chirpy2605/voron/general/DB_Ornament/README.md

# Dragon Burner Ornament for 2023

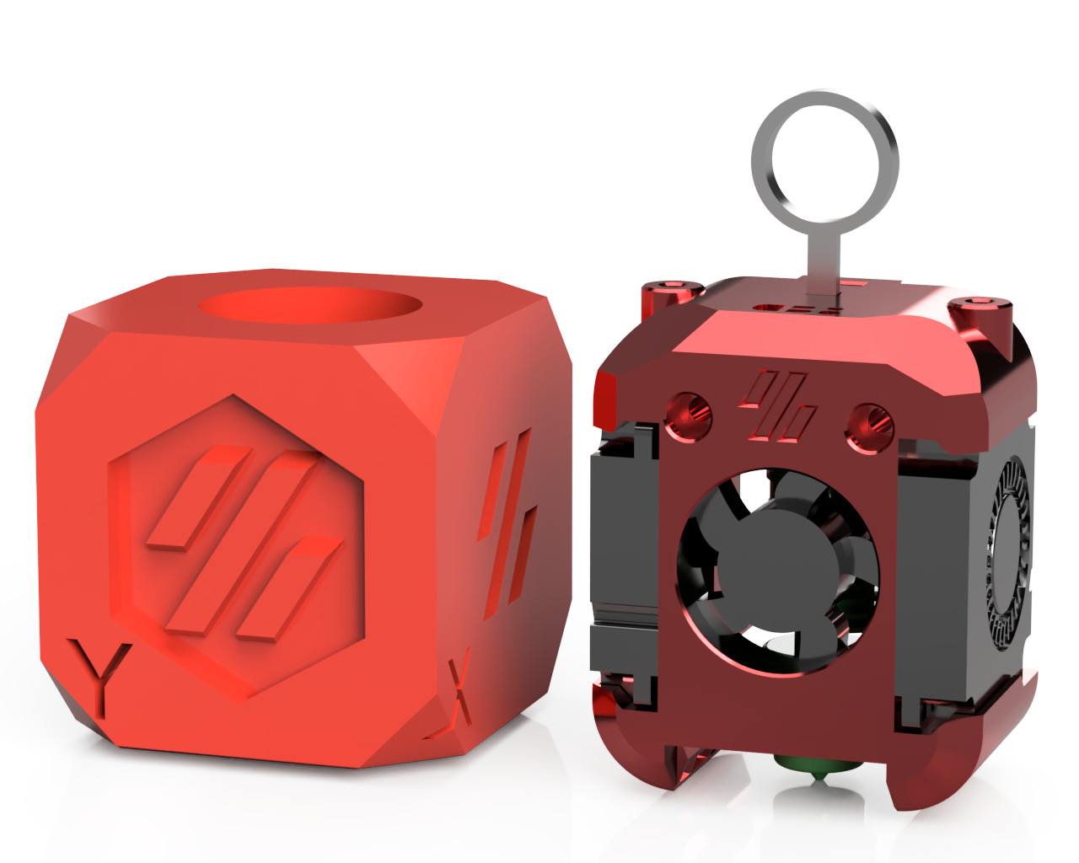
[picture p65: general/DB_Ornament/DB_Ornament.png]
Overview Image


### Assembly:

Use a small amount of super glue inside the "hotend" to stick the hanger in place once passed through the "cowl"
