chirpy2605/voron/general/Large_Voron_Mounts/README.md

These parts have moved to [Alternative Voron Mounts](../Alternative_Voron_Mounts)
