chirpy2605/voron/V0/v0.2_Stuff/readme.md

# Voron v0.2 Mods:

#### Z Cover to prevent stuff falling through the chamber into the lead screw hole:

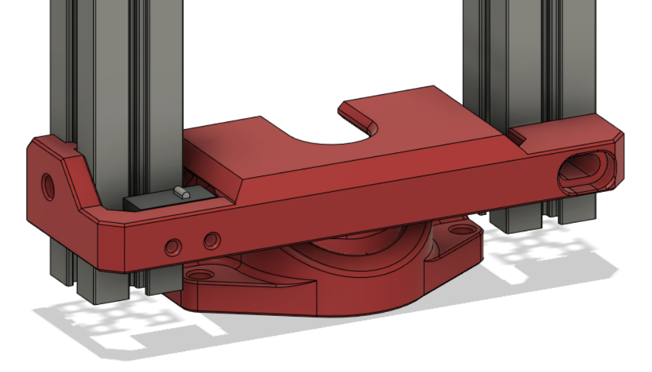
[picture p125: V0/v0.2_Stuff/images/[a]_Z_Cover.png]
Z Cover


---

#### Rear Panel Hex Mesh mod to [Printables](https://www.printables.com/model/153997-voron-v01-rear-panel-with-better-cooling):

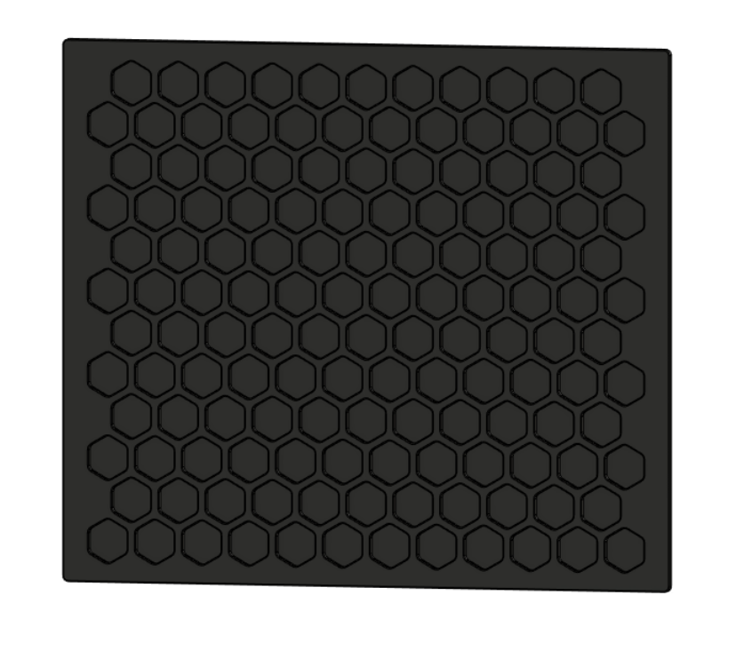
[picture p126: V0/v0.2_Stuff/images/Rear_Panel_Hex_Mesh.png]


---

#### MGN9C X Carriage with inserts mod to [VoronUsers/printer_mods/ruiqimao/V0.2_MGN9C_X at v0.2-mgn9c · ruiqimao/VoronUsers · GitHub](https://github.com/ruiqimao/VoronUsers/tree/v0.2-mgn9c/printer_mods/ruiqimao/V0.2_MGN9C_X):

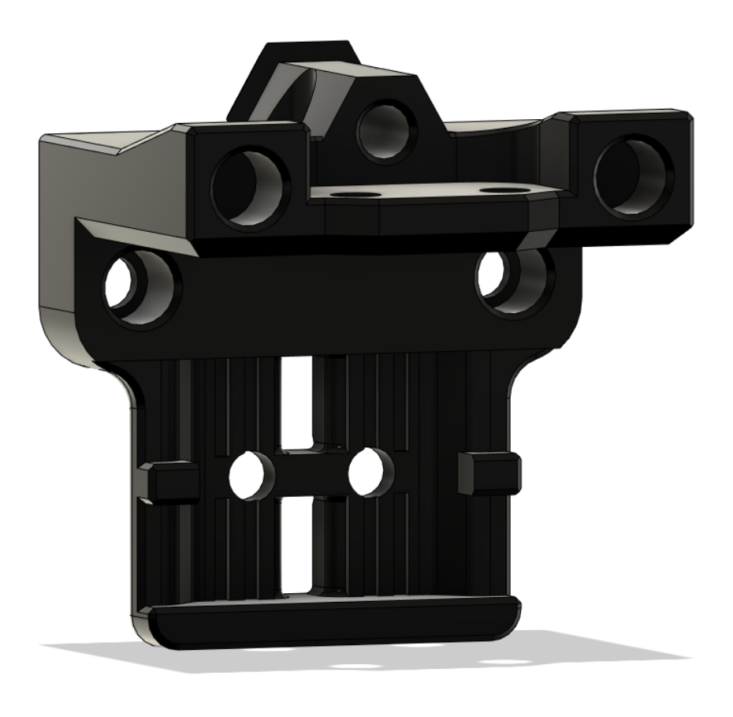
[picture p127: V0/v0.2_Stuff/images/MGN9C_X_Carriage_Inserts.png]


---

#### DIN Rail mounts:

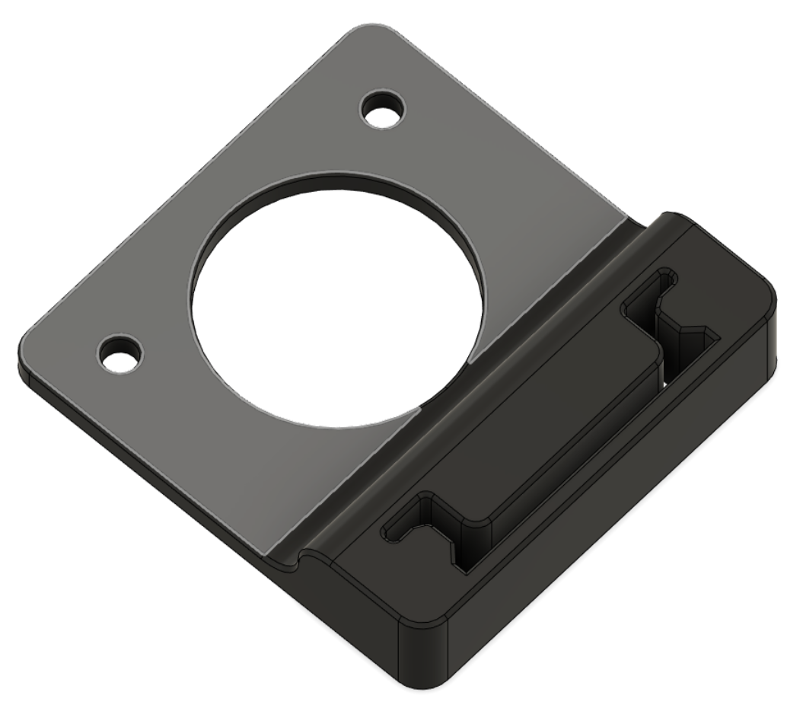
[picture p128: V0/v0.2_Stuff/images/DIN_Rail_Mount_x2.png]


---

#### Gap Seals:

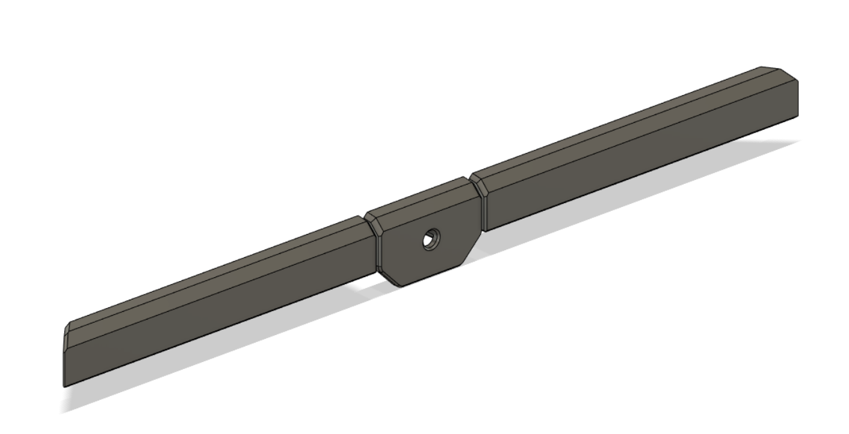
[picture p129: V0/v0.2_Stuff/images/Gap_Seal.png]
Gap Seals


---

#### Rear Skirt Keystone Mesh mod to   [VoronUsers/printer_mods/hartk1213/Voron0.2_Rear_Keystone_Skirt at master · VoronDesign/VoronUsers · GitHub](https://github.com/VoronDesign/VoronUsers/tree/master/printer_mods/hartk1213/Voron0.2_Rear_Keystone_Skirt):

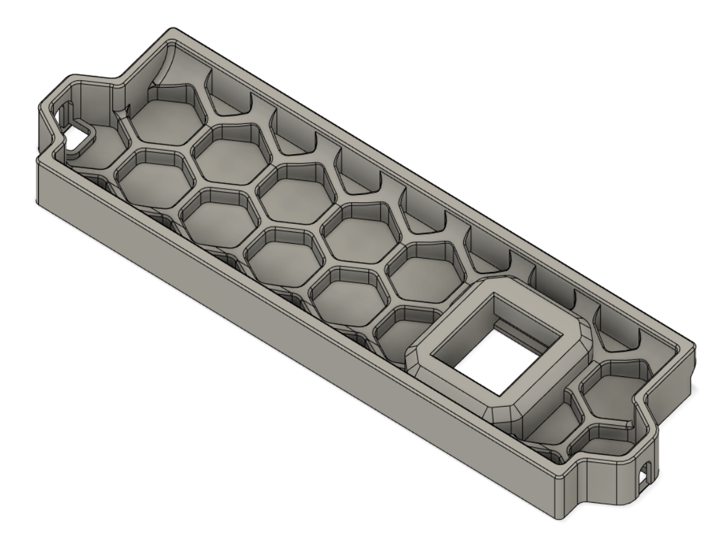
[picture p130: V0/v0.2_Stuff/images/Rear_Skirt_Keystone_Mesh.png]


---

#### Door Handle More Magnets:

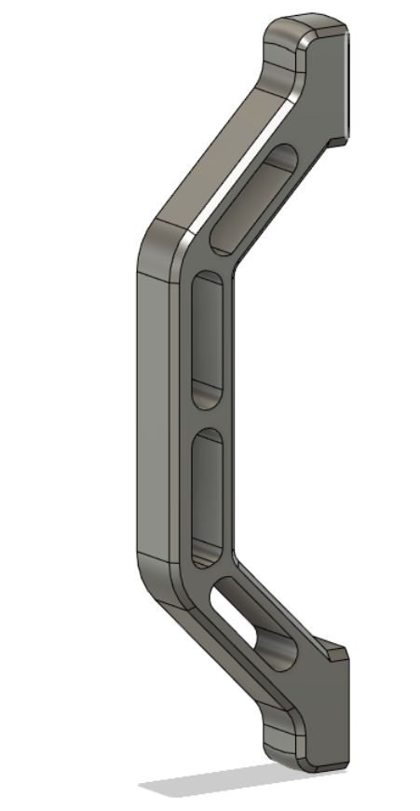
[picture p131: V0/v0.2_Stuff/images/doorhandle.png]


### BOM:

8x 6x3mm Neodymium magnets

---

#### Pi Camera 3 Mount

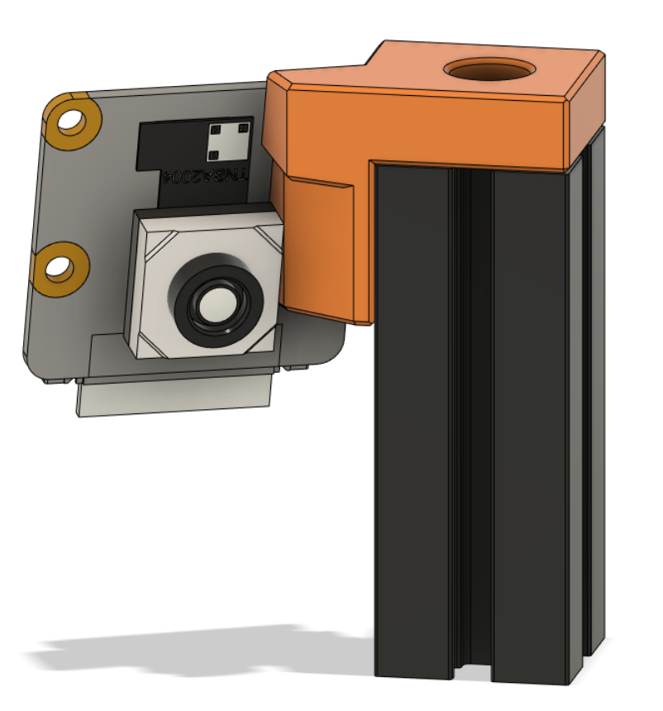
[picture p132: V0/v0.2_Stuff/images/picamera3.png]
