chirpy2605/voron/V0/Tophat_Cat_Flap/README.md

# Tophat Cat Flap

- Tophat clamped closed?

- Want to get to the toolhead?

- Can't quite reach?

- Don't want to have to open the cam locks?

- Don't want to lose *all* that chamber heat?

#### You need a Tophat Cat Flap!

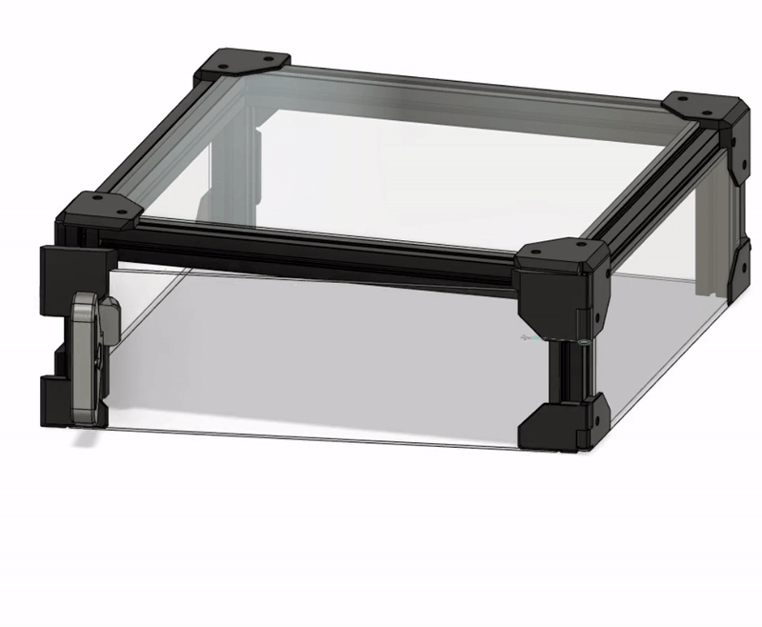
[picture p133: V0/Tophat_Cat_Flap/images/tophat_catflap.gif]


## Bom:

- 1x M3x30mm SHCS/BHCS screw

- 1 x M3x18mm SHCS/BHCS screw

- 4 x 6x3mm Neodymium magnets

- VHB tape

- Printed parts (Voron printing specs)

## Additional Notes:

The door fits and lifts on and off in exactly the same way as the main printer door
