chirpy2605/voron/general/MiniMouse/README.md

# MiniMouse Direct Extruder

The MiniMouse is a direct drive extruder designed for the Voron v0.1

It uses the mounts from the [Mini-AfterSherpa](https://github.com/KurioHonoo/Mini-AfterSherpa) and works with both of my toolheads: [Dragon Burner](https://github.com/waytotheweb/voron/tree/main/V0/Dragon_Burner) and [5015 Toolhead](https://github.com/waytotheweb/voron/tree/main/V0/5015_Toolhead)

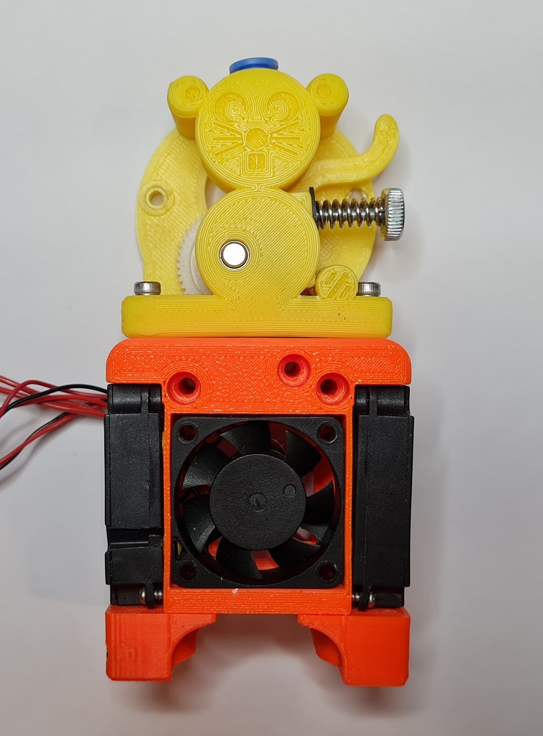
[picture p152: general/MiniMouse/images/minimousemount.jpg]
minimousemount


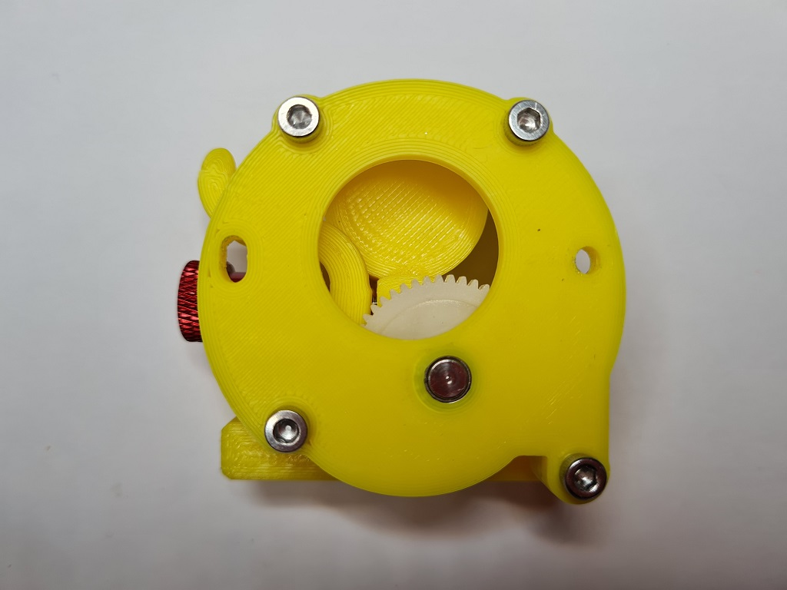
[picture p153: general/MiniMouse/images/rear.jpg]
rear


Please Note: This is a Work In Progress and things will likely change as issues are fixed and enhancements are made.

## Printing:

- Use the Voron defaults and print in ABS or better
- The parts are orientated correctly in the STLs

## BOM:

- 4x M3x6 or 8mm SHCS/BHCS (for securing the front to the back of the extruder)
- 1x M3x25mm  SHCS/BHCS (for the lever pivot)
- 5x Brass heat inserts (4 for the mount, 1 for the lever)
- 1x BMG Extruder Kit 
- 1x NEMA14 36mm pancake Motor with 10 tooth gear
- 1x ECAS04 Embedded Collet (optional)

## Sources:

- BMG Extruder Kit [AliExpress](https://www.aliexpress.com/item/4000021186440.html)
- NEMA14 36mm pancake Motor with 10 tooth gear [AliExpress](https://www.aliexpress.com/item/1005003056906725.html)
- ECAS04 Embedded Collet [Aliexpress](https://www.aliexpress.com/item/1005002538357279.html)

## CAD:

Will be published once released from WIP.

## Assembly:

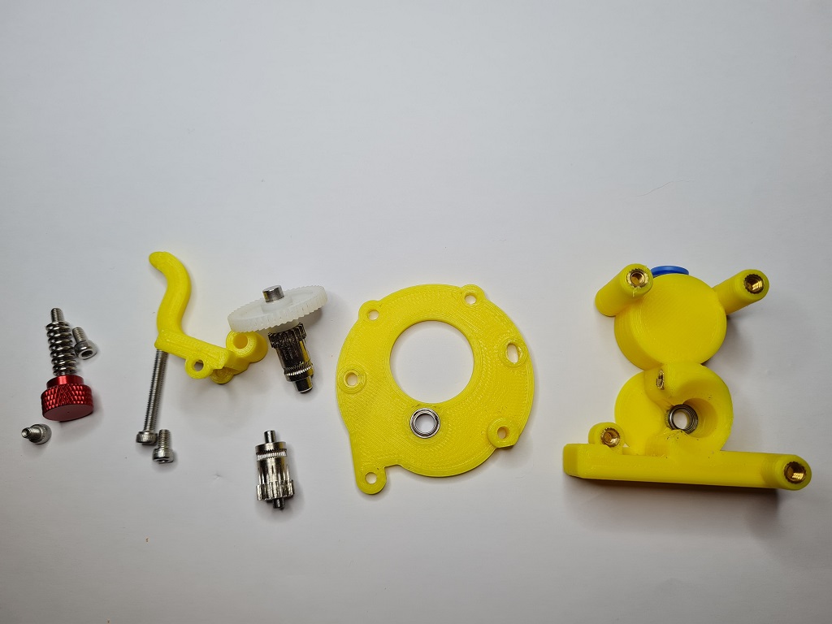
[picture p154: general/MiniMouse/images/parts.jpg]
parts


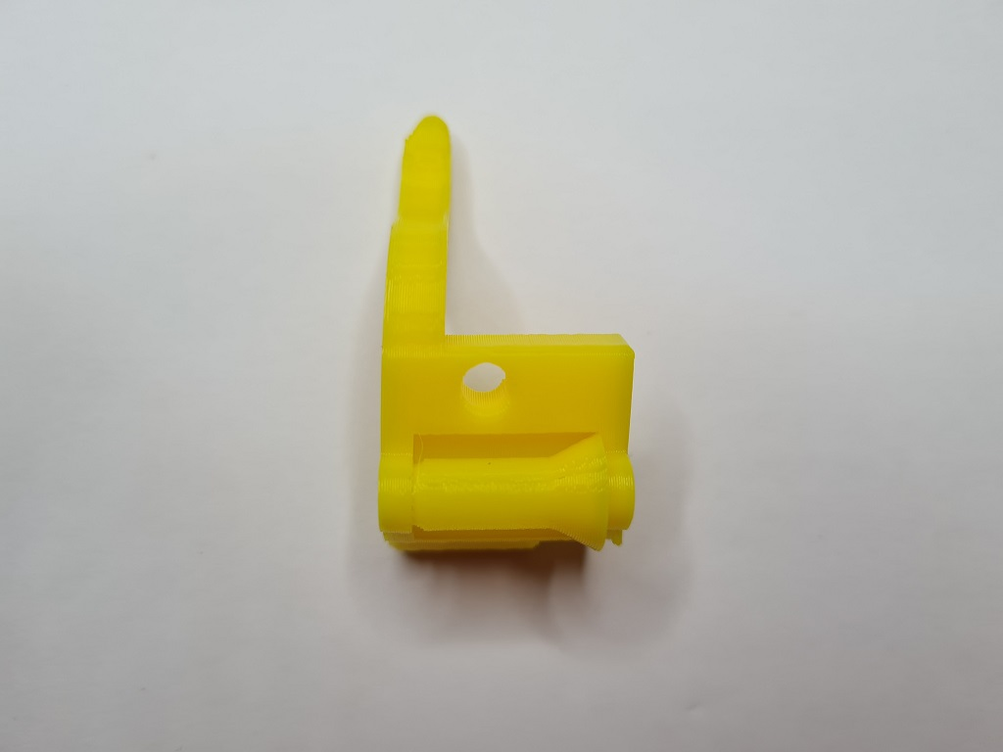
[picture p155: general/MiniMouse/images/lever.jpg]
lever


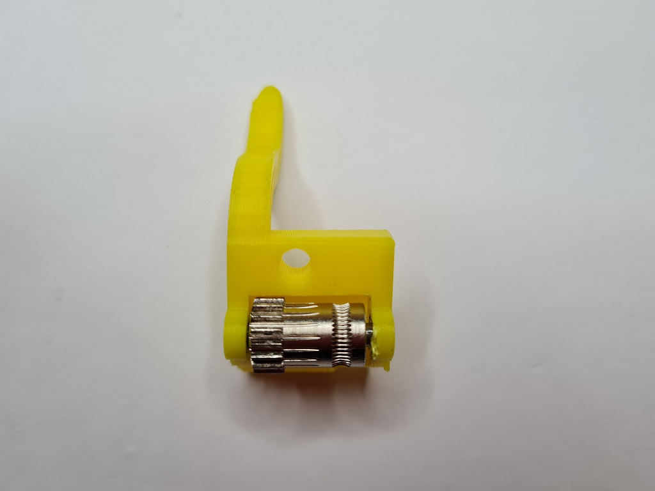
[picture p156: general/MiniMouse/images/leverfit.jpg]
leverfit


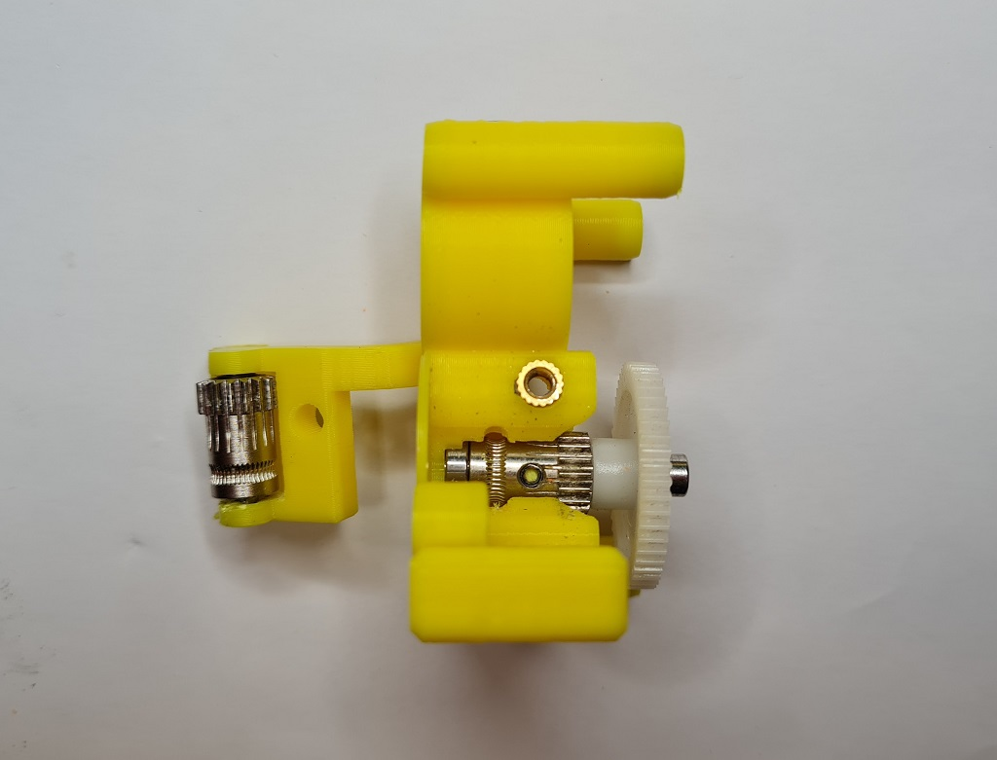
[picture p157: general/MiniMouse/images/maingear.jpg]
maingear


rear

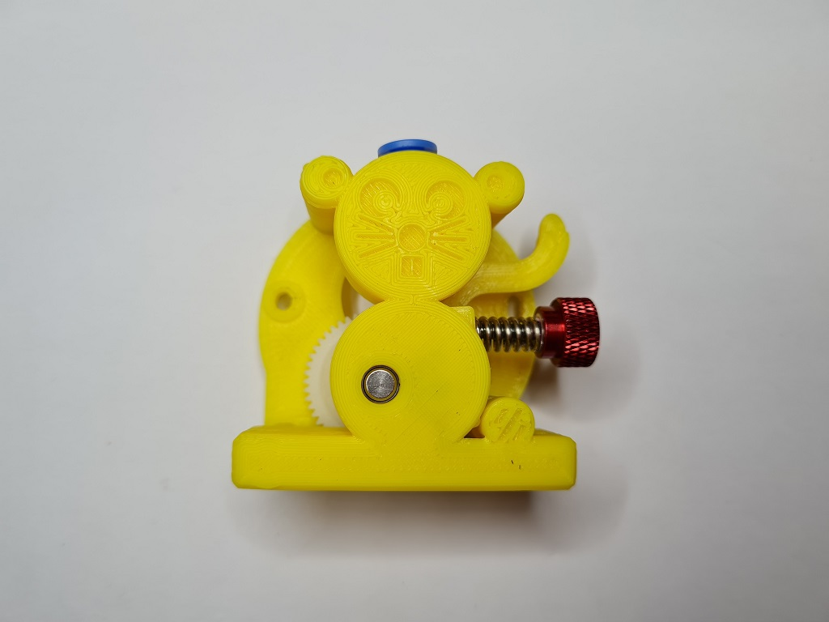
[picture p158: general/MiniMouse/images/minimouse.jpg]
minimouse
