chirpy2605/voron/general/RoundAbout/README.md

# RoundAbout Direct Extruder

The RoundAbout is a direct drive extruder designed for the Voron v0.1 that uses the guts of an Orbiter v2.0

It uses the mounts from the [Mini-AfterSherpa](https://github.com/KurioHonoo/Mini-AfterSherpa) and was designed to complement the [5015 Toolhead](https://github.com/waytotheweb/voron/tree/main/V0/5015_Toolhead) toolhead. It can be used on any toolhead that uses the [Mini-AfterSherpa](https://github.com/KurioHonoo/Mini-AfterSherpa) design.

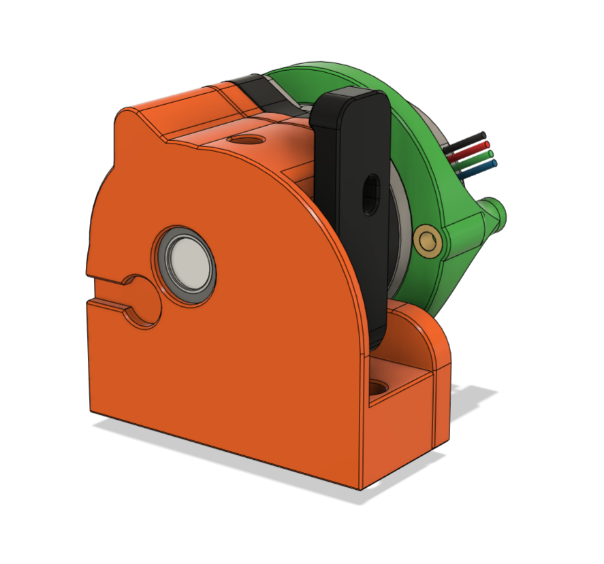
[picture p159: general/RoundAbout/images/orbfront.png]
orbfront


Please Note: This is a Work In Progress and things will likely change as issues are fixed and enhancements are made.

## Printing:

- Use the Voron defaults and print in ABS or better
- The parts are orientated correctly in the STLs

## BOM:

- 8x Brass heat inserts (6 for the front, 2 for the support ring)
- 1x Orbiter v2 Extruder
- 1x NEMA14 36mm pancake Motor with 10 tooth gear
- 1x UM2 Collet (optional)

## Sources:

- Orbiter v2 internals which you'll probably need a complete extruder to dismantle
- UM2 Embedded Collet, e.g. [E3D](https://e3d-online.com/products/embedded-bowden-collet-for-metal-1-75mm)

## CAD:

Will be published once released from WIP.

## Assembly:

Instructions to follow...

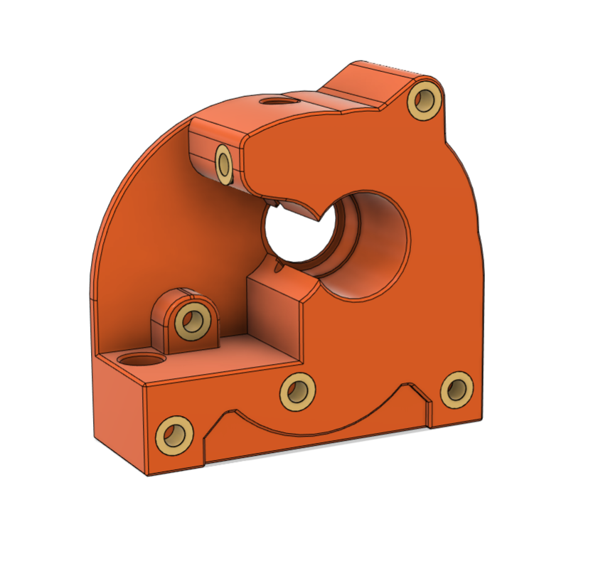
[picture p160: general/RoundAbout/images/frontinserts.png]
frontinserts


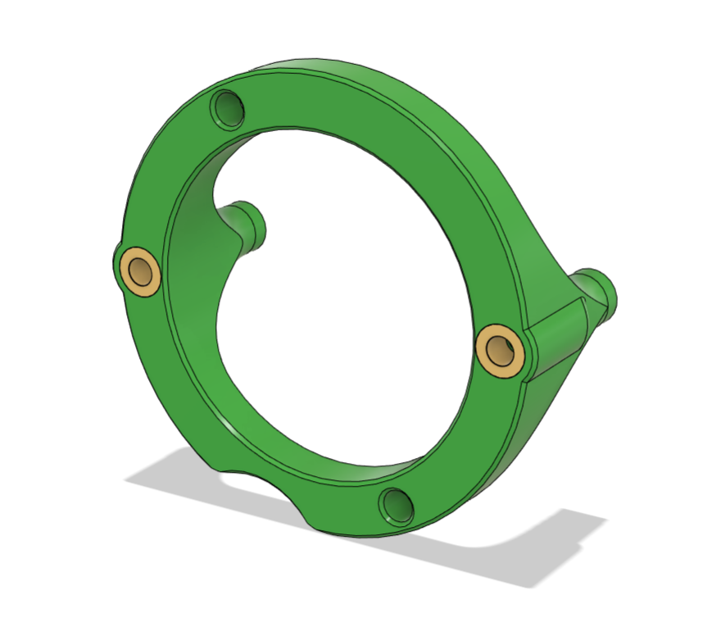
[picture p161: general/RoundAbout/images/supportringinserts.png]
supportringinserts


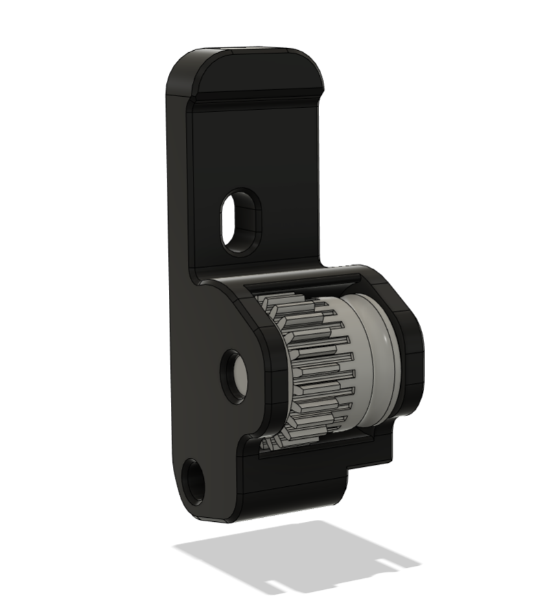
[picture p162: general/RoundAbout/images/latch.png]
latch


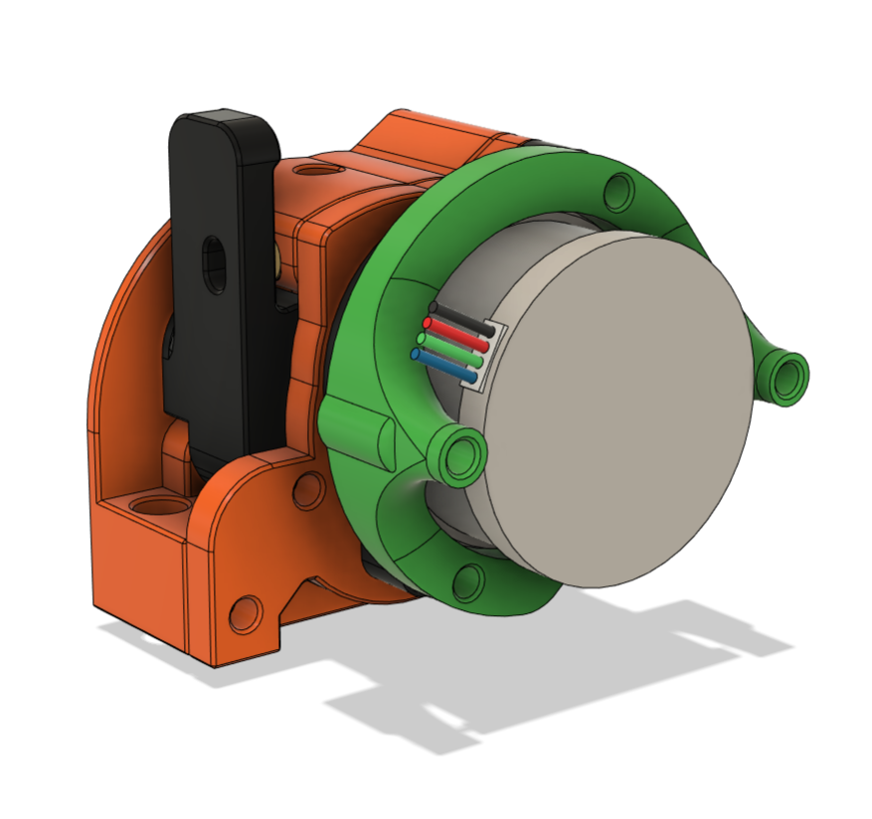
[picture p163: general/RoundAbout/images/orbback.png]
orbback
