chirpy2605/voron/general/Alternative_Voron_Mounts/Modified_Mounts/Switchwire/README.md

# Switchwire Replacement mount

**NOTE: Do not forget to adjust your nozzle offset or calibrate your probe after adding any of these mounts or you will damage your flex plate**

### STLs:

- [DB_SW_Carriage_Left.stl](STLs/DB_SW_Carriage_Left.stl)

- [DB_SW_Carriage_Right.stl](STLs/DB_SW_Carriage_Right.stl)

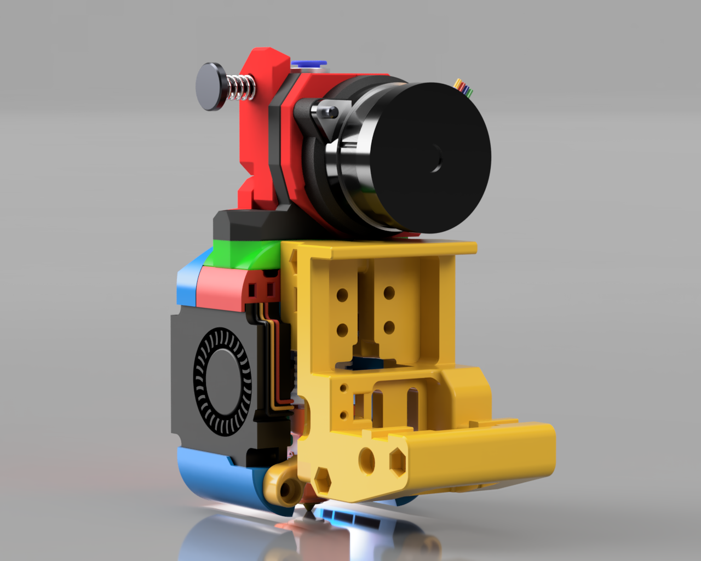
[picture p228: general/Alternative_Voron_Mounts/images/Switchwire.png]


This mount replaces the stock mount to allow secure attachment of the Dragon/Rapid Burner toolhead the printer with addition of two lower mount points to rear of the ducts on the toolhead.

## Contact:

Please provide feedback to me on Discord @chirpy__ 

## v1 Changelog:

2023-12-04 Published CAD
