chirpy2605/voron/general/Alternative_Voron_Mounts/Old_Versions/README.md

# Boop Mount for Dragon and Rapid Burner Toolheads

This mount is designed to be used with Boop v4 Beta. It is a modification of the stock boop_front.stl so that it will work with the Dragon Burner and Rapid Burner toolheads.

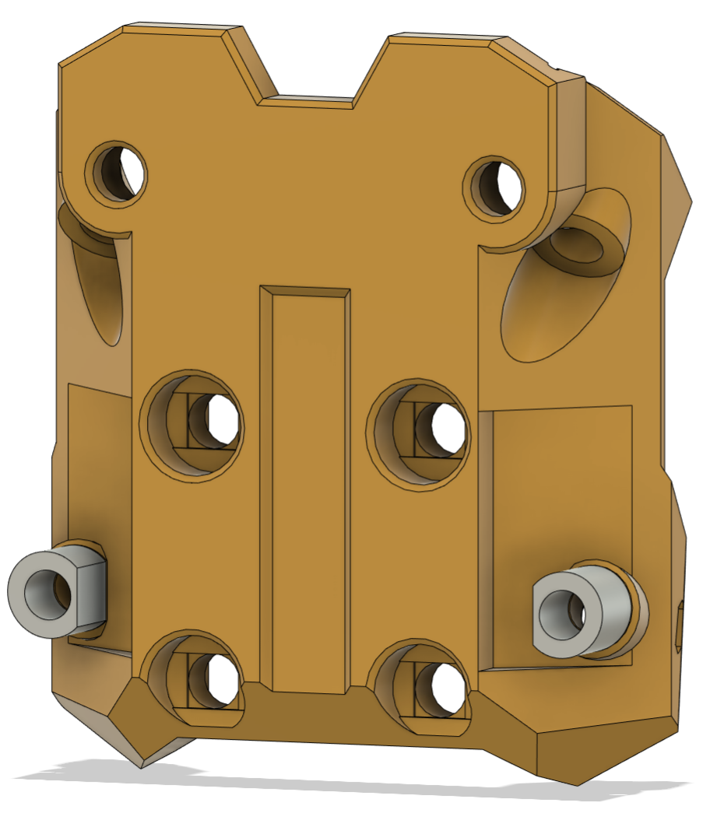
[picture p232: general/Alternative_Voron_Mounts/Old_Versions/images/boop_front.png]


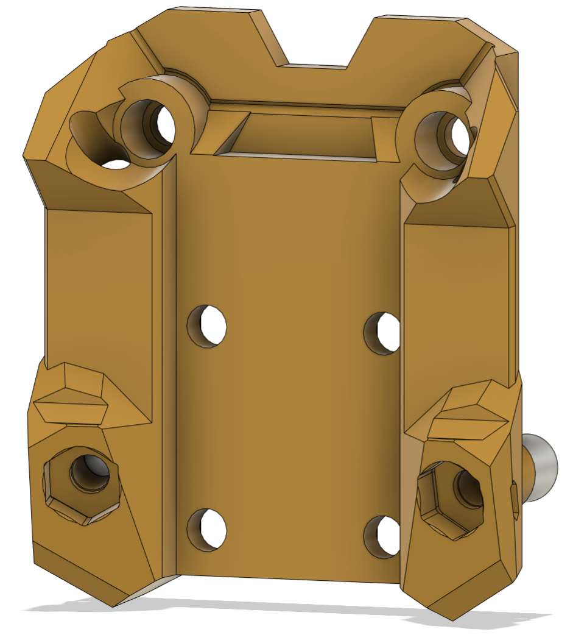
[picture p233: general/Alternative_Voron_Mounts/Old_Versions/images/boop_rear.png]


Once printed, remove the two small supports (silver in the images above).

For the angled screw holes that go between this part and the upper sensor part, you must use BHCS (Button Head) screws. This is to prevent contact issues between the screws used and the 4010 fans.

You _may_ have to snip off the screw lugs on the rear top of the 4010 fans for this part to fit.

You do **not** lose any additional Y from the stock boop_front part.

## Contact:

Please provide feedback to me on Discord @chirpy__

## Changelog:

2023-07-23 Published CAD
