chirpy2605/voron/V0/Dragon_Burner/Old_Versions/v1/CAD/README.md

TinkerCAD is available (good luck, you'll need it):

Cowls: https://www.tinkercad.com/things/0yGa4jtiggI

Fan Ducts: https://www.tinkercad.com/things/5yuoEweOFLc
