chirpy2605/voron/V0/5015_Toolhead/images/hotendfan.jpg

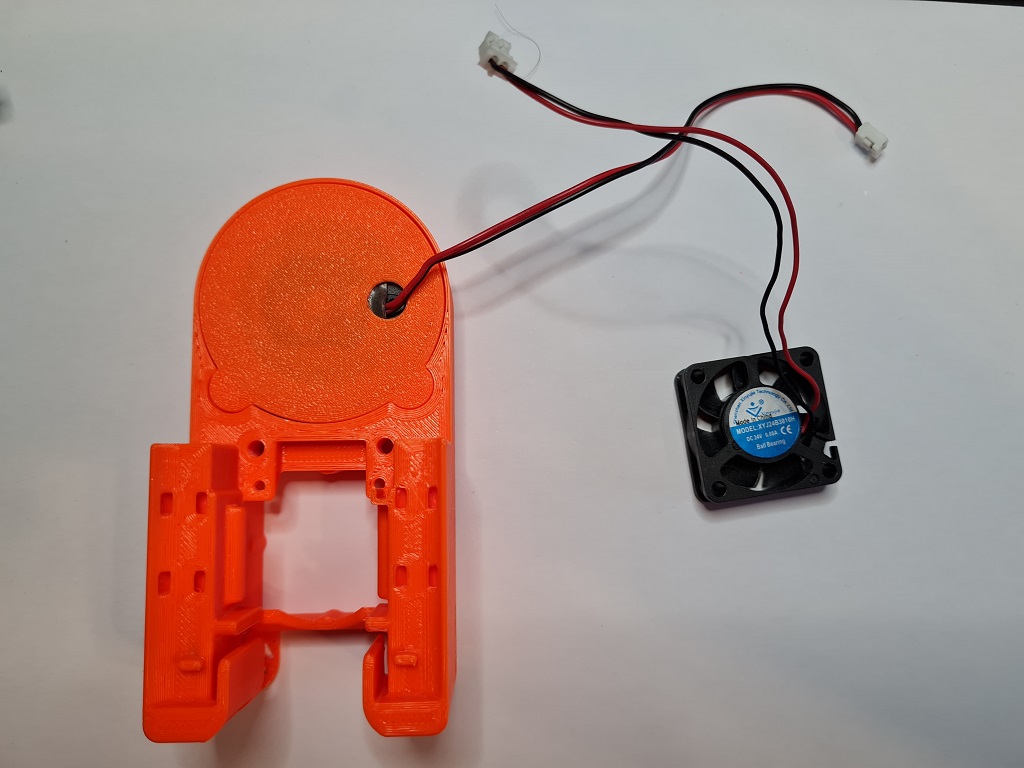
V0/5015_Toolhead/images/hotendfan.jpg
