chirpy2605/voron/V0/5015_Toolhead/images/mounted1.jpg

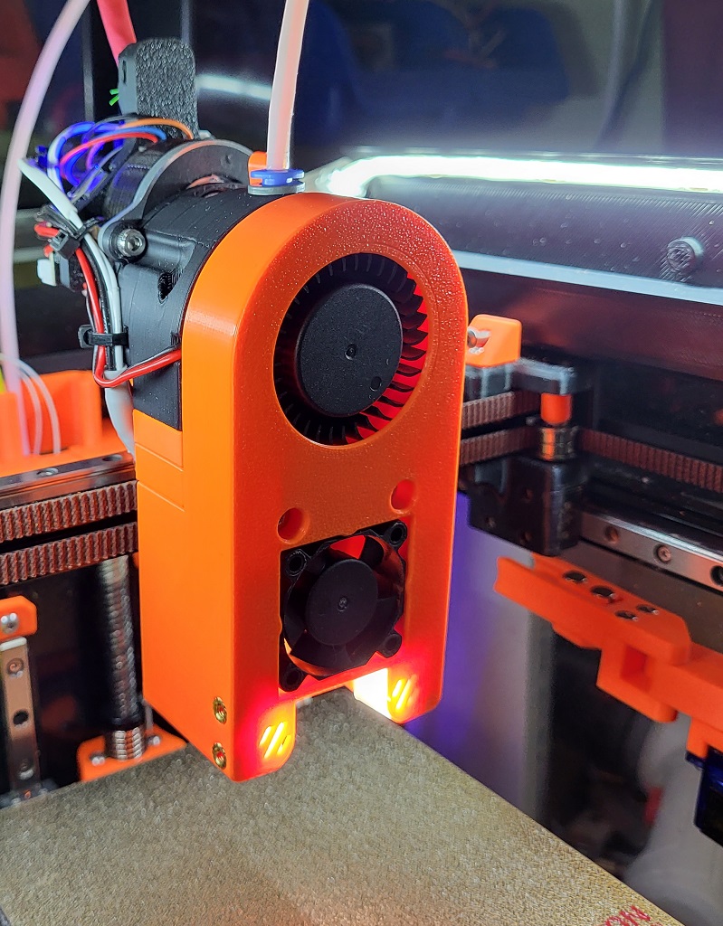
V0/5015_Toolhead/images/mounted1.jpg
