chirpy2605/voron/V0/Dragon_Burner/images/dbv6.png

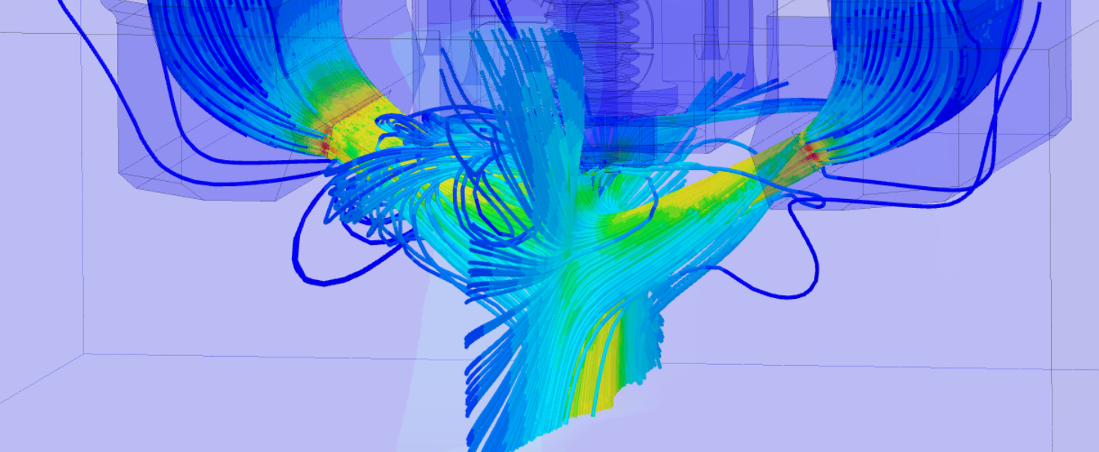
V0/Dragon_Burner/images/dbv6.png
