chirpy2605/voron/V0/Dragon_Burner/images/dbv8.png

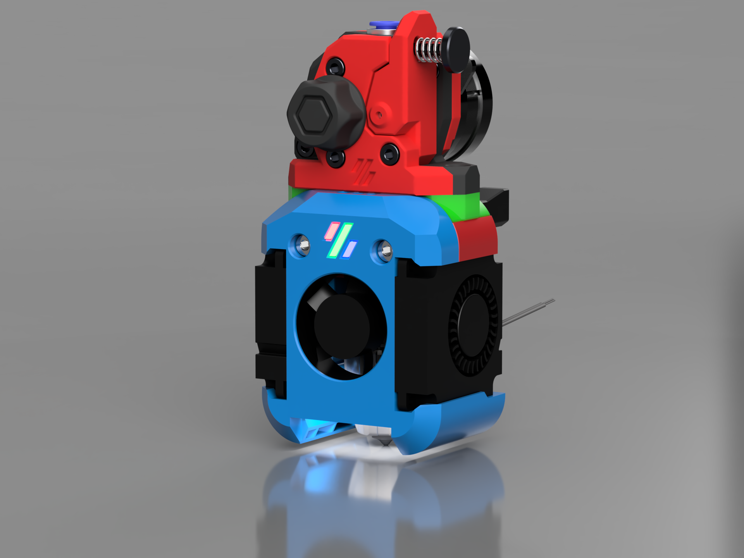
V0/Dragon_Burner/images/dbv8.png
