chirpy2605/voron/V0/Mailbox/images/extruder_mount.png

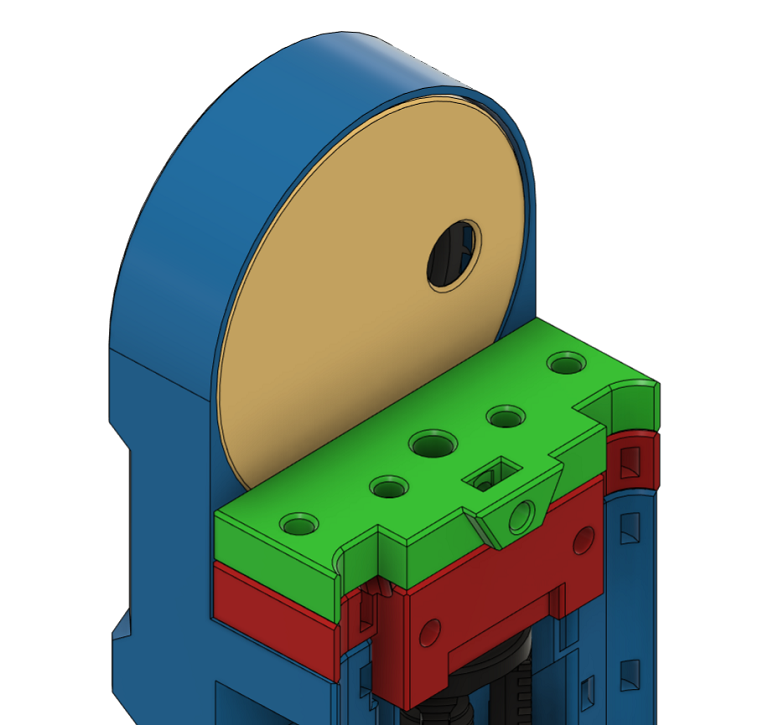
V0/Mailbox/images/extruder_mount.png
