chirpy2605/voron/V0/Rainbow_Dragon/images/gears.png

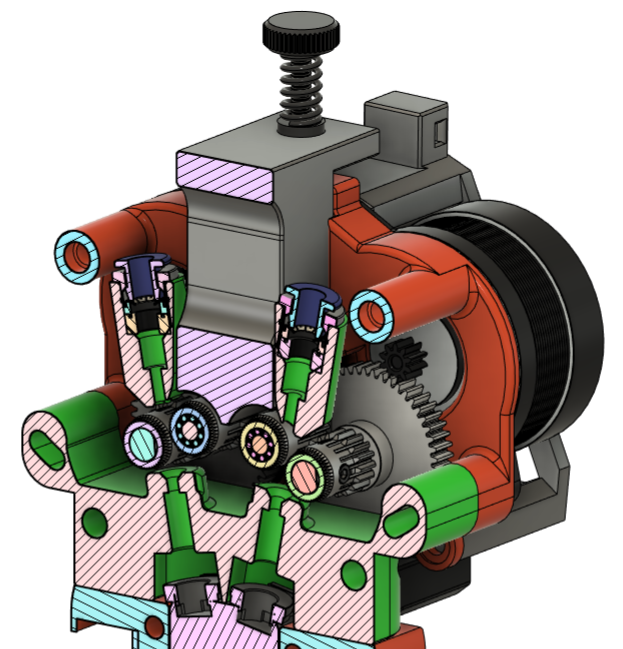
V0/Rainbow_Dragon/images/gears.png
