chirpy2605/voron/V0/Rapid_Burner/images/goliathback.png

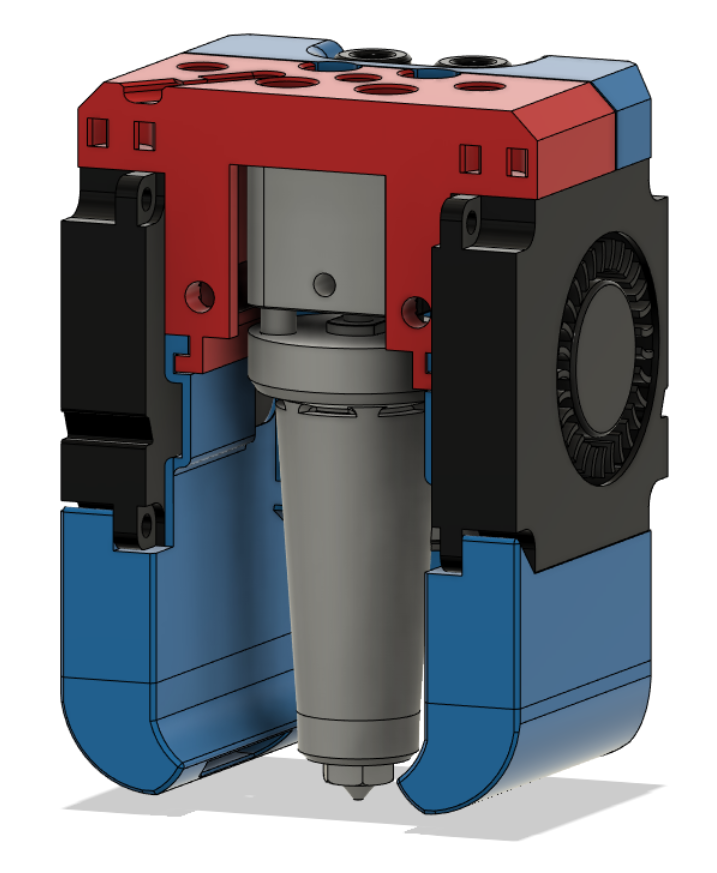
V0/Rapid_Burner/images/goliathback.png
