chirpy2605/voron/V0/Rapid_Burner/images/goliathfront.png

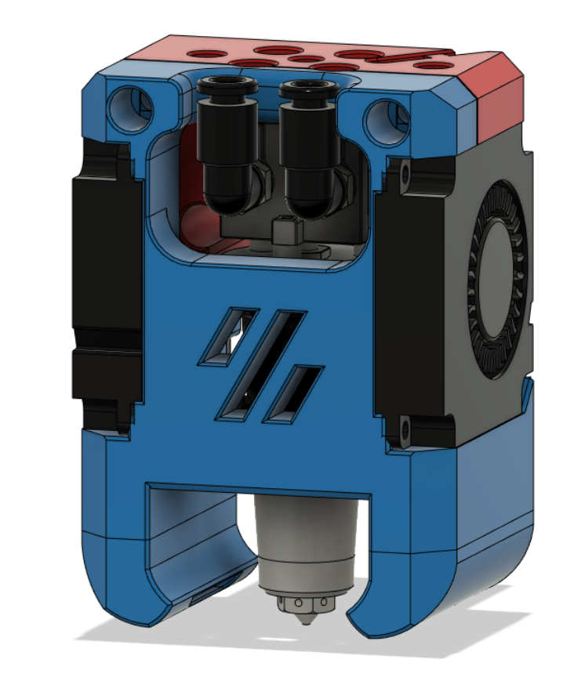
V0/Rapid_Burner/images/goliathfront.png
