chirpy2605/voron/general/Alternative_Voron_Mounts/Modified_Mounts/Micron_Pandora/STLs/Spacer_3mm/Main_Spacer.stl

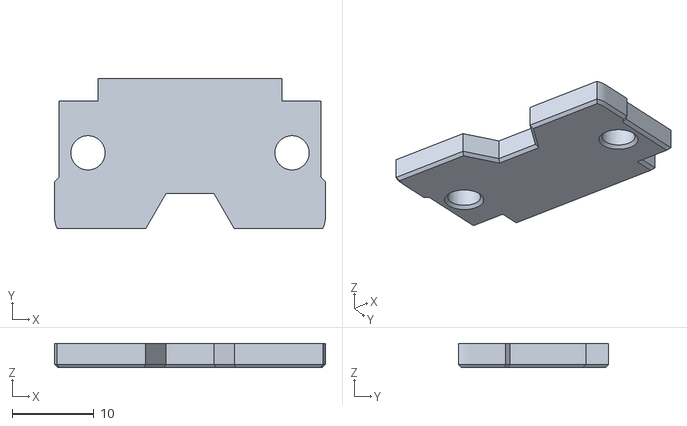
[picture p289: CAD file, 2023-12-04]
general/Alternative_Voron_Mounts/Modified_Mounts/Micron_Pandora/STLs/Spacer_3mm/Main_Spacer.stl
33.2 x 18.4 x 3.00
