chirpy2605/voron/general/Alternative_Voron_Mounts/Modified_Mounts/Tap/STLs/Tap_Main_Spacer_New_Top.stl

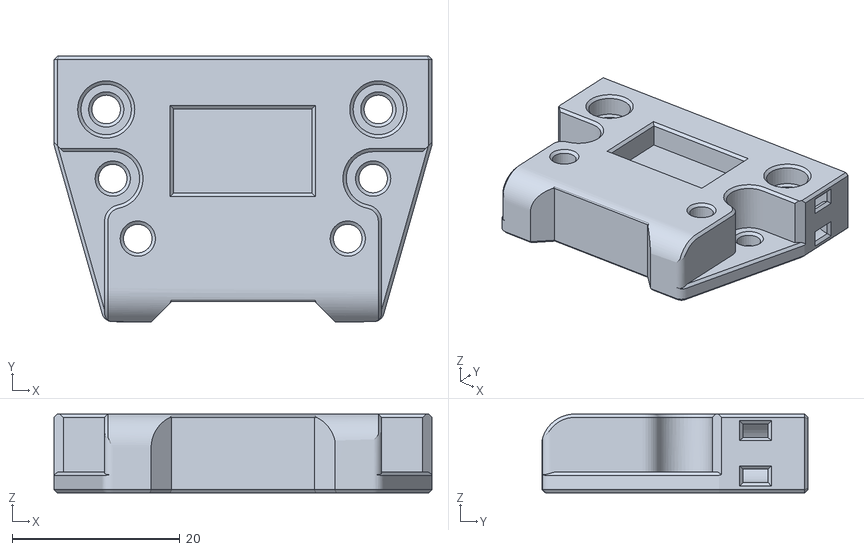
[picture p290: CAD file, 2024-05-27]
general/Alternative_Voron_Mounts/Modified_Mounts/Tap/STLs/Tap_Main_Spacer_New_Top.stl
45.0 x 31.6 x 9.40
