chirpy2605/voron/general/Alternative_Voron_Mounts/Modified_Mounts/Micron_Pandora/STLs/Spacer_5mm/Main_Spacer.stl

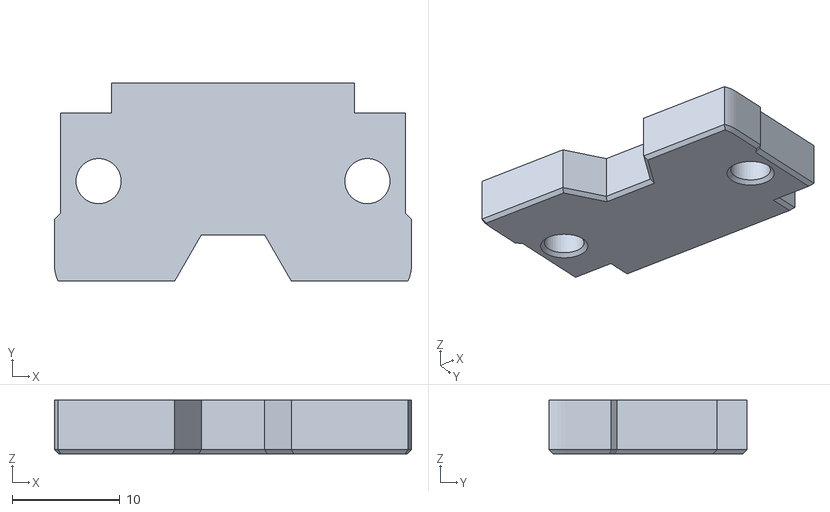
[picture p291: CAD file, 2023-12-04]
general/Alternative_Voron_Mounts/Modified_Mounts/Micron_Pandora/STLs/Spacer_5mm/Main_Spacer.stl
33.2 x 18.4 x 5.00
