chirpy2605/voron/general/Alternative_Voron_Mounts/Modified_Mounts/Tap/STLs/Tap_Main_Spacer_New_Bottom.stl

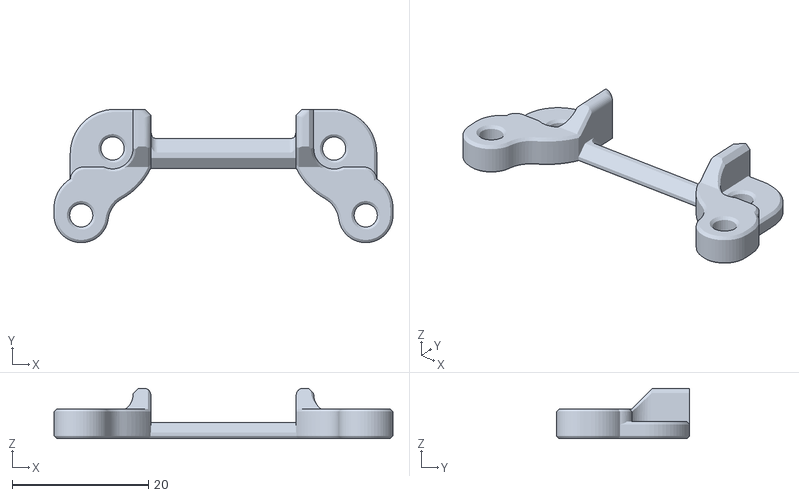
[picture p292: CAD file, 2024-05-27]
general/Alternative_Voron_Mounts/Modified_Mounts/Tap/STLs/Tap_Main_Spacer_New_Bottom.stl
49.8 x 19.6 x 7.40
