chirpy2605/voron/general/Alternative_Voron_Mounts/Modified_Mounts/V1_V2/STLs/Probe_Mounts/KlickyNG_Main_Mount.stl

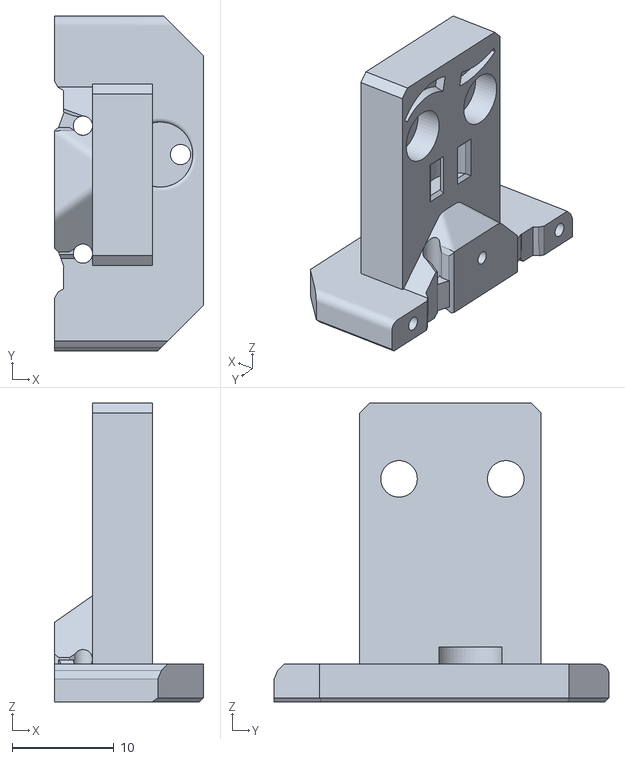
[picture p293: CAD file, 2023-12-10]
general/Alternative_Voron_Mounts/Modified_Mounts/V1_V2/STLs/Probe_Mounts/KlickyNG_Main_Mount.stl
14.7 x 33.0 x 29.4
