chirpy2605/voron/V0/v0.2_Stuff/STLs/Door Handle_Main.stl

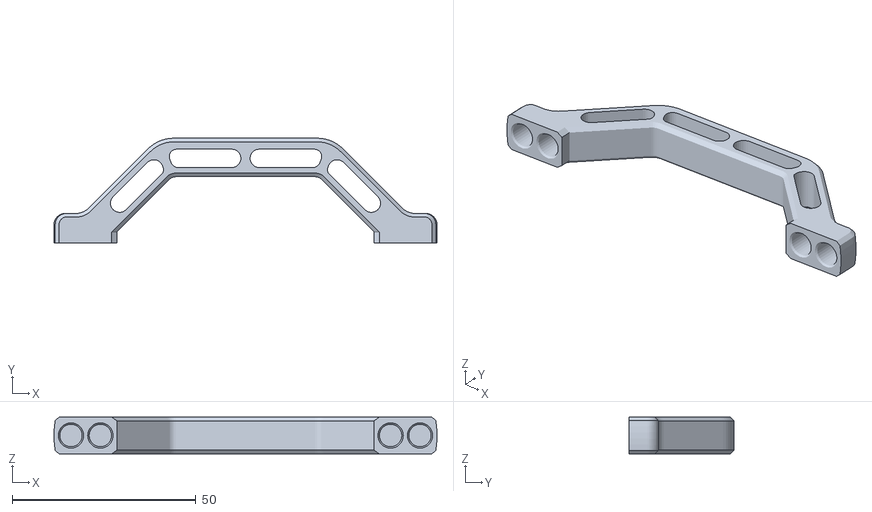
[picture p294: CAD file, 2023-03-01]
V0/v0.2_Stuff/STLs/Door Handle_Main.stl
104.3 x 28.5 x 10.0
