chirpy2605/voron/general/Alternative_Voron_Mounts/Modified_Mounts/Tap/STLs/Tap_Main_Spacer.stl

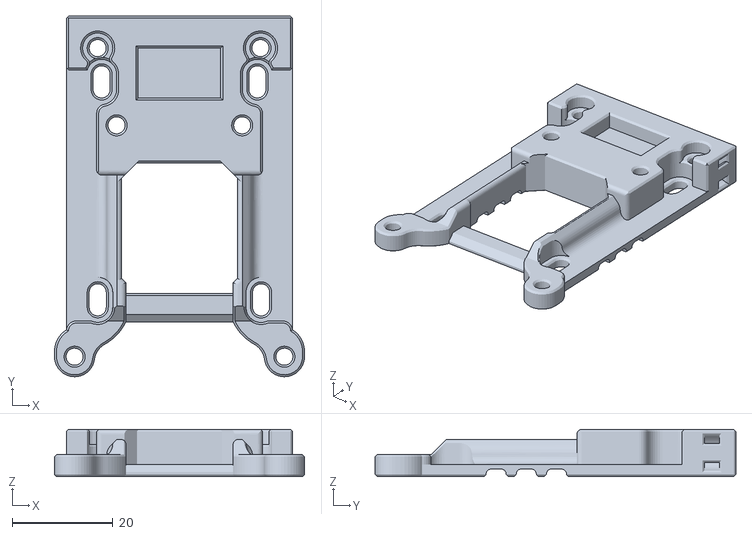
[picture p295: CAD file, 2023-11-12]
general/Alternative_Voron_Mounts/Modified_Mounts/Tap/STLs/Tap_Main_Spacer.stl
49.8 x 71.8 x 9.40
