chirpy2605/voron/general/Alternative_Voron_Mounts/Extended_Extruder_Mounts/Rapid_Burner/Tap/LGX_Mount.stl

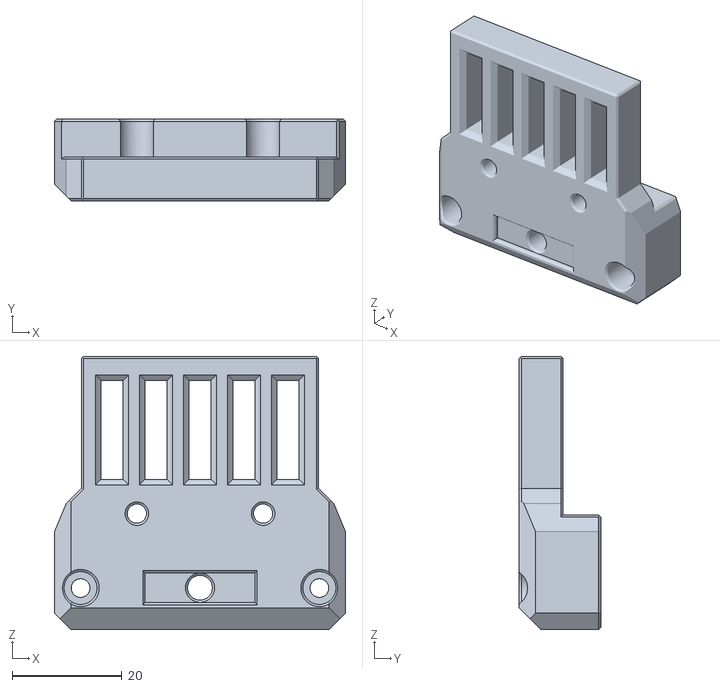
[picture p297: CAD file, 2023-05-25]
general/Alternative_Voron_Mounts/Extended_Extruder_Mounts/Rapid_Burner/Tap/LGX_Mount.stl
53.0 x 14.9 x 49.8
