chirpy2605/voron/general/Alternative_Voron_Mounts/Modified_Mounts/Boop/STLs/Boop_Front.stl

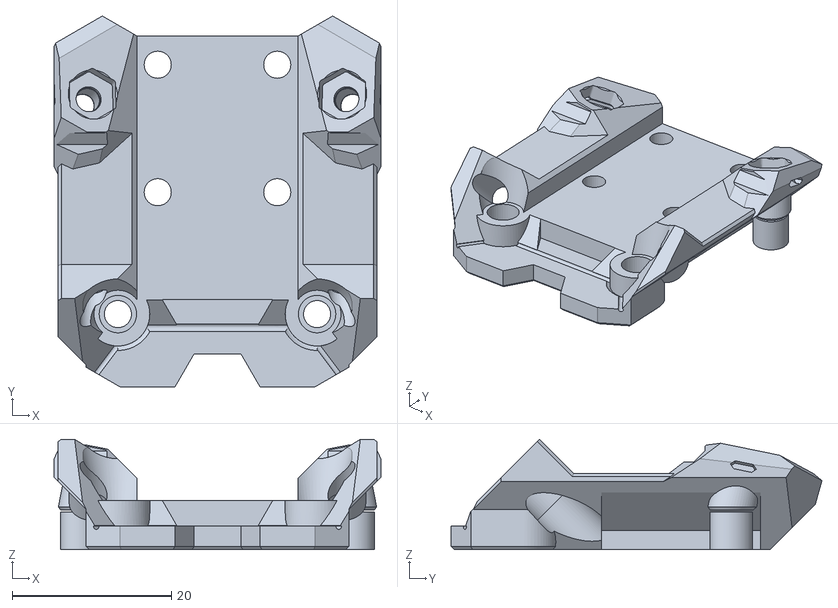
[picture p298: CAD file, 2023-11-12]
general/Alternative_Voron_Mounts/Modified_Mounts/Boop/STLs/Boop_Front.stl
41.0 x 46.6 x 13.9
