chirpy2605/voron/general/Alternative_Voron_Mounts/Modified_Mounts/Micron_Pandora/STLs/Spacer_5mm/Top_Spacer.stl

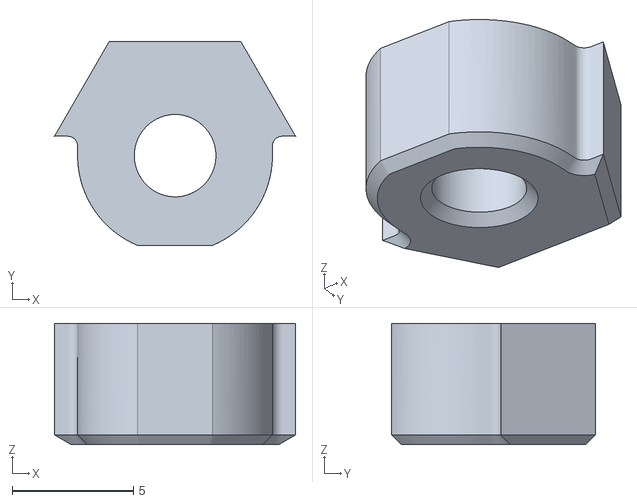
[picture p299: CAD file, 2023-12-04]
general/Alternative_Voron_Mounts/Modified_Mounts/Micron_Pandora/STLs/Spacer_5mm/Top_Spacer.stl
9.93 x 8.40 x 5.00
