chirpy2605/voron/general/Alternative_Voron_Mounts/Modified_Mounts/Micron_Pandora/STLs/X_Carriage_MGN9C_Micron_Short.stl

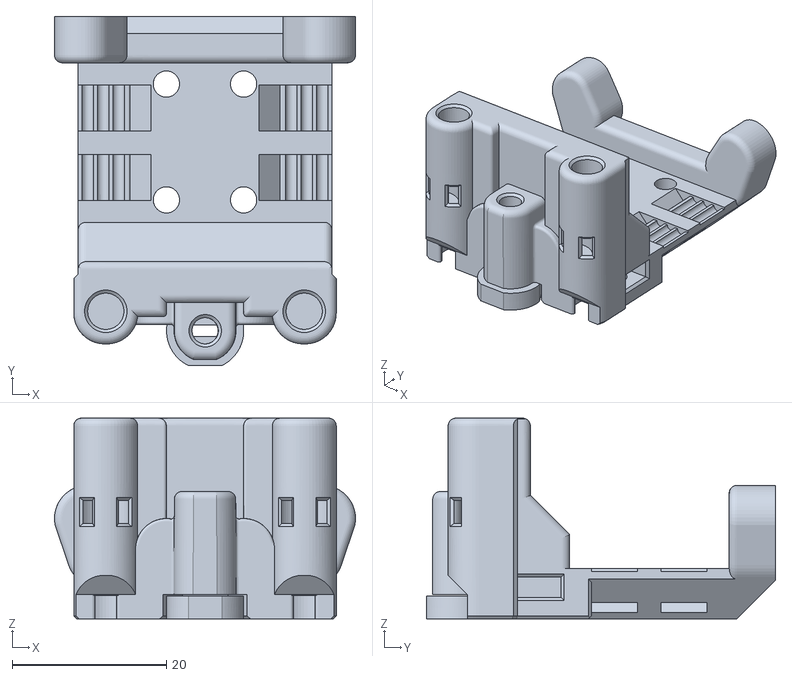
[picture p300: CAD file, 2024-05-27]
general/Alternative_Voron_Mounts/Modified_Mounts/Micron_Pandora/STLs/X_Carriage_MGN9C_Micron_Short.stl
39.0 x 45.2 x 26.0
