chirpy2605/voron/general/Alternative_Voron_Mounts/Modified_Mounts/Switchwire/STLs/DB_SW_Carriage_Right.stl

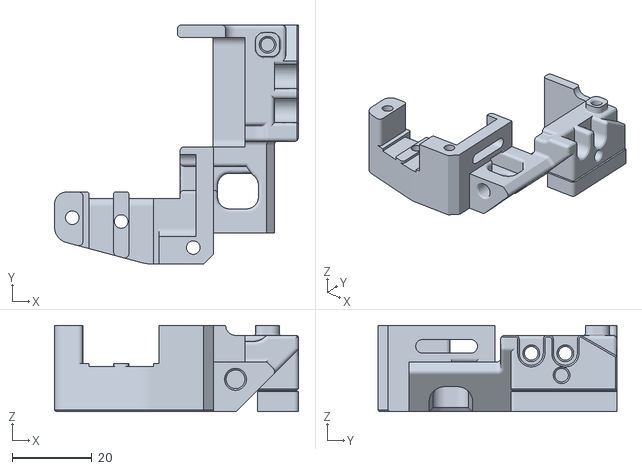
[picture p301: CAD file, 2023-11-18]
general/Alternative_Voron_Mounts/Modified_Mounts/Switchwire/STLs/DB_SW_Carriage_Right.stl
61.1 x 59.8 x 21.6
