chirpy2605/voron/general/Alternative_Voron_Mounts/Modified_Mounts/v0.2/altSTLs/X_Carriage_MGN7H_Switch.stl

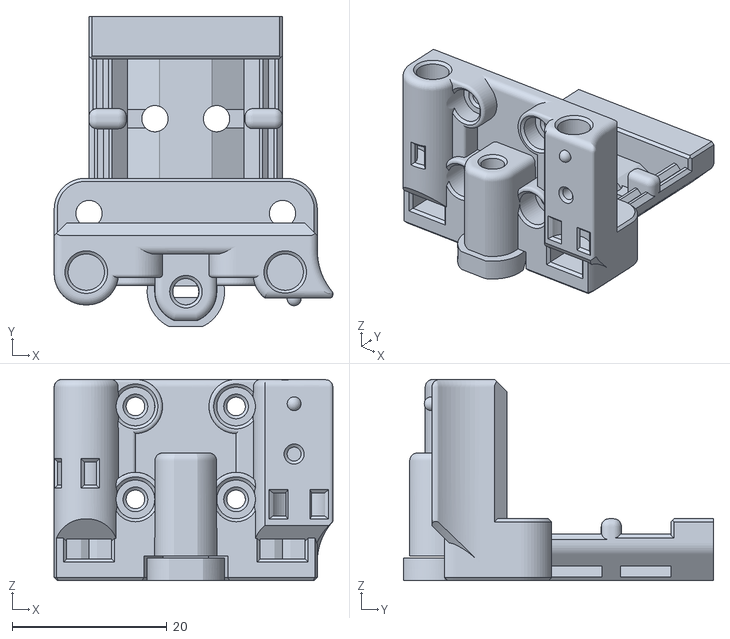
[picture p302: CAD file, 2024-01-30]
general/Alternative_Voron_Mounts/Modified_Mounts/v0.2/altSTLs/X_Carriage_MGN7H_Switch.stl
36.0 x 40.1 x 26.0
