chirpy2605/voron/general/Alternative_Voron_Mounts/Modified_Mounts/V1_V2/STLs/Carriage_Bases/Carriage_Base_Long.stl

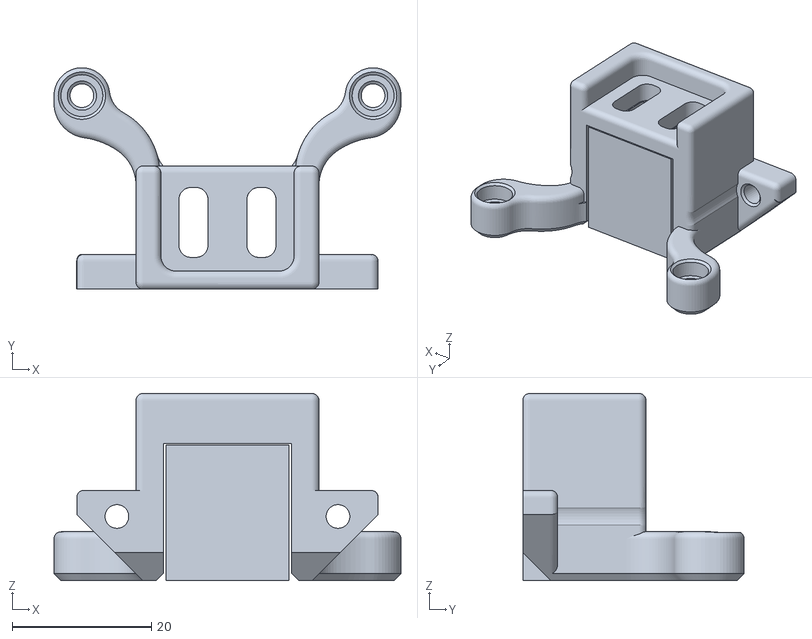
[picture p303: CAD file, 2024-08-29]
general/Alternative_Voron_Mounts/Modified_Mounts/V1_V2/STLs/Carriage_Bases/Carriage_Base_Long.stl
49.8 x 31.7 x 26.8
