chirpy2605/voron/general/Alternative_Voron_Mounts/Modified_Mounts/V1_V2/STLs/CW2_Adapter_Plate/CW2_Adapter_Plate.stl

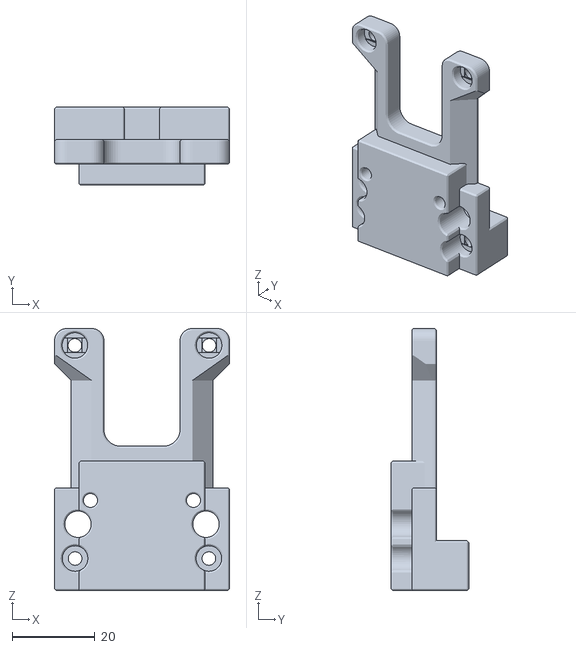
[picture p304: CAD file, 2023-11-12]
general/Alternative_Voron_Mounts/Modified_Mounts/V1_V2/STLs/CW2_Adapter_Plate/CW2_Adapter_Plate.stl
42.4 x 18.8 x 63.5
