chirpy2605/voron/general/Alternative_Voron_Mounts/Modified_Mounts/V1_V2/STLs/MGN12H/MGN12H_X_Carriage_Lite_9mm.stl

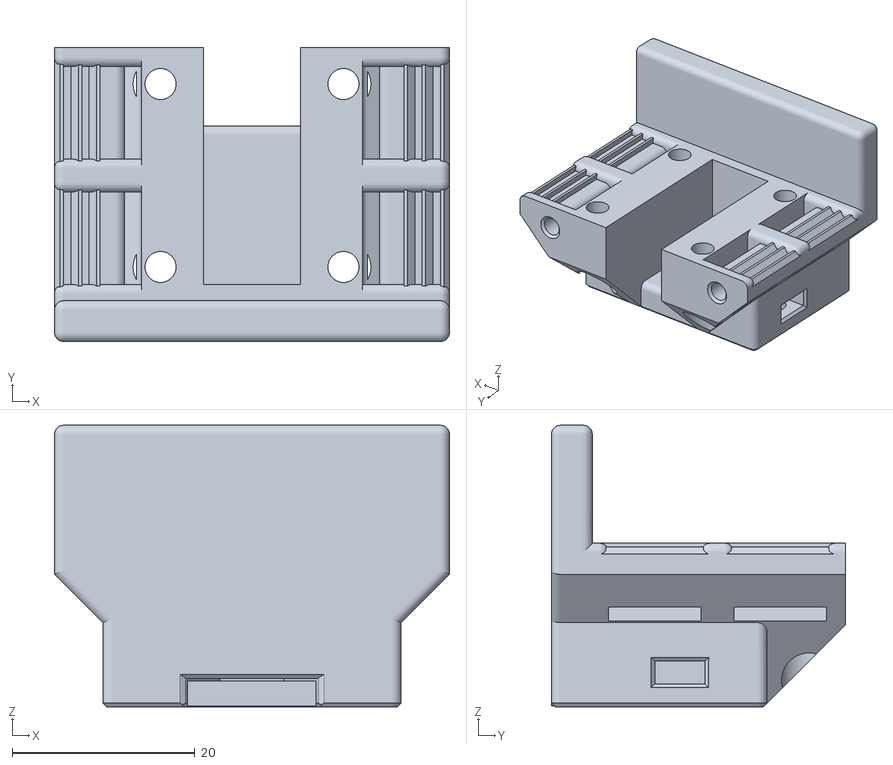
[picture p305: CAD file, 2024-01-03]
general/Alternative_Voron_Mounts/Modified_Mounts/V1_V2/STLs/MGN12H/MGN12H_X_Carriage_Lite_9mm.stl
43.2 x 32.2 x 30.8
