chirpy2605/voron/general/Alternative_Voron_Mounts/Modified_Mounts/V1_V2/STLs/MGN9H/MGN9H_X_Carriage_Spacer_short.stl

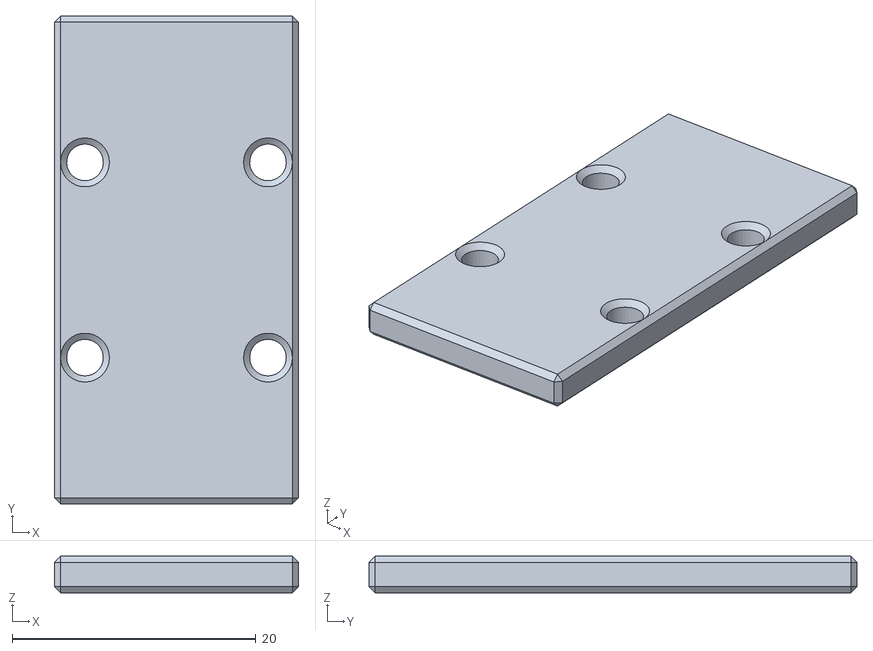
[picture p306: CAD file, 2023-11-12]
general/Alternative_Voron_Mounts/Modified_Mounts/V1_V2/STLs/MGN9H/MGN9H_X_Carriage_Spacer_short.stl
20.0 x 40.0 x 3.00
