chirpy2605/voron/general/Alternative_Voron_Mounts/Modified_Mounts/V1_V2/STLs/Probe_Mounts/Beacon_Probe_Mount.stl

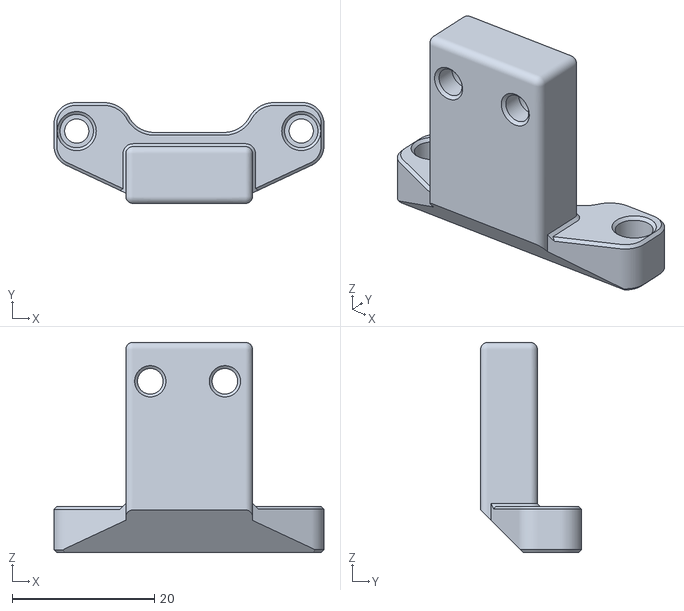
[picture p307: CAD file, 2024-08-29]
general/Alternative_Voron_Mounts/Modified_Mounts/V1_V2/STLs/Probe_Mounts/Beacon_Probe_Mount.stl
38.0 x 14.2 x 29.6
