chirpy2605/voron/general/CraneFly/STLs/Strain_Relief_PCB_DV.stl

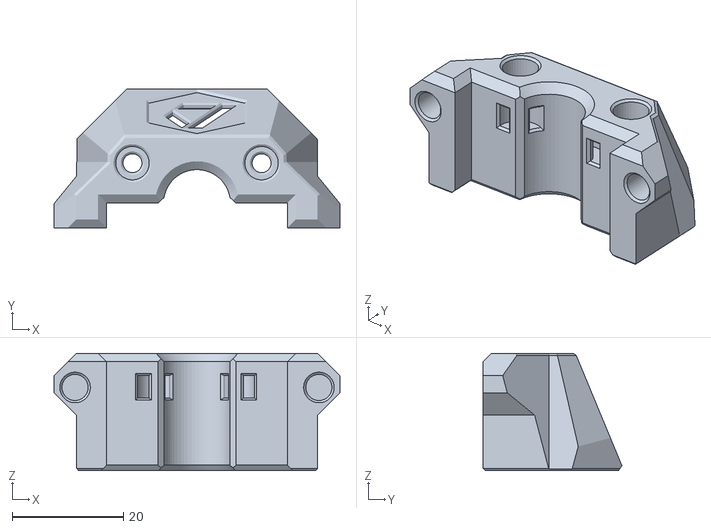
[picture p308: CAD file, 2024-07-06]
general/CraneFly/STLs/Strain_Relief_PCB_DV.stl
51.4 x 24.9 x 21.1
