chirpy2605/voron/general/DB_Ornament/CAD/DB_Ornament.step

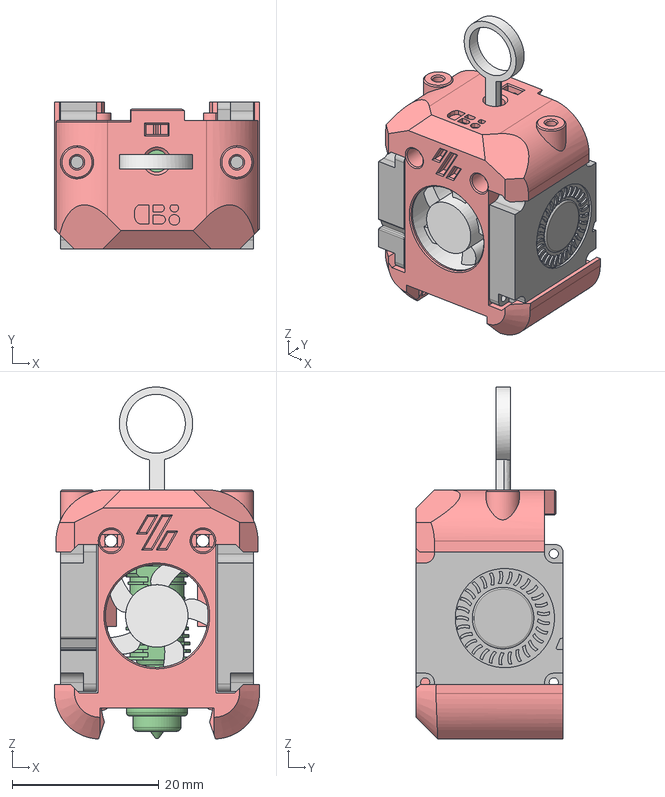
[picture p309: CAD file, 2023-12-04]
general/DB_Ornament/CAD/DB_Ornament.step
27.9 x 20.0 x 47.9 mm
3010_Fan
MainBody
4010 - Blower
4010 - Blower (1)
Hanger
Revo Voron
