chirpy2605/voron/general/DB_Ornament/STLs/3010_Fan.stl

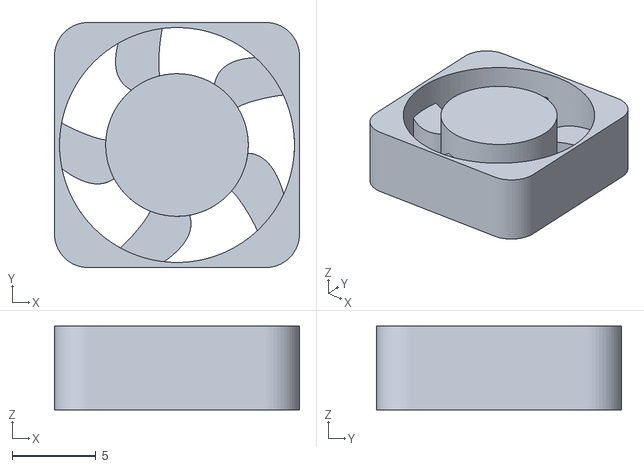
[picture p310: CAD file, 2023-12-06]
general/DB_Ornament/STLs/3010_Fan.stl
14.6 x 14.6 x 5.00
