chirpy2605/voron/general/Duct_Testing/Shuriken_55.stl

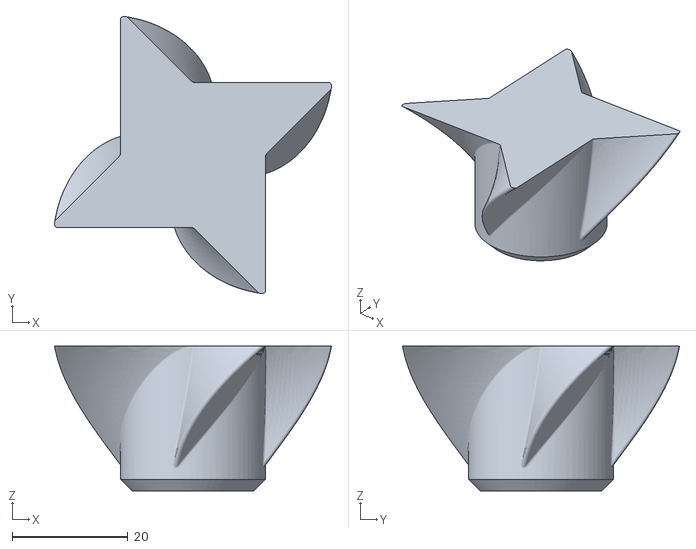
[picture p311: CAD file, 2023-12-07]
general/Duct_Testing/Shuriken_55.stl
47.8 x 47.8 x 25.0
