chirpy2605/voron/general/Experimental/Boop/Boop_Spacer.stl

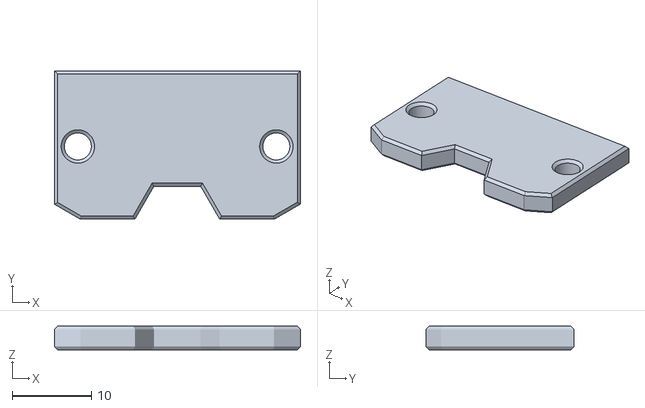
[picture p312: CAD file, 2023-05-25]
general/Experimental/Boop/Boop_Spacer.stl
31.0 x 18.7 x 3.00
