chirpy2605/voron/general/Experimental/Peck/STLs/Orbiterv2_Mount_Pattern/RapidoHF_Mount.stl

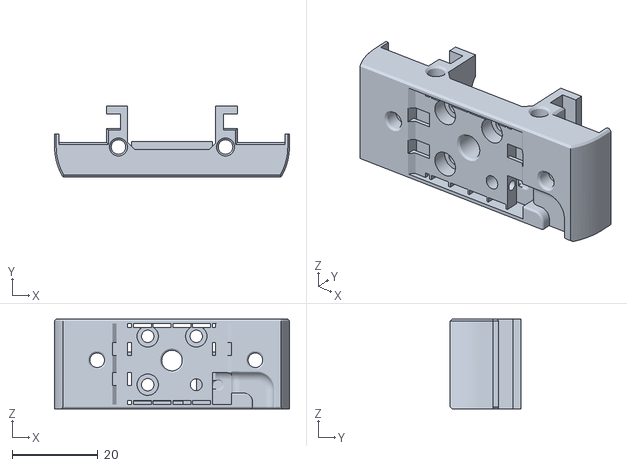
[picture p313: CAD file, 2024-05-04]
general/Experimental/Peck/STLs/Orbiterv2_Mount_Pattern/RapidoHF_Mount.stl
55.0 x 16.5 x 21.0
