chirpy2605/voron/general/Large_Voron_Mounts/Dragon_Burner/Tap_or_Chain/DFA_Mount.stl

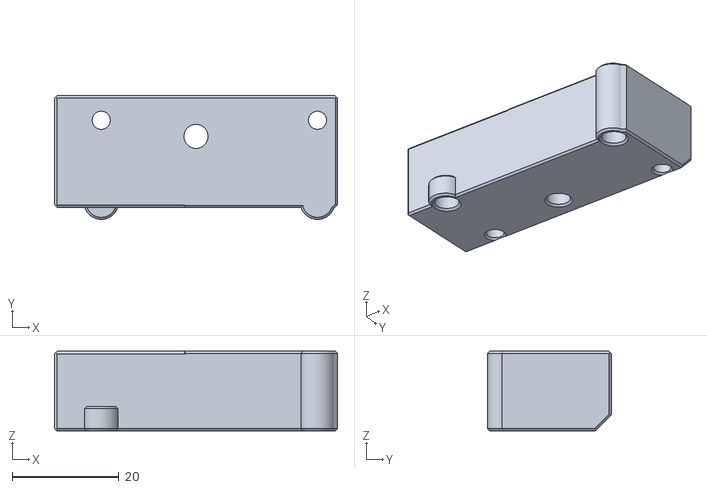
[picture p315: CAD file, 2023-06-04]
general/Large_Voron_Mounts/Dragon_Burner/Tap_or_Chain/DFA_Mount.stl
53.0 x 23.2 x 14.9
