chirpy2605/voron/general/MiniMouse/STLs/MiniMouse_Guidler.stl

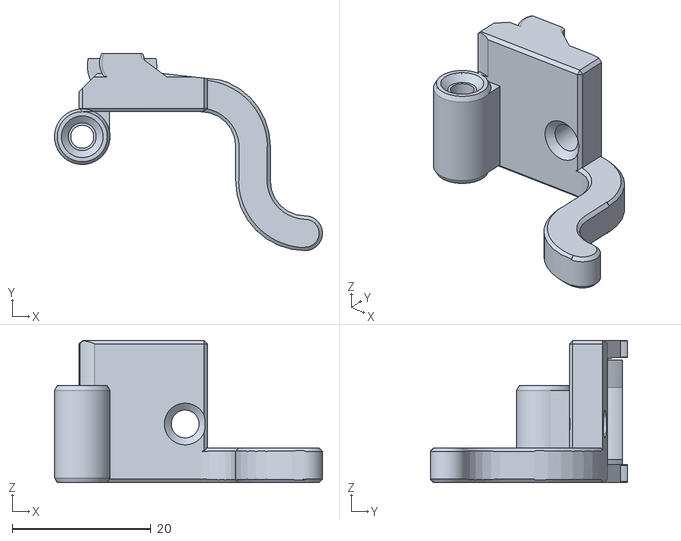
[picture p316: CAD file, 2022-11-04]
general/MiniMouse/STLs/MiniMouse_Guidler.stl
38.6 x 28.4 x 20.5
