chirpy2605/voron/general/PCB_Mounts/STLs/G2SA/G2SA_Long_x2.stl

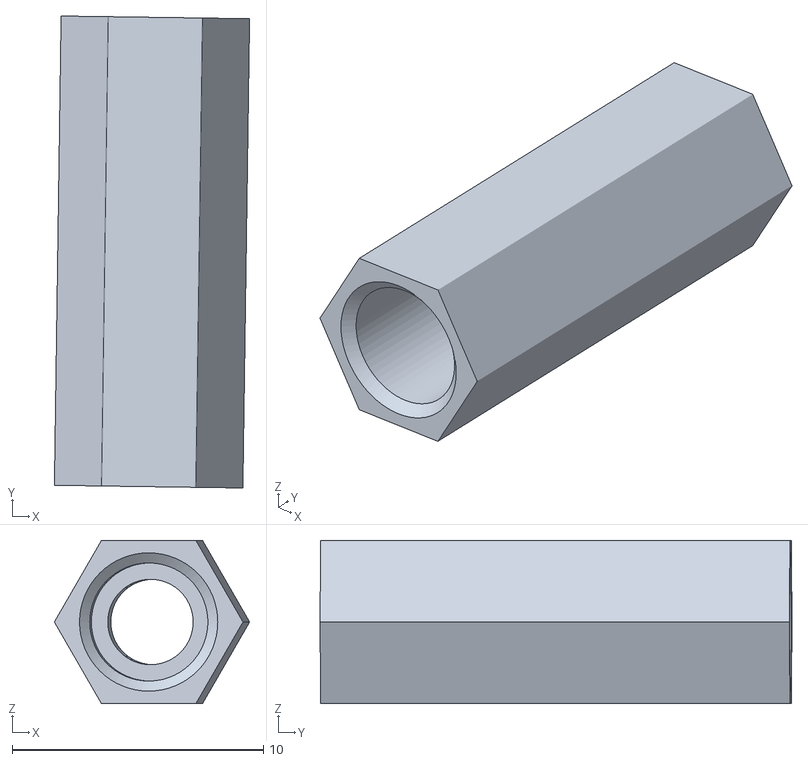
[picture p317: CAD file, 2023-11-02]
general/PCB_Mounts/STLs/G2SA/G2SA_Long_x2.stl
7.77 x 18.8 x 6.50
