chirpy2605/voron/general/PCB_Mounts/STLs/Hextrudort/Hextrudort_Long_x2.stl

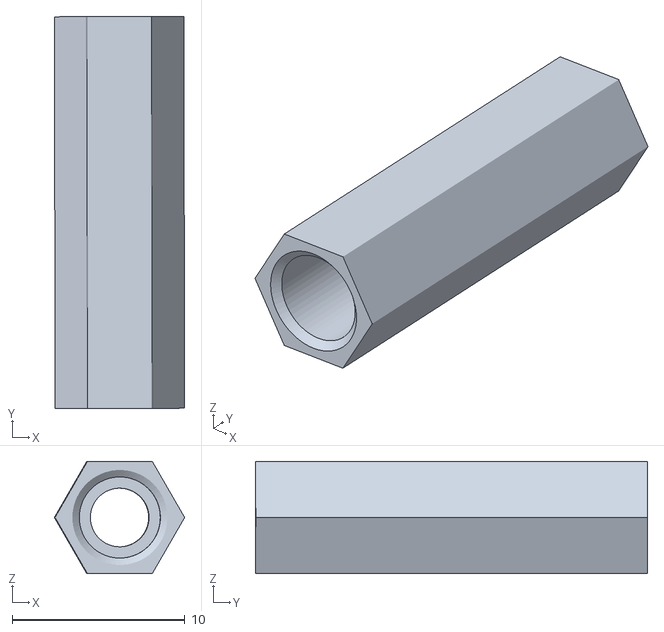
[picture p318: CAD file, 2023-11-26]
general/PCB_Mounts/STLs/Hextrudort/Hextrudort_Long_x2.stl
7.55 x 22.7 x 6.50
