chirpy2605/voron/general/PCB_Mounts/STLs/LGX_Lite/LGX_Lite_Long_x2.stl

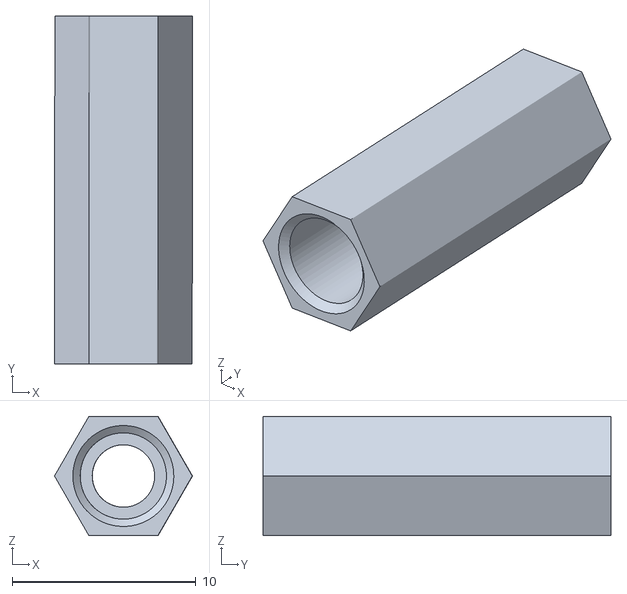
[picture p319: CAD file, 2023-08-01]
general/PCB_Mounts/STLs/LGX_Lite/LGX_Lite_Long_x2.stl
7.52 x 19.0 x 6.50
