chirpy2605/voron/general/PCB_Mounts/STLs/Orbiter_v2_Carrier_RB_36.stl

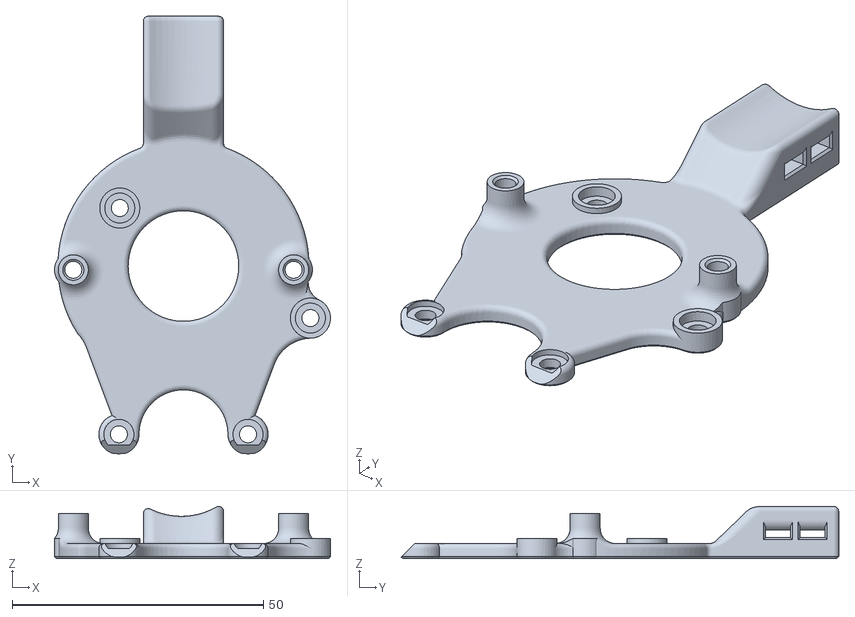
[picture p320: CAD file, 2023-12-04]
general/PCB_Mounts/STLs/Orbiter_v2_Carrier_RB_36.stl
54.9 x 87.1 x 10.4
