chirpy2605/voron/general/PCB_Mounts/STLs/RoundTrip_LGX/Roundtrip_LGX_Long_x2.stl

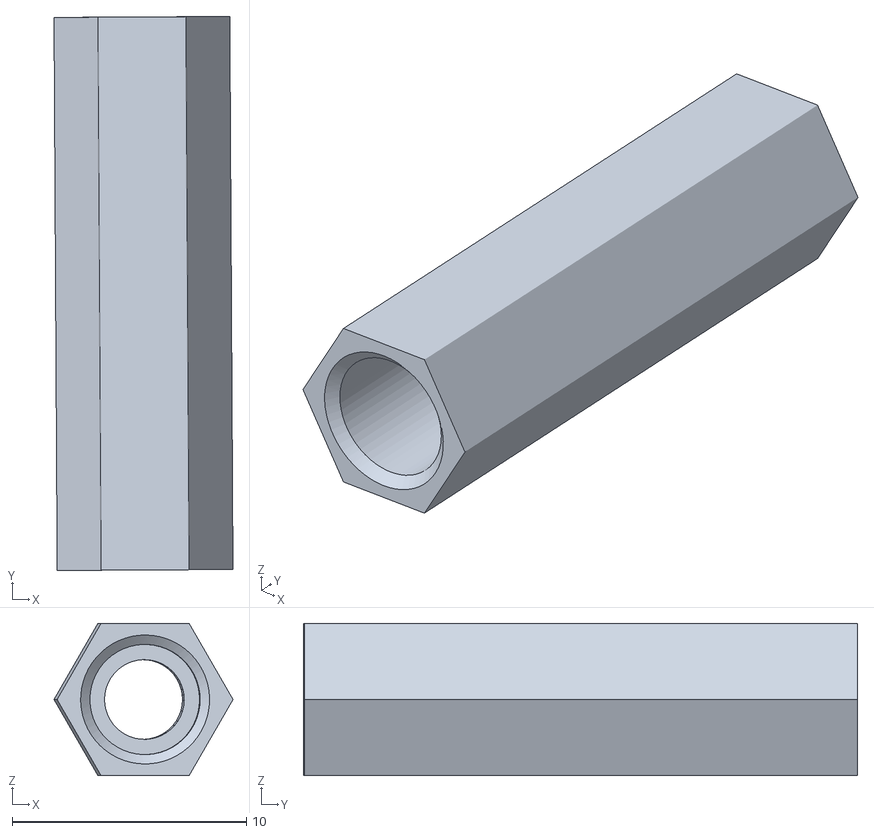
[picture p321: CAD file, 2023-08-01]
general/PCB_Mounts/STLs/RoundTrip_LGX/Roundtrip_LGX_Long_x2.stl
7.64 x 23.6 x 6.50
