chirpy2605/voron/general/PCB_Mounts/STLs/RoundTrip_OB1/RoundTrip_OB1_Long_x2.stl

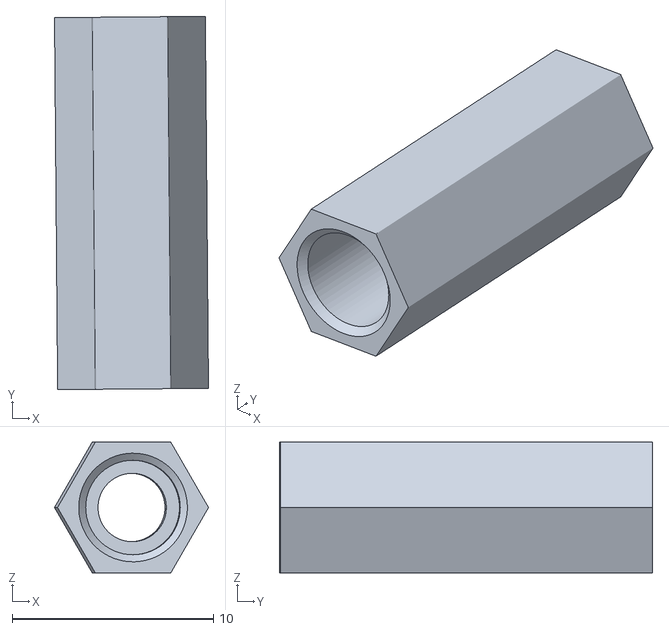
[picture p322: CAD file, 2023-08-01]
general/PCB_Mounts/STLs/RoundTrip_OB1/RoundTrip_OB1_Long_x2.stl
7.65 x 18.6 x 6.50
