chirpy2605/voron/general/PCB_Mounts/STLs/RoundTrip_OB1Reverse/RoundTrip_OB1Reverse_Short_x2.stl

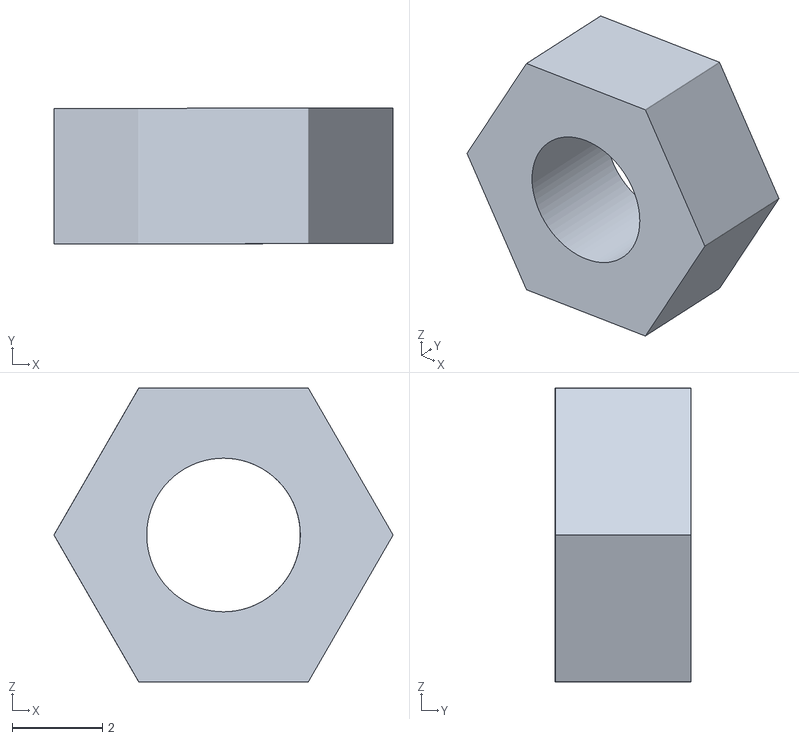
[picture p323: CAD file, 2023-08-01]
general/PCB_Mounts/STLs/RoundTrip_OB1Reverse/RoundTrip_OB1Reverse_Short_x2.stl
7.50 x 3.01 x 6.50
