chirpy2605/voron/general/PCB_Mounts/STLs/RoundTrip_OB2/RoundTrip_OB2_Long_x2.stl

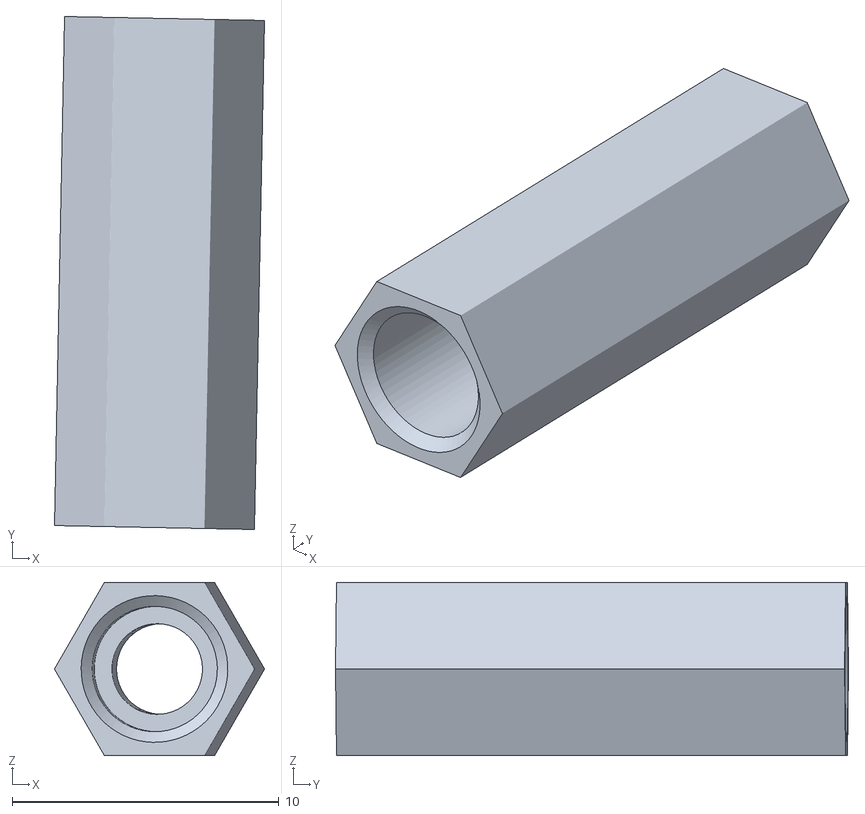
[picture p324: CAD file, 2023-08-01]
general/PCB_Mounts/STLs/RoundTrip_OB2/RoundTrip_OB2_Long_x2.stl
7.88 x 19.2 x 6.50
