chirpy2605/voron/general/PCB_Mounts/STLs/RoundTrip_OB2Reverse/RoundTrip_OB2Reverse_Long_x2.stl

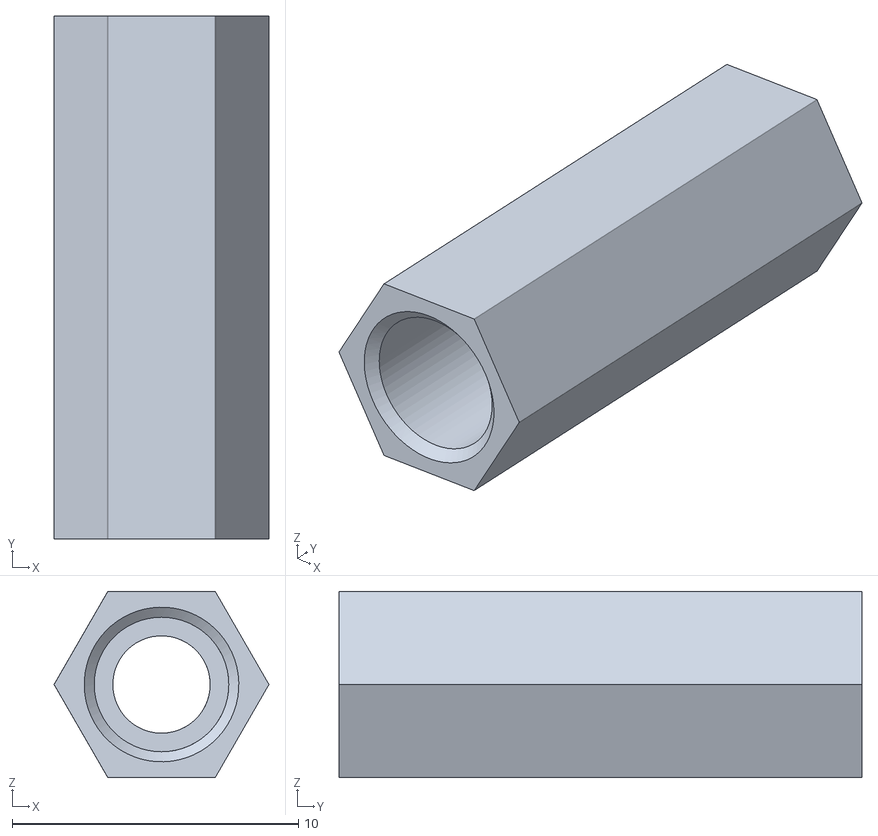
[picture p325: CAD file, 2023-08-01]
general/PCB_Mounts/STLs/RoundTrip_OB2Reverse/RoundTrip_OB2Reverse_Long_x2.stl
7.50 x 18.3 x 6.50
