chirpy2605/voron/general/PCB_Mounts/STLs/RoundTrip_TBG/RoundTrip_TBG_Long_x2.stl

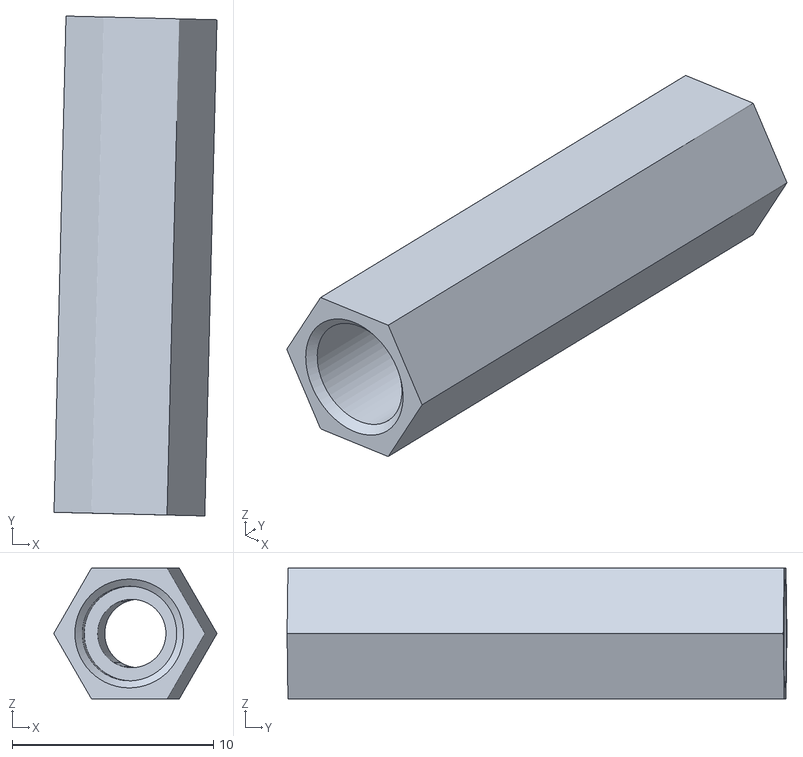
[picture p326: CAD file, 2023-08-01]
general/PCB_Mounts/STLs/RoundTrip_TBG/RoundTrip_TBG_Long_x2.stl
8.09 x 24.8 x 6.50
