chirpy2605/voron/general/PCB_Mounts/STLs/Sharkfin/Sharkfin_Long_x2.stl

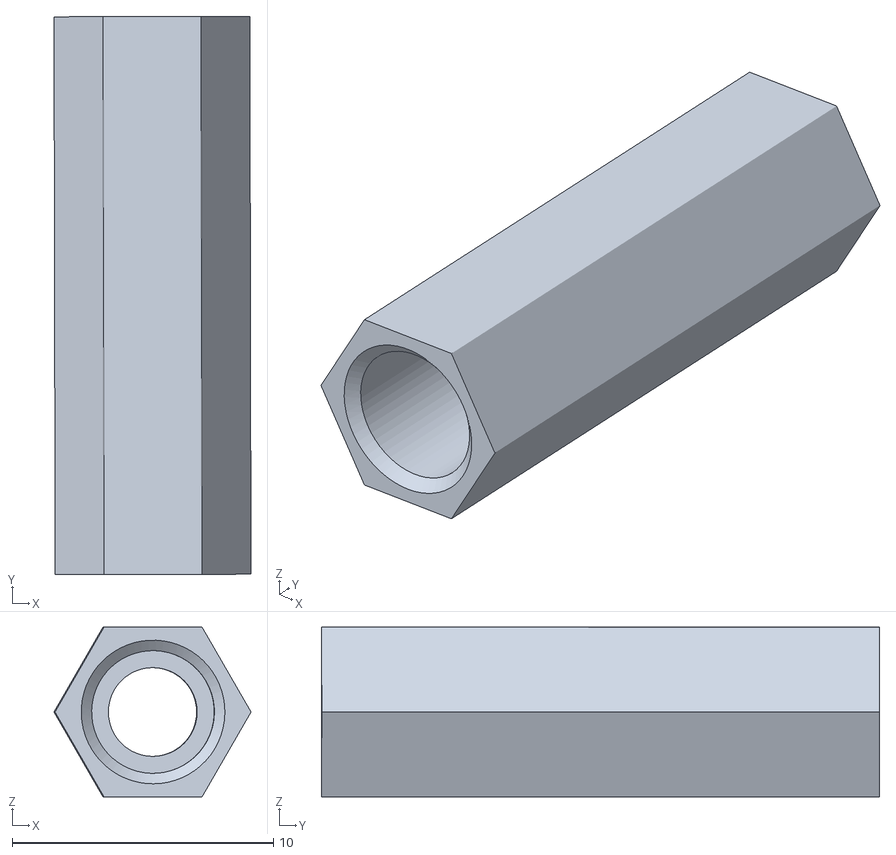
[picture p327: CAD file, 2023-11-26]
general/PCB_Mounts/STLs/Sharkfin/Sharkfin_Long_x2.stl
7.54 x 21.4 x 6.50
