chirpy2605/voron/general/PCB_Mounts/STLs/Sherpa_Micro/Sherpa_Micro_Long_x2.stl

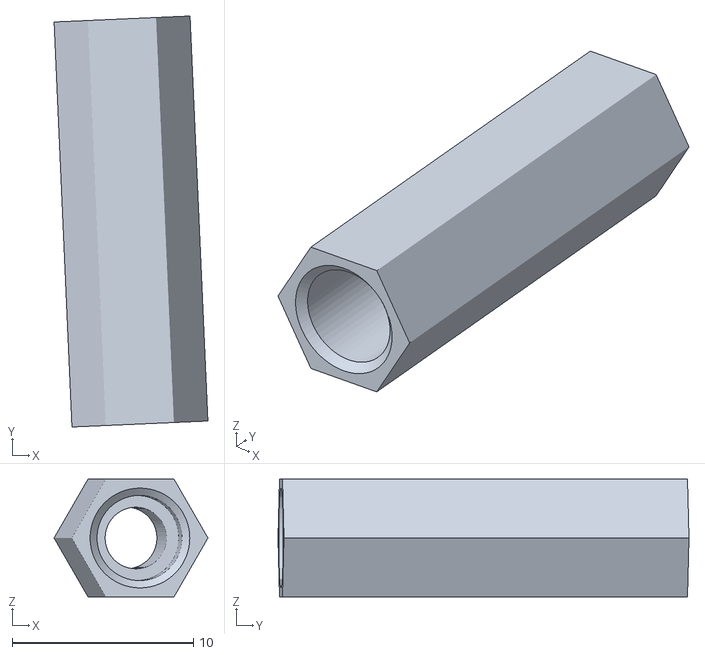
[picture p328: CAD file, 2023-08-01]
general/PCB_Mounts/STLs/Sherpa_Micro/Sherpa_Micro_Long_x2.stl
8.48 x 22.6 x 6.50
