chirpy2605/voron/general/PCB_Mounts/STLs/Sherpa_Mini/Sherpa_Mini_Long_x2.stl

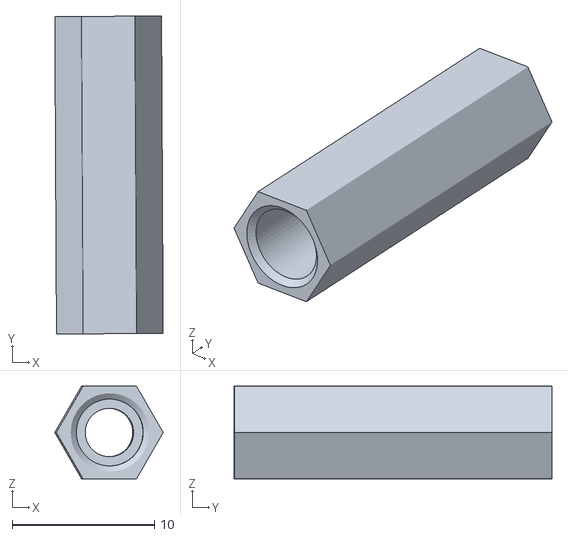
[picture p329: CAD file, 2023-08-01]
general/PCB_Mounts/STLs/Sherpa_Mini/Sherpa_Mini_Long_x2.stl
7.62 x 22.3 x 6.50
