chirpy2605/voron/general/PCB_Mounts/STLs/WristWatch_G2/WristWatch_G2_Short_x2.stl

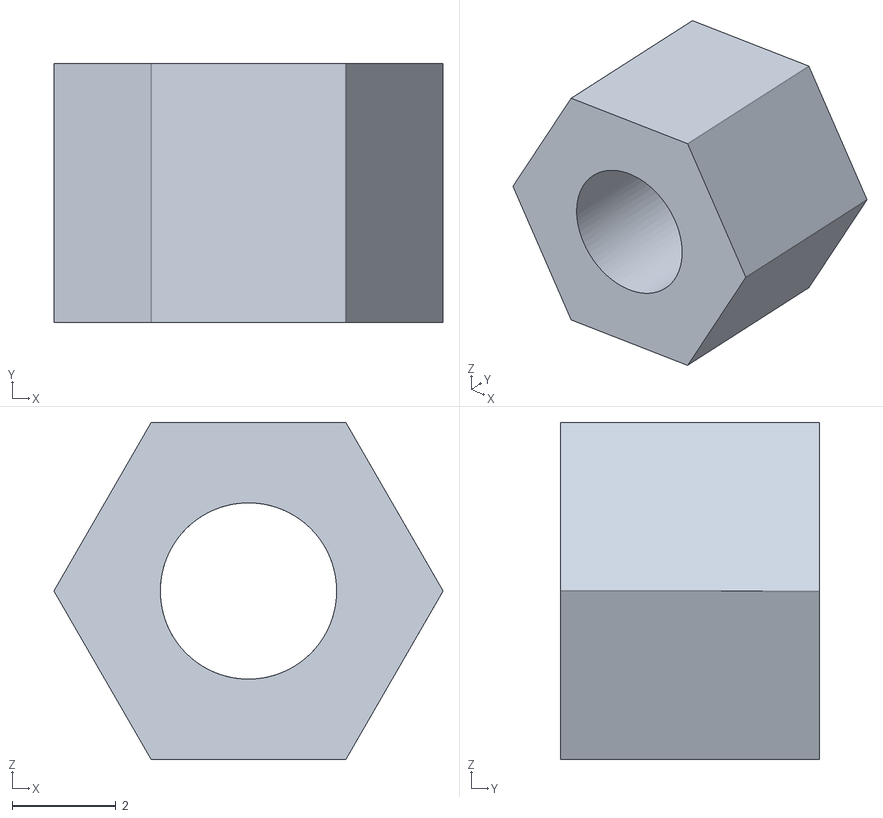
[picture p330: CAD file, 2023-11-02]
general/PCB_Mounts/STLs/WristWatch_G2/WristWatch_G2_Short_x2.stl
7.50 x 5.00 x 6.50
