chirpy2605/voron/general/RoundAbout/STLs/Latch.stl

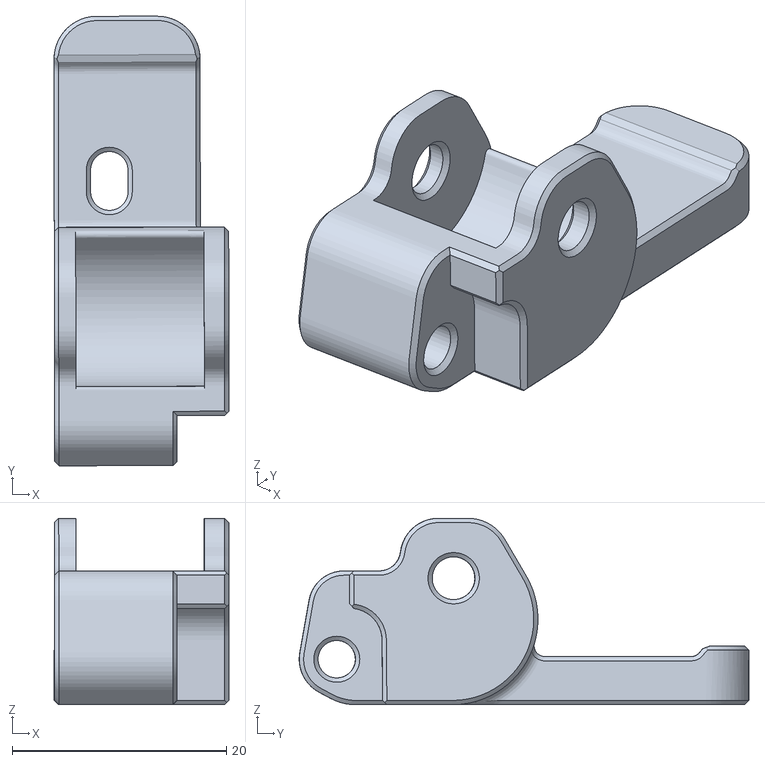
[picture p331: CAD file, 2022-11-04]
general/RoundAbout/STLs/Latch.stl
16.4 x 42.0 x 17.4
