chirpy2605/voron/general/RoundTrip/LGX/CAD/Roundtrip_LGX_v2.step

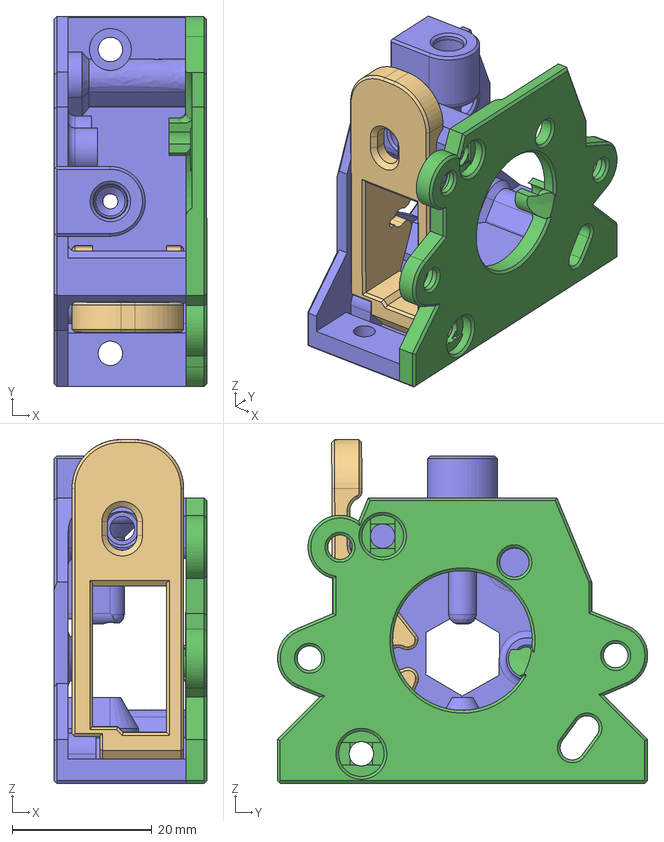
[picture p332: CAD file, 2023-09-26]
general/RoundTrip/LGX/CAD/Roundtrip_LGX_v2.step
21.9 x 53.0 x 49.2 mm
Guidler
Front (1)
Back (1)
