chirpy2605/voron/general/RoundTrip/LGX/STLs/Back.stl

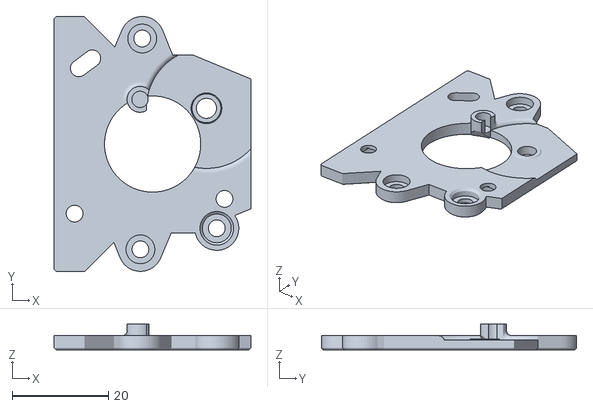
[picture p333: CAD file, 2023-07-26]
general/RoundTrip/LGX/STLs/Back.stl
40.9 x 53.0 x 5.40
