chirpy2605/voron/general/RoundTrip/ORB1/STLs/FrontFeed/Back.stl

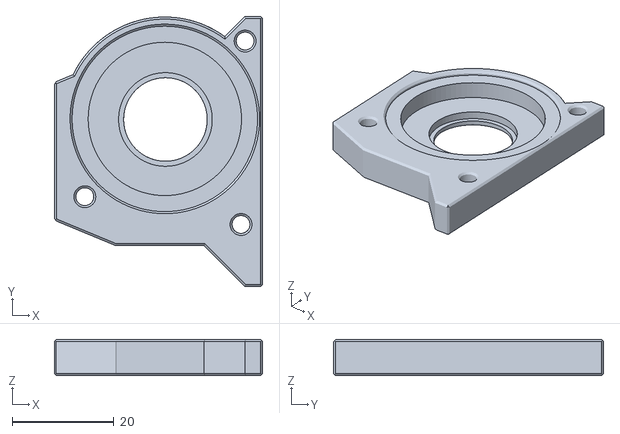
[picture p335: CAD file, 2023-03-28]
general/RoundTrip/ORB1/STLs/FrontFeed/Back.stl
40.9 x 53.0 x 7.13
