chirpy2605/voron/general/RoundTrip/ORB1/STLs/PCB_Mount.stl

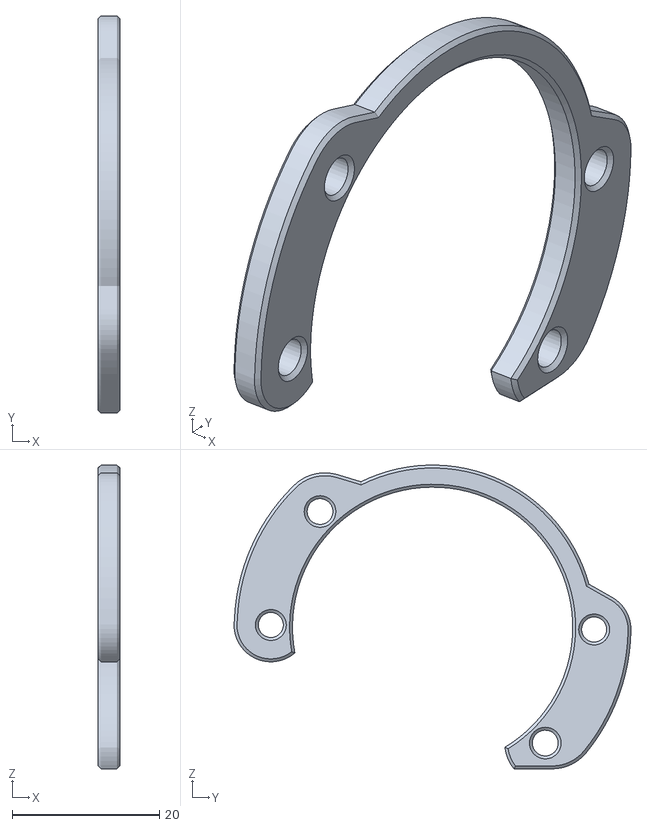
[picture p336: CAD file, 2023-03-28]
general/RoundTrip/ORB1/STLs/PCB_Mount.stl
3.00 x 53.8 x 41.2
