chirpy2605/voron/general/RoundTrip/ORB1/STLs/RearFeed/Back.stl

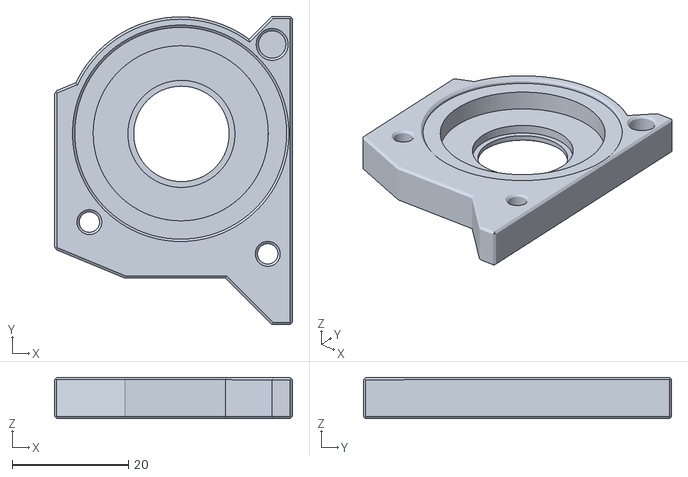
[picture p337: CAD file, 2023-03-28]
general/RoundTrip/ORB1/STLs/RearFeed/Back.stl
40.9 x 53.0 x 7.13
