chirpy2605/voron/general/RoundTrip/ORB2/CAD/Roundtrip_ORB2_FF_v1.step

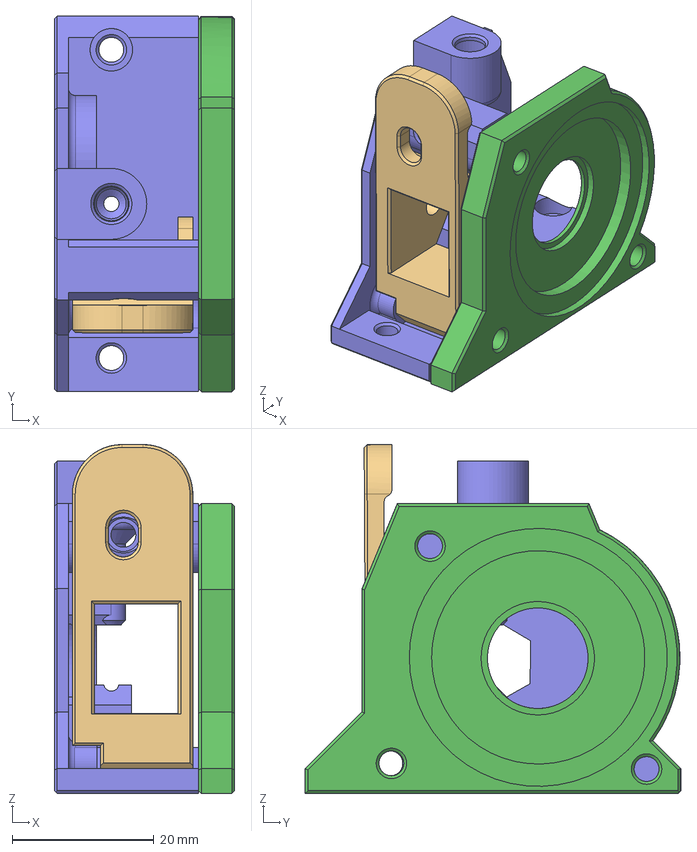
[picture p338: CAD file, 2023-03-28]
general/RoundTrip/ORB2/CAD/Roundtrip_ORB2_FF_v1.step
25.5 x 53.0 x 49.3 mm
Guidler
Front
Back
