chirpy2605/voron/general/RoundTrip/ORB2/STLs/FrontFeed/Back.stl

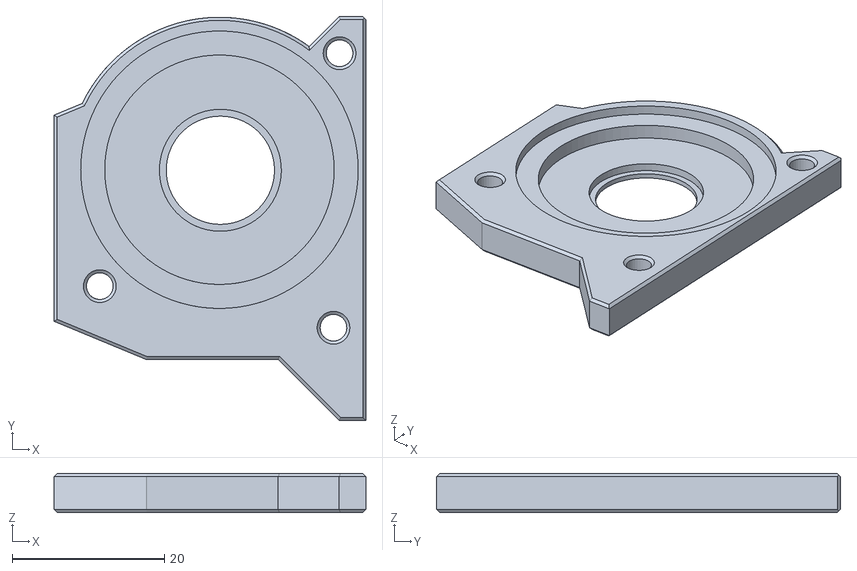
[picture p339: CAD file, 2023-03-28]
general/RoundTrip/ORB2/STLs/FrontFeed/Back.stl
40.9 x 53.0 x 5.13
