chirpy2605/voron/general/RoundTrip/ORB2/STLs/RearFeed/Front.stl

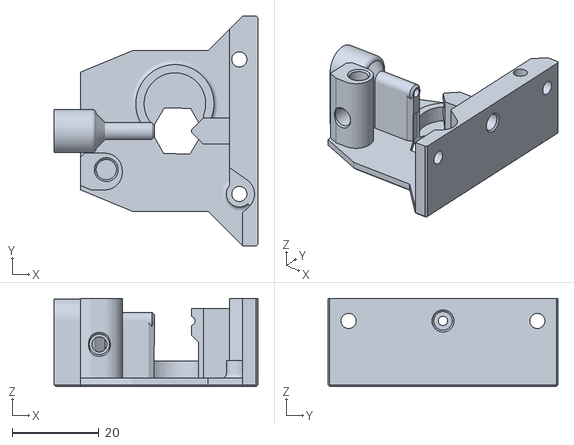
[picture p340: CAD file, 2023-03-28]
general/RoundTrip/ORB2/STLs/RearFeed/Front.stl
46.9 x 53.0 x 20.4
