chirpy2605/voron/general/RoundTrip/TBG/CAD/Roundtrip_TBG_v1.step

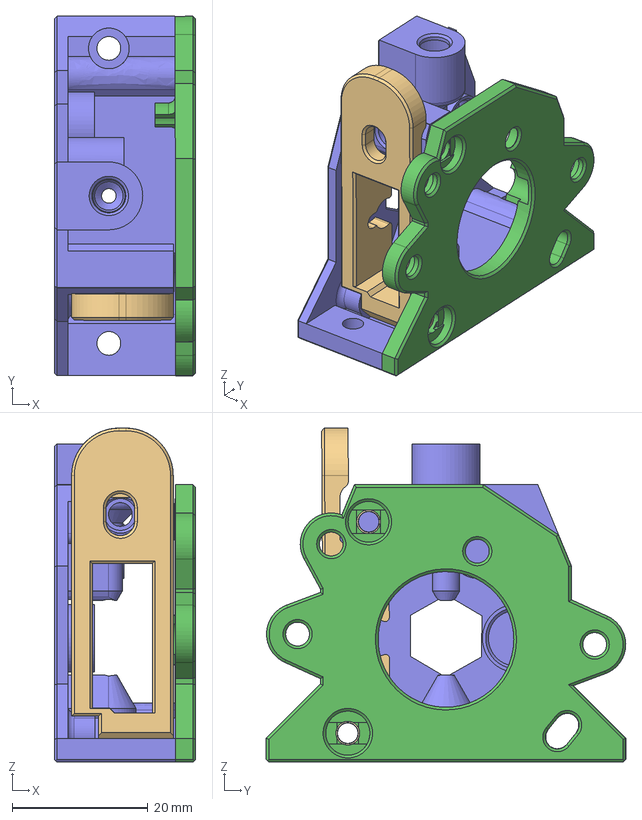
[picture p341: CAD file, 2023-03-13]
general/RoundTrip/TBG/CAD/Roundtrip_TBG_v1.step
20.9 x 53.0 x 49.3 mm
Guidler
M3 Threaded Insert x 2
Front
Back
