chirpy2605/voron/general/RunoutUnklicky/CAD/RunoutUnKlicky.step

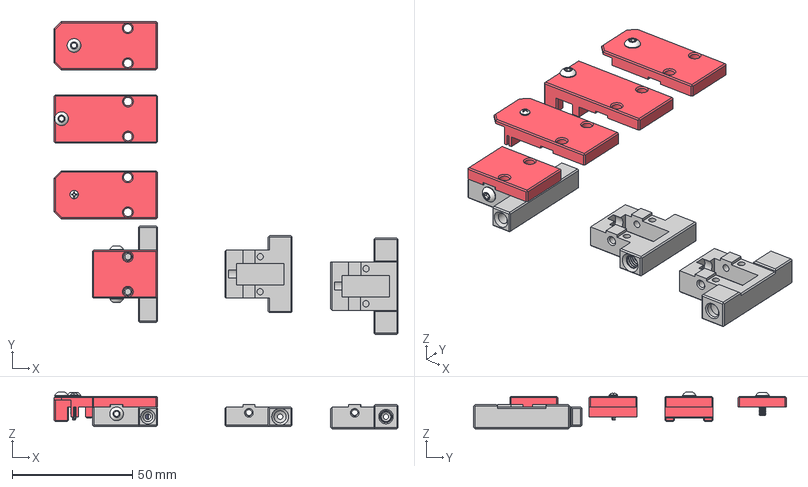
[picture p342: CAD file, 2022-11-04]
general/RunoutUnklicky/CAD/RunoutUnKlicky.step
143.1 x 130.0 x 15.2 mm
Pin
Top
94500A222_316 Stainless Steel Button Head Hex Drive Screws (2)
94500A222_316 Stainless Steel Button Head Hex Drive Screws (3)
Magnet (1)
Magnet (2)
Top_1515_NoNut
Top_2020 (1)
90380A328_Phillips Rounded Head Thread-Forming Screws (1)
94500A222_316 Stainless Steel Button Head Hex Drive Screws (1) (2)
94500A222_316 Stainless Steel Button Head Hex Drive Screws (1) (3)
Top_1515
Roller (1)
Base_PC4-M6
Base
Base_Collet
