chirpy2605/voron/general/RunoutUnklicky/STLs/Base_PC4-M6.stl

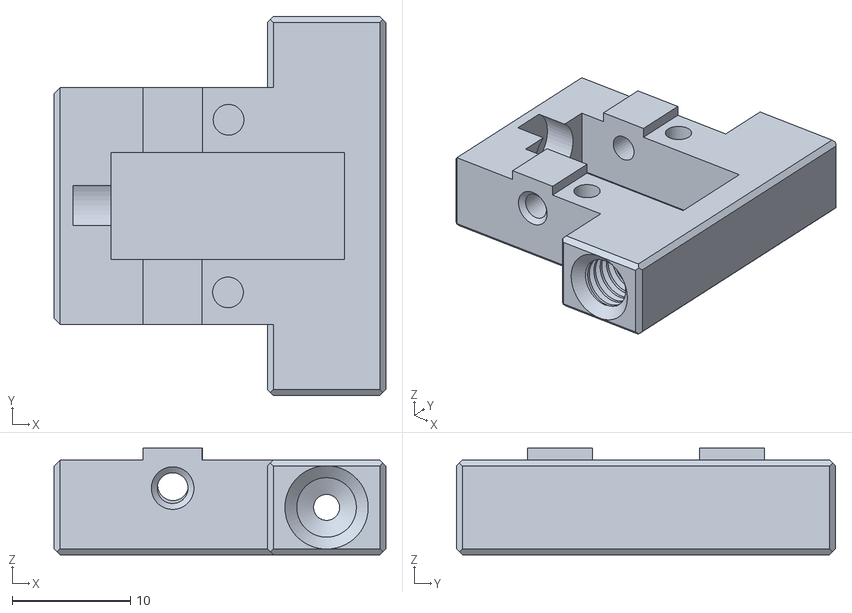
[picture p343: CAD file, 2022-11-04]
general/RunoutUnklicky/STLs/Base_PC4-M6.stl
28.0 x 32.0 x 9.00
