chirpy2605/voron/V0/5015_Toolhead/STLs/ADXL_Mount.stl

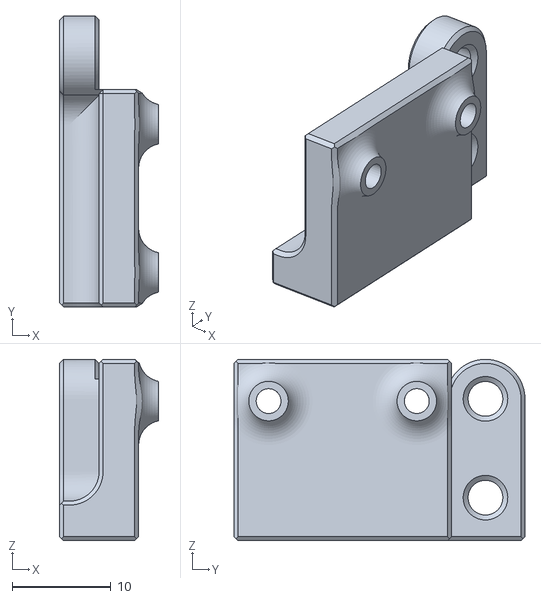
[picture p344: CAD file, 2022-11-24]
V0/5015_Toolhead/STLs/ADXL_Mount.stl
10.0 x 29.4 x 18.4
