chirpy2605/voron/V0/5015_Toolhead/STLs/Extras/Cowl_RapidoUHF_Klicky.stl

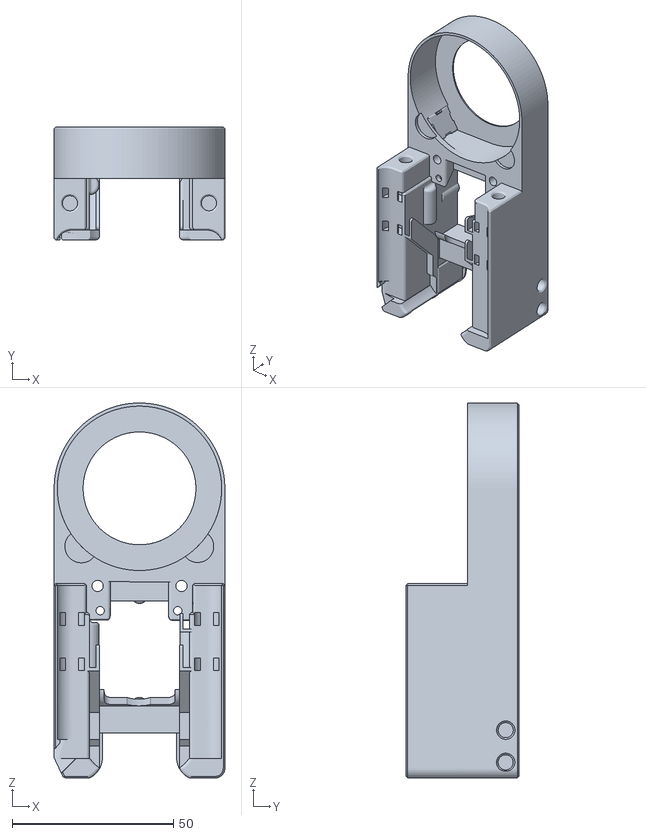
[picture p345: CAD file, 2022-11-04]
V0/5015_Toolhead/STLs/Extras/Cowl_RapidoUHF_Klicky.stl
53.0 x 35.0 x 116.4
