chirpy2605/voron/V0/Daylight_on_a_Matchstick/CAD/Matchstick Diffuser.step

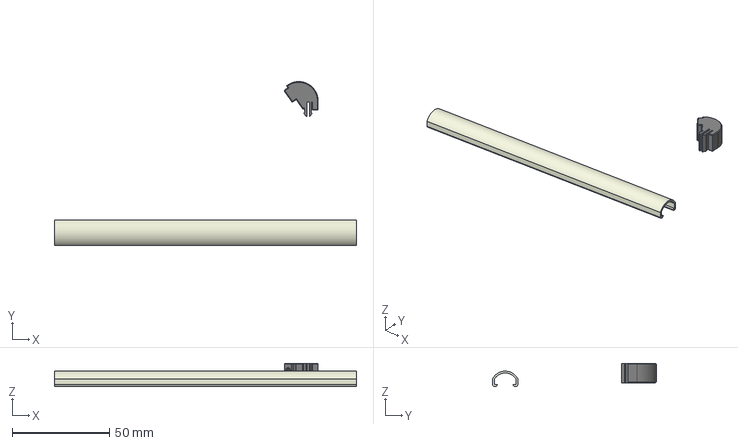
[picture p346: CAD file, 2022-11-04]
V0/Daylight_on_a_Matchstick/CAD/Matchstick Diffuser.step
155.0 x 84.1 x 12.0 mm
