chirpy2605/voron/V0/Daylight_on_a_Matchstick/STLs/Mount_90_x4.stl

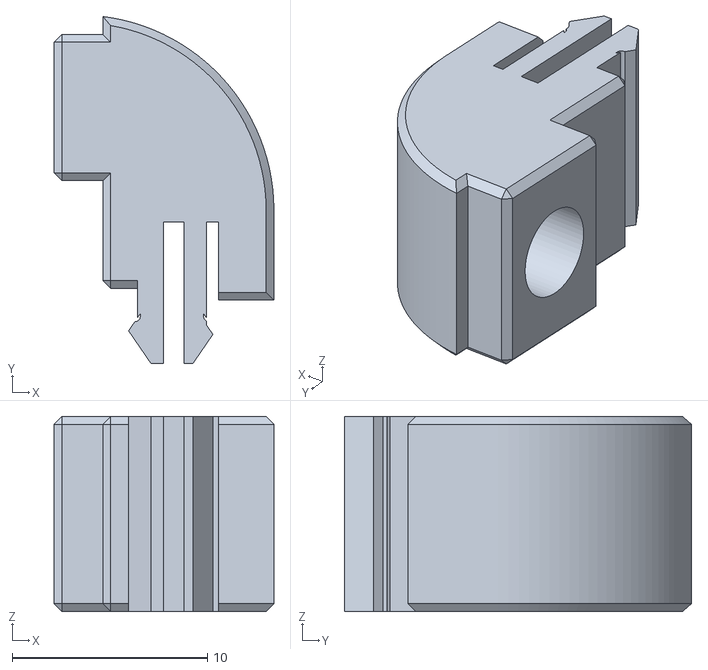
[picture p347: CAD file, 2023-06-30]
V0/Daylight_on_a_Matchstick/STLs/Mount_90_x4.stl
11.3 x 17.8 x 10.0
