chirpy2605/voron/V0/Dragon_Burner/STLs/v0.2/Cowls/Micron/[c]_Micron_Diffuser.stl

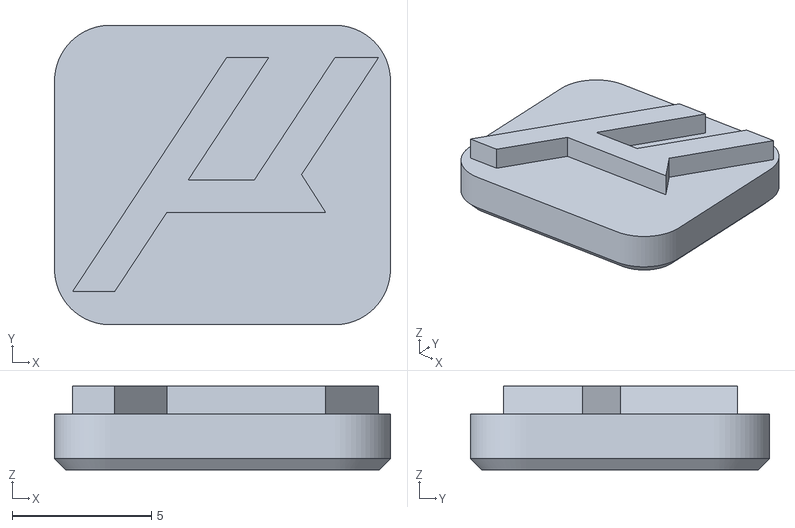
[picture p348: CAD file, 2023-10-29]
V0/Dragon_Burner/STLs/v0.2/Cowls/Micron/[c]_Micron_Diffuser.stl
12.1 x 10.7 x 3.00
