chirpy2605/voron/V0/Dragon_Burner/STLs/v0.2/Cowls/Micron/Cat_Cowls/CatCowl_NoProbe.stl

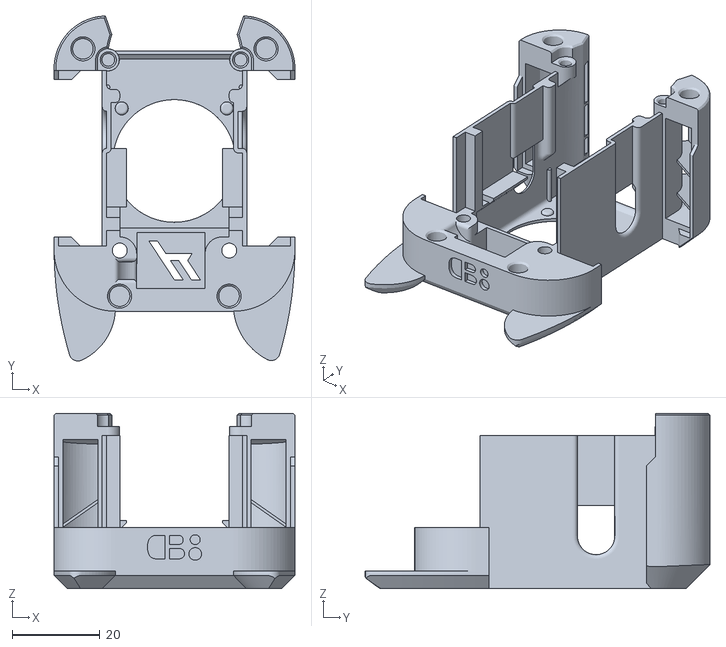
[picture p349: CAD file, 2024-01-09]
V0/Dragon_Burner/STLs/v0.2/Cowls/Micron/Cat_Cowls/CatCowl_NoProbe.stl
55.0 x 78.8 x 40.0
