chirpy2605/voron/V0/Dragon_Burner/STLs/v0.2/Cowls/PFA/[c]_PFA_Diffuser.stl

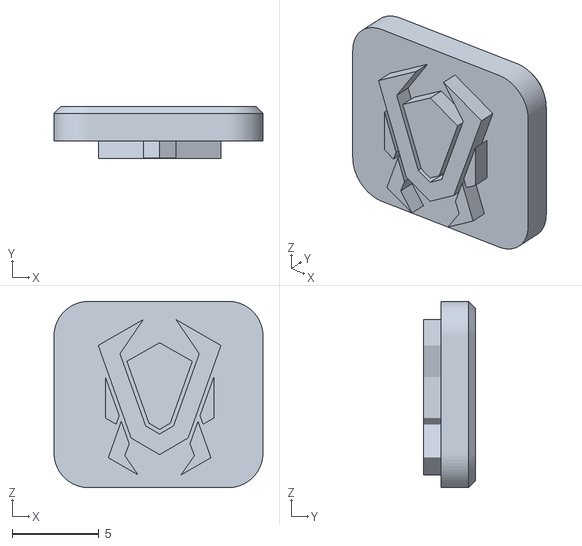
[picture p350: CAD file, 2024-01-09]
V0/Dragon_Burner/STLs/v0.2/Cowls/PFA/[c]_PFA_Diffuser.stl
12.1 x 3.00 x 10.7
