chirpy2605/voron/V0/Dragon_Burner/STLs/v0.2/Cowls/SaladFork/Cowl_NoProbe.stl

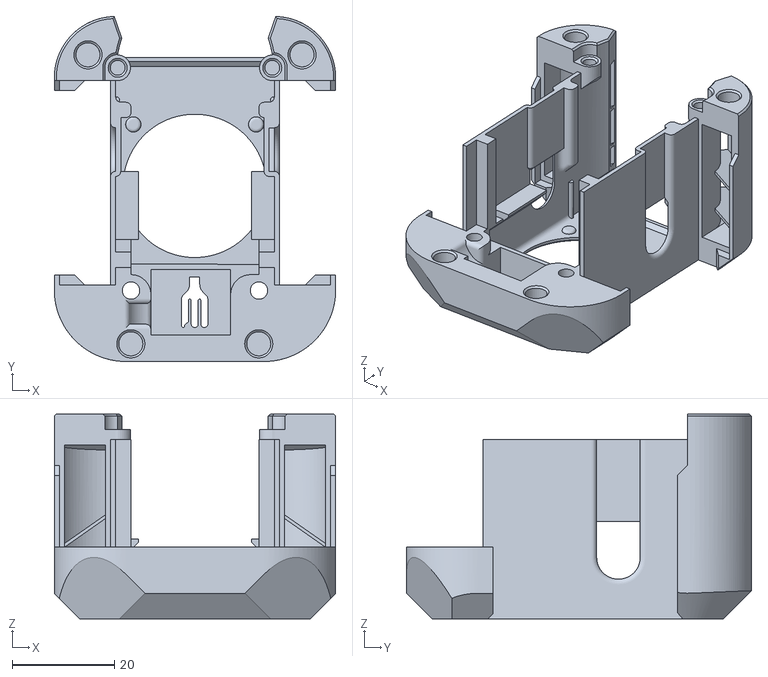
[picture p351: CAD file, 2024-01-09]
V0/Dragon_Burner/STLs/v0.2/Cowls/SaladFork/Cowl_NoProbe.stl
55.0 x 67.4 x 40.0
