chirpy2605/voron/V0/Dragon_Burner/STLs/v0.2/Cowls/Voron/Cat_Cowls/Cowl_ZeroClick.stl

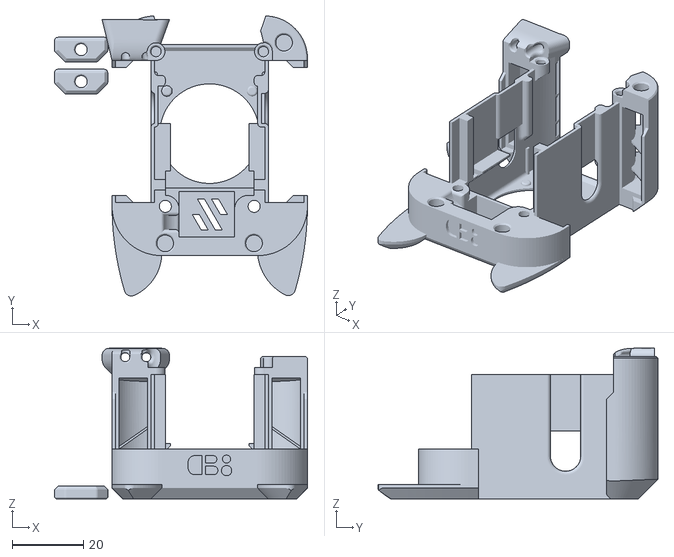
[picture p352: CAD file, 2023-11-01]
V0/Dragon_Burner/STLs/v0.2/Cowls/Voron/Cat_Cowls/Cowl_ZeroClick.stl
71.2 x 78.8 x 42.4
