chirpy2605/voron/V0/Dragon_Burner/STLs/v0.2/Cowls/Voron/Cowl_Klicky.stl

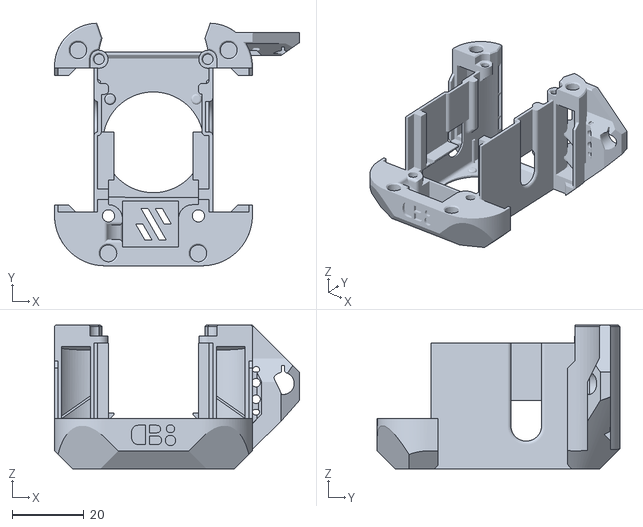
[picture p353: CAD file, 2023-10-29]
V0/Dragon_Burner/STLs/v0.2/Cowls/Voron/Cowl_Klicky.stl
68.1 x 67.4 x 40.0
