chirpy2605/voron/V0/Dragon_Burner/STLs/v0.2/Cowls/Voron/Unicorn_Cowls/Cowl_NoProbe.stl

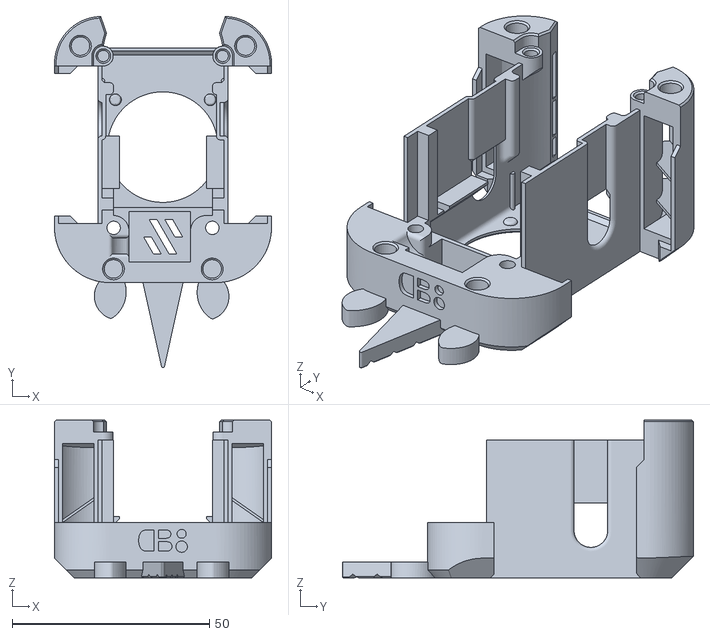
[picture p354: CAD file, 2025-11-30]
V0/Dragon_Burner/STLs/v0.2/Cowls/Voron/Unicorn_Cowls/Cowl_NoProbe.stl
55.0 x 88.9 x 40.0
