chirpy2605/voron/V0/Dragon_Burner/STLs/v0.2/Double_Folded_Ascender/Extruder_Mounts/DFA_Mount.stl

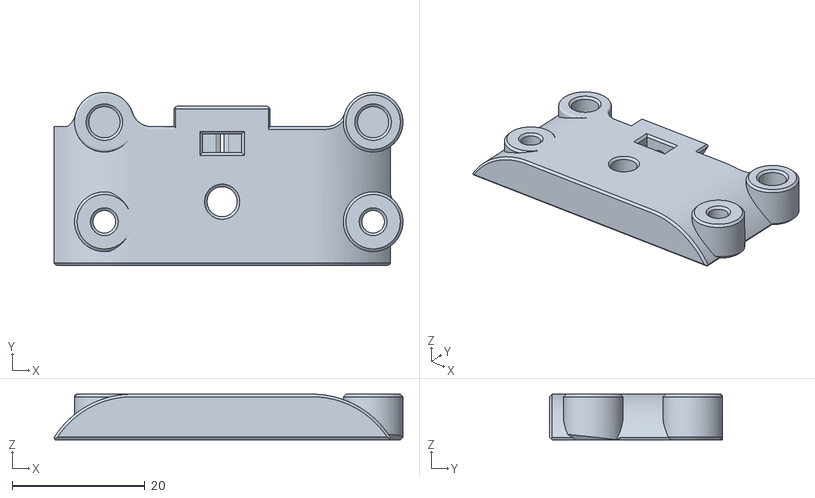
[picture p355: CAD file, 2023-10-14]
V0/Dragon_Burner/STLs/v0.2/Double_Folded_Ascender/Extruder_Mounts/DFA_Mount.stl
52.6 x 26.1 x 6.90
