chirpy2605/voron/V0/Dragon_Burner/STLs/v0.2/Orbiter_v1.5/Extruder_Mounts/Orbiter1.5_Mount.stl

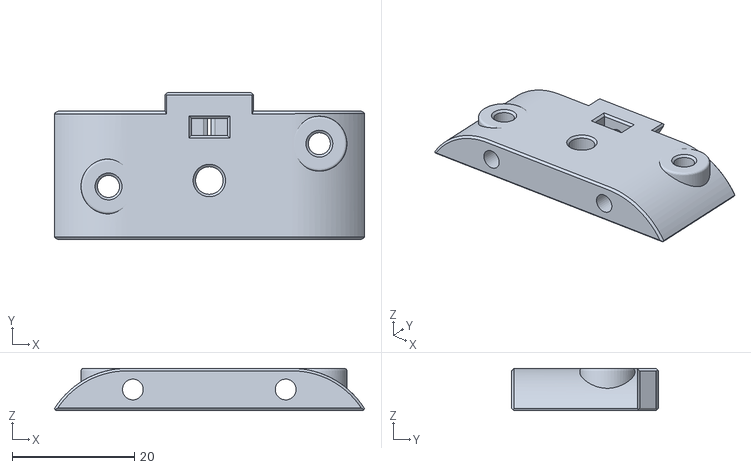
[picture p357: CAD file, 2023-10-14]
V0/Dragon_Burner/STLs/v0.2/Orbiter_v1.5/Extruder_Mounts/Orbiter1.5_Mount.stl
50.7 x 24.0 x 6.90
