chirpy2605/voron/V0/Dragon_Burner/STLs/v0.2/Orbiter_v2_pattern_mounts/Extruder_Mounts/G2SA_Orbiter_Mount.stl

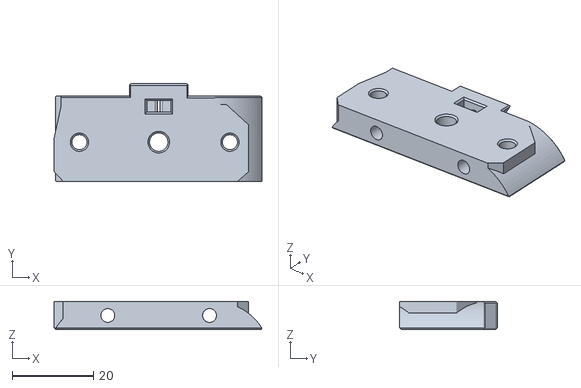
[picture p359: CAD file, 2023-11-08]
V0/Dragon_Burner/STLs/v0.2/Orbiter_v2_pattern_mounts/Extruder_Mounts/G2SA_Orbiter_Mount.stl
51.1 x 24.0 x 6.90
