chirpy2605/voron/V0/Dragon_Burner/STLs/v0.2/Orbiter_v2_pattern_mounts/Hotend_Mounts/Chube_Compact_Mount.stl

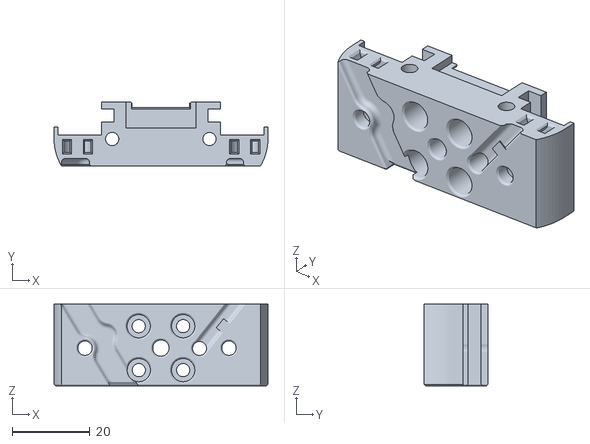
[picture p360: CAD file, 2025-10-09]
V0/Dragon_Burner/STLs/v0.2/Orbiter_v2_pattern_mounts/Hotend_Mounts/Chube_Compact_Mount.stl
55.0 x 16.5 x 21.0
