chirpy2605/voron/V0/Dragon_Burner/STLs/v0.2/Sherpa_Micro/Extruder_Mounts/Sherpa_Micro_Mount.stl

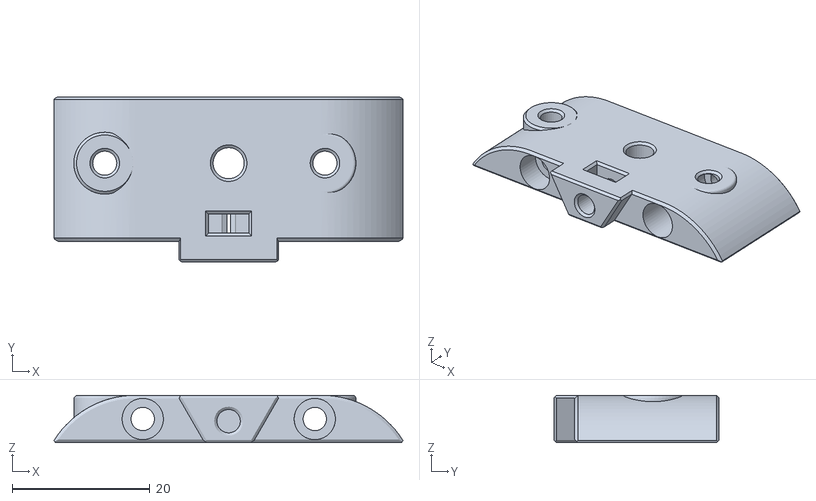
[picture p361: CAD file, 2023-12-18]
V0/Dragon_Burner/STLs/v0.2/Sherpa_Micro/Extruder_Mounts/Sherpa_Micro_Mount.stl
50.7 x 24.0 x 6.90
