chirpy2605/voron/V0/Dragon_Burner/STLs/v0.2/Sherpa_Mini_pattern_mounts/Extruder_Mounts/Sherpa_Mini_Mount.stl

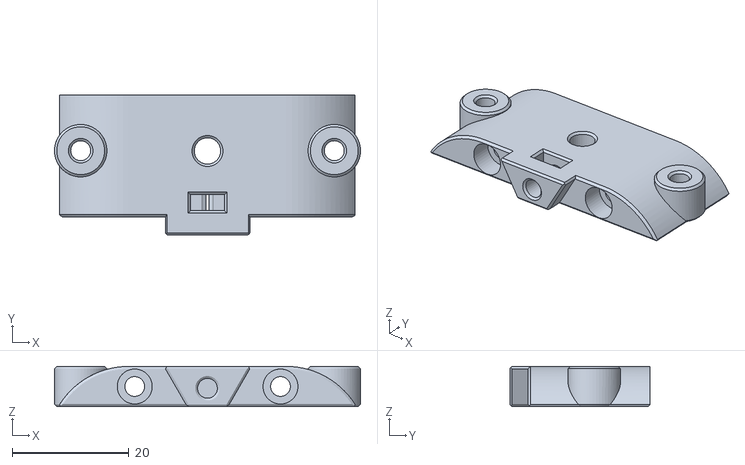
[picture p362: CAD file, 2023-10-14]
V0/Dragon_Burner/STLs/v0.2/Sherpa_Mini_pattern_mounts/Extruder_Mounts/Sherpa_Mini_Mount.stl
52.5 x 24.1 x 6.90
