chirpy2605/voron/V0/Dragon_Burner/STLs/v0.2/Spacer_5mm.stl

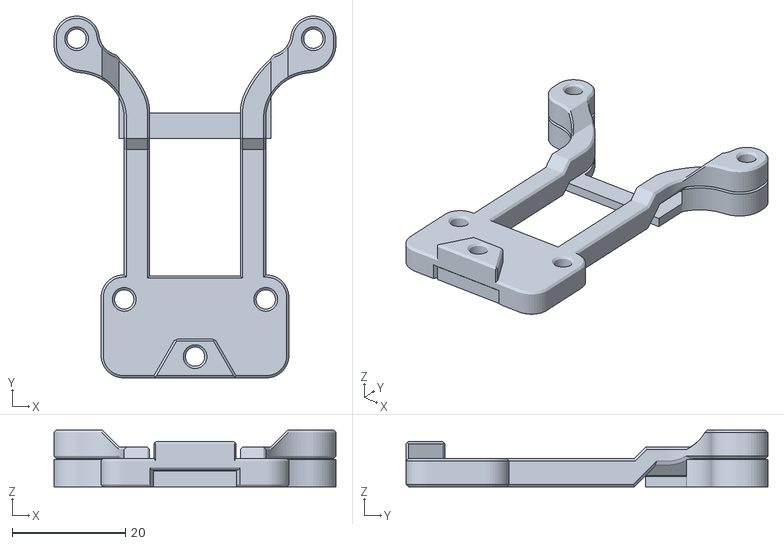
[picture p363: CAD file, 2025-10-10]
V0/Dragon_Burner/STLs/v0.2/Spacer_5mm.stl
49.8 x 63.9 x 10.0
