chirpy2605/voron/V0/Dragon_Burner_Cutter/STLs/Top_LGXLite_Hextrudort_Runout.stl

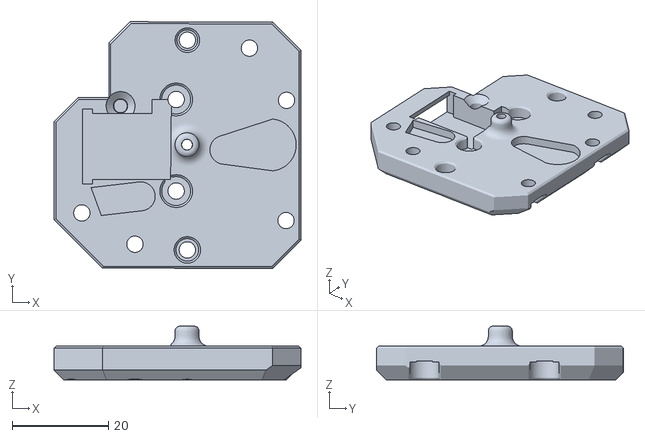
[picture p364: CAD file, 2024-07-04]
V0/Dragon_Burner_Cutter/STLs/Top_LGXLite_Hextrudort_Runout.stl
51.2 x 51.1 x 11.1
