chirpy2605/voron/V0/Lift-Off_Tophat_Hinges/CAD/Lift-Off_Tophat_Hinges.step

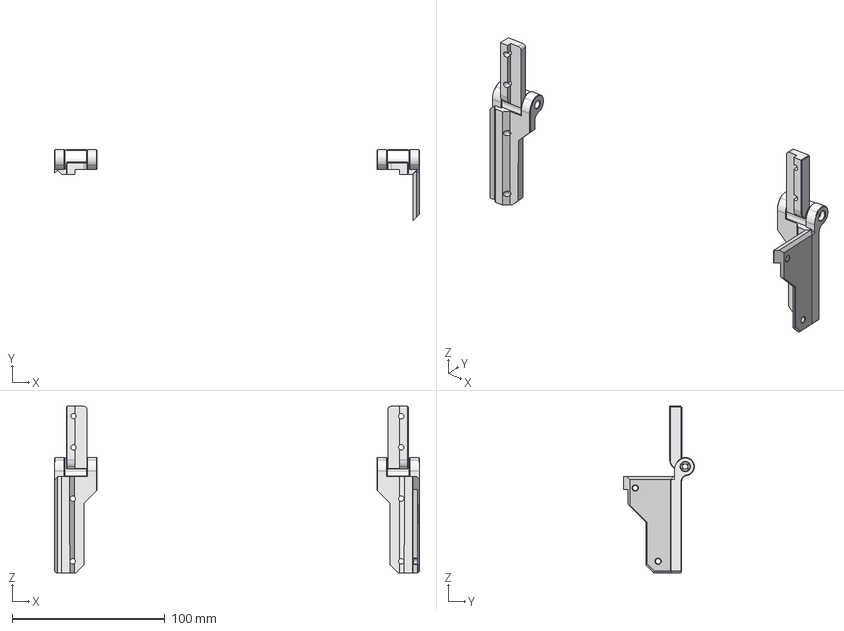
[picture p365: CAD file, 2023-11-21]
V0/Lift-Off_Tophat_Hinges/CAD/Lift-Off_Tophat_Hinges.step
238.9 x 46.4 x 109.0 mm
Hinge_Top_Right
Support
Right Top Panel Clip
Support(Mirror) (5)
Hinge_Top_Left (6)
