chirpy2605/voron/V0/Lift-Off_Tophat_Hinges/STLs/Hinge_Bottom_Left.stl

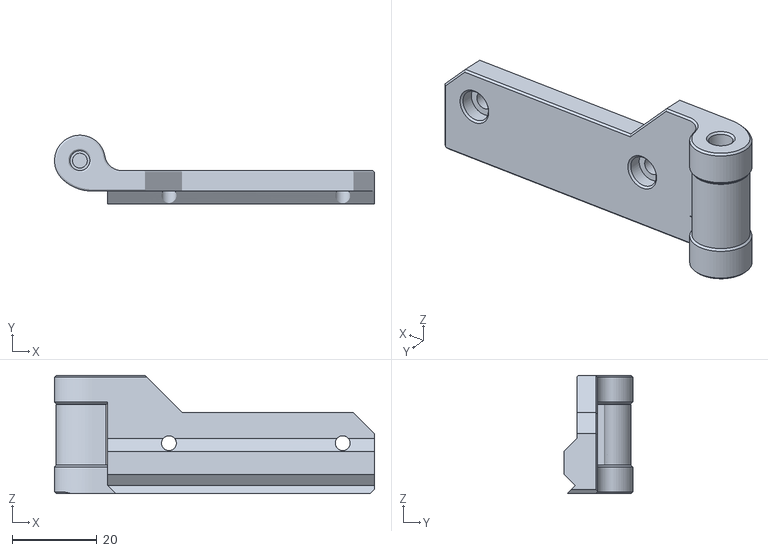
[picture p366: CAD file, 2023-03-14]
V0/Lift-Off_Tophat_Hinges/STLs/Hinge_Bottom_Left.stl
75.5 x 16.2 x 27.9
