chirpy2605/voron/V0/Mailbox/STLs/Fan_Cover.stl

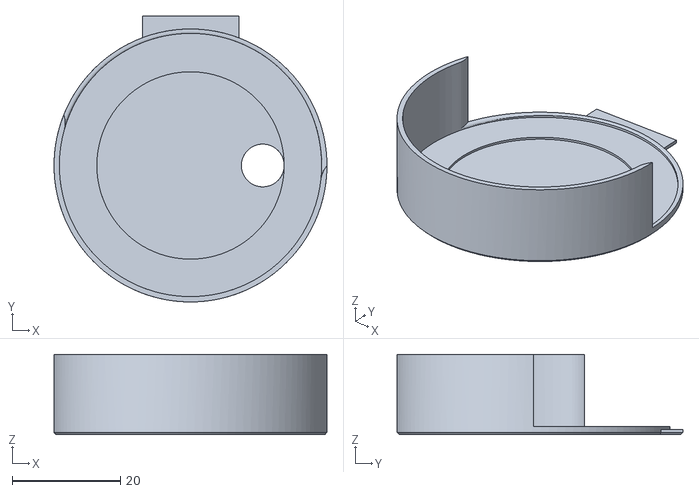
[picture p367: CAD file, 2023-02-02]
V0/Mailbox/STLs/Fan_Cover.stl
50.5 x 52.9 x 14.9
