chirpy2605/voron/V0/Mailbox/STLs/v0_2/Bowden_Mount.stl

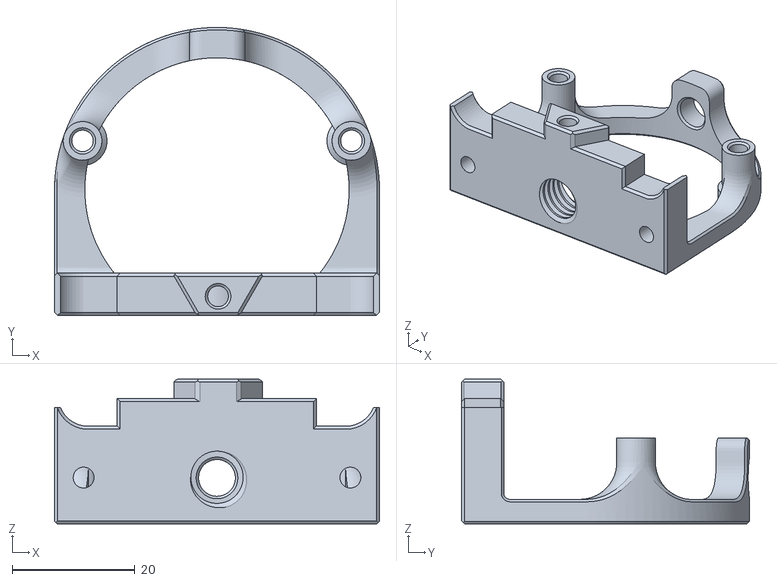
[picture p368: CAD file, 2023-02-27]
V0/Mailbox/STLs/v0_2/Bowden_Mount.stl
53.0 x 47.0 x 23.6
