chirpy2605/voron/V0/NozzleWiper/CAD/NozzleWiper_v2.step

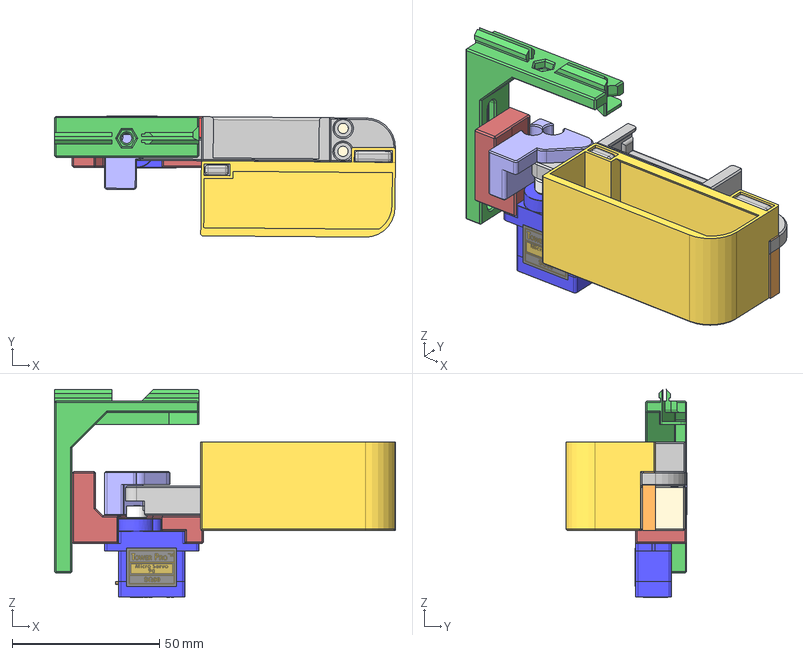
[picture p369: CAD file, 2022-11-20]
V0/NozzleWiper/CAD/NozzleWiper_v2.step
116.0 x 41.3 x 70.7 mm
Servo_Arm
Parallel_Arm
RailMountSide (1)
RailMountTop (1)
ProbeCarrierBottom (1)
ProbeCarrierTop (1)
91290A111_NO THREADS_Alloy Steel Socket Head Screw (2) x 2
6x3 Magnet (1)
16mm 4x2 PTFE Tube (2) x 2
SG90 - Micro Servo 9g - Tower Pro.1_Pea
SG90 - Micro Servo 9g - Tower Pro.2_Pea
SG90 - Micro Servo 9g - Tower Pro.6_BS EN ISO 7045 - M2 x 4 - Z - 4S
Bucket
Frame_Mount
Servo_Mount_SG90
Tool_Carrier (1)
M3 Threaded Insert x 6
