chirpy2605/voron/V0/Rainbow_Dragon/STLs/Front_Mount_Plate.stl

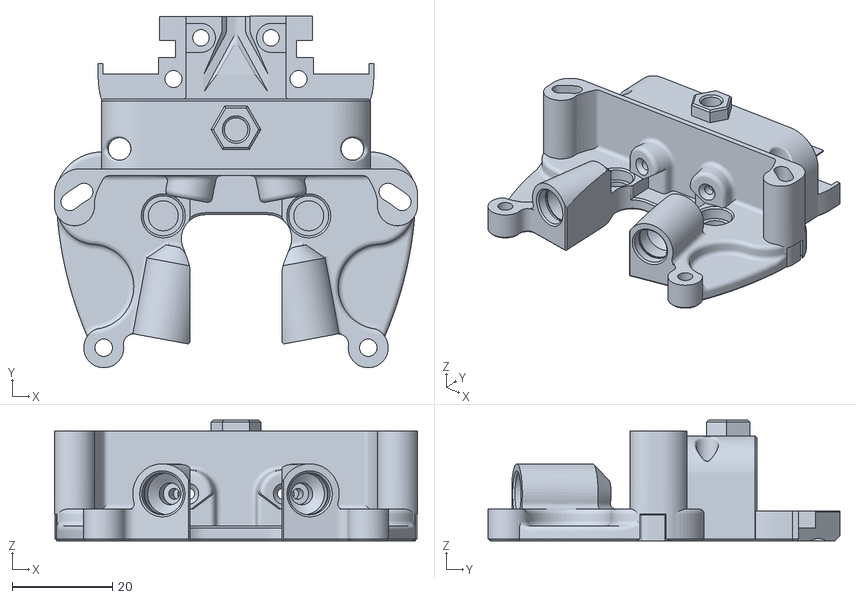
[picture p370: CAD file, 2023-08-19]
V0/Rainbow_Dragon/STLs/Front_Mount_Plate.stl
72.5 x 70.2 x 24.2
