chirpy2605/voron/V0/Rapid_Burner/STLs/ADXL_Mount_Front.stl

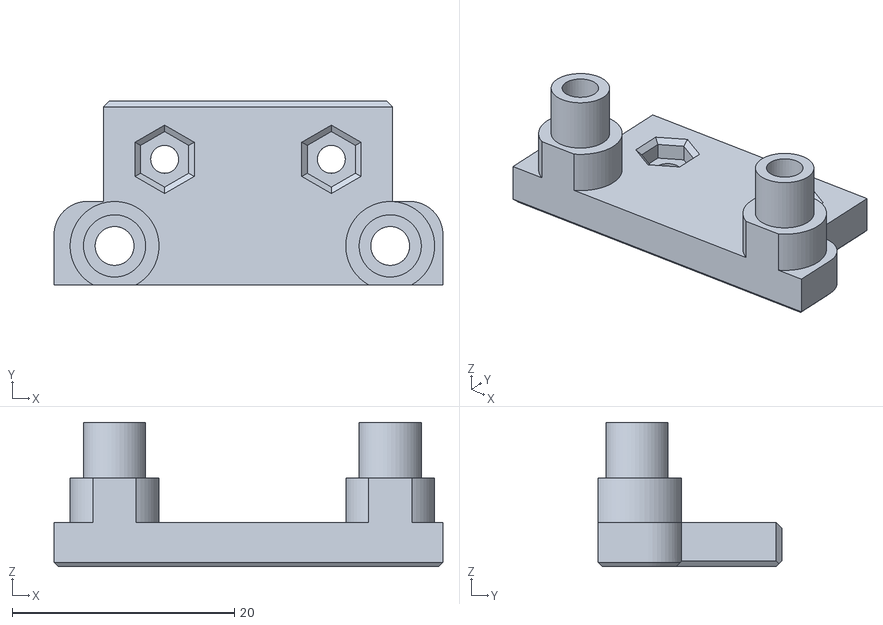
[picture p371: CAD file, 2023-03-07]
V0/Rapid_Burner/STLs/ADXL_Mount_Front.stl
35.0 x 16.5 x 13.0
