chirpy2605/voron/V0/Rapid_Burner/STLs/v0.2/Cowl_NoProbe.stl

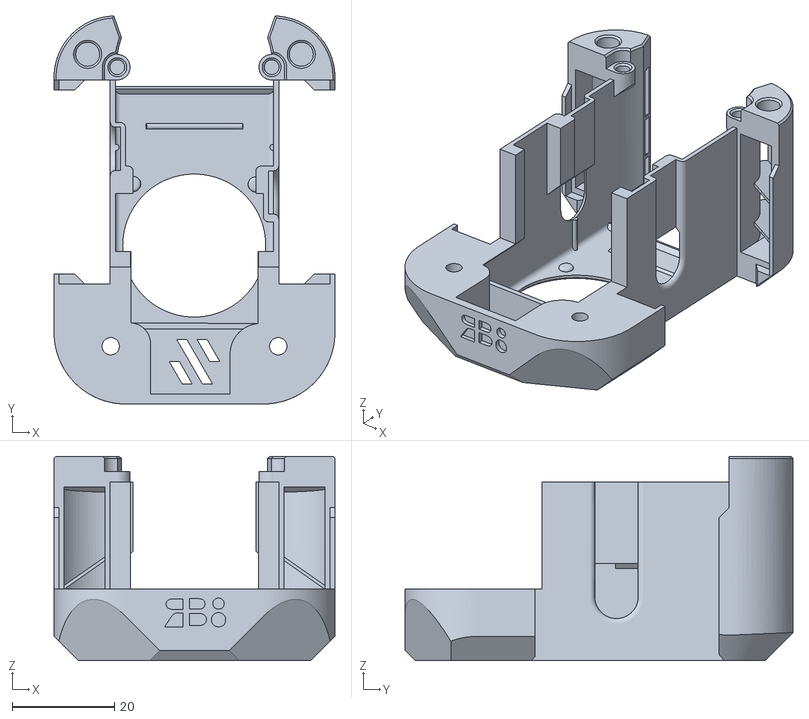
[picture p372: CAD file, 2023-11-25]
V0/Rapid_Burner/STLs/v0.2/Cowl_NoProbe.stl
55.0 x 76.0 x 40.0
