chirpy2605/voron/V0/Rapid_Burner/STLs/v0.2/Goliath/Cowl_Goliath_Air_Klicky.stl

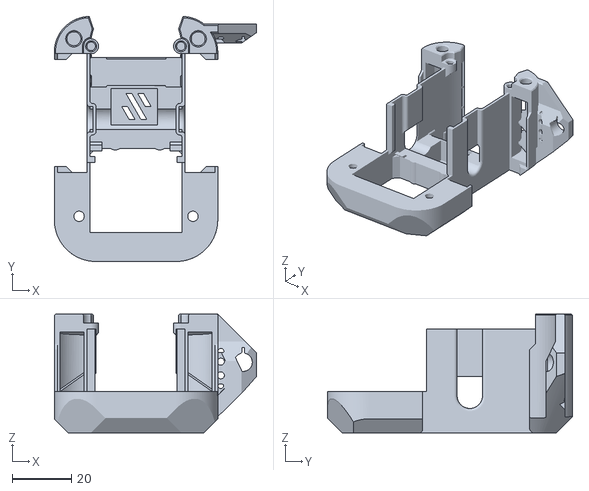
[picture p373: CAD file, 2023-10-29]
V0/Rapid_Burner/STLs/v0.2/Goliath/Cowl_Goliath_Air_Klicky.stl
68.1 x 82.4 x 40.0
