chirpy2605/voron/V0/Rapid_Burner/STLs/v0.2/Micron_Cowl/CatCowl_NoProbe.stl

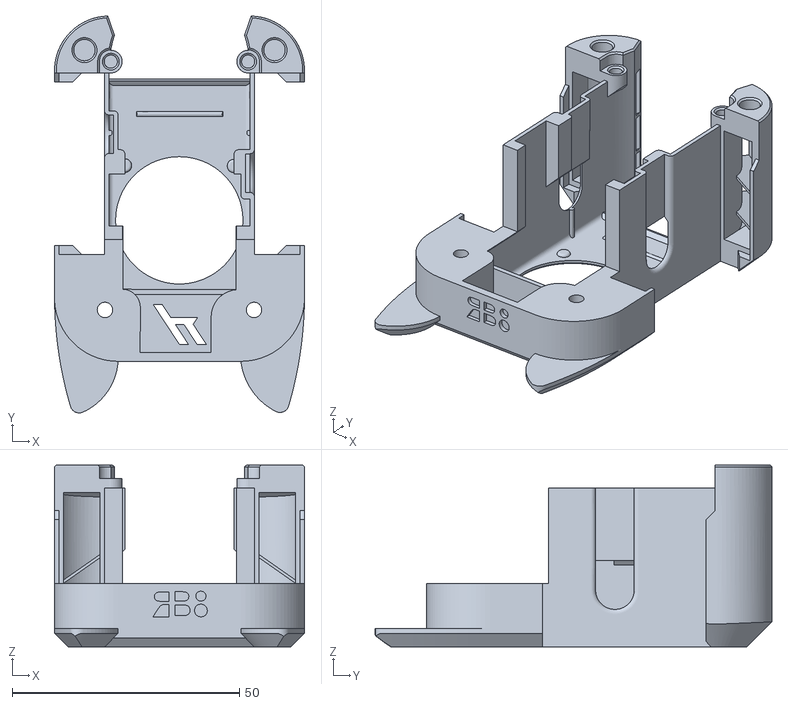
[picture p374: CAD file, 2024-01-19]
V0/Rapid_Burner/STLs/v0.2/Micron_Cowl/CatCowl_NoProbe.stl
55.0 x 87.3 x 40.0
