chirpy2605/voron/V0/Rapid_Burner/STLs/v0.2/v6_Volcano/Sherpa_Micro_Mount_Back.stl

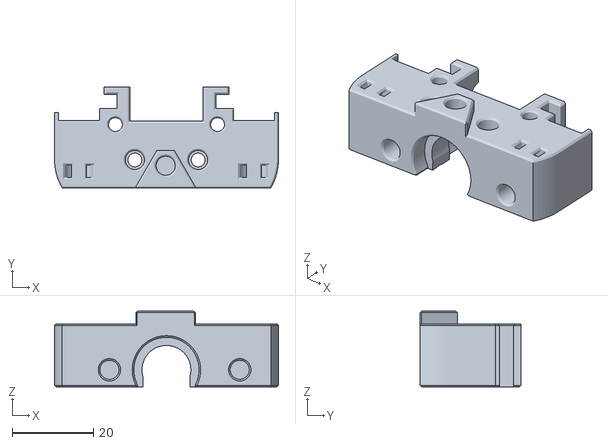
[picture p375: CAD file, 2024-02-16]
V0/Rapid_Burner/STLs/v0.2/v6_Volcano/Sherpa_Micro_Mount_Back.stl
55.0 x 24.8 x 18.6
