chirpy2605/voron/V0/Rapid_Burner/STLs/v0_2/DFA_Mount.stl

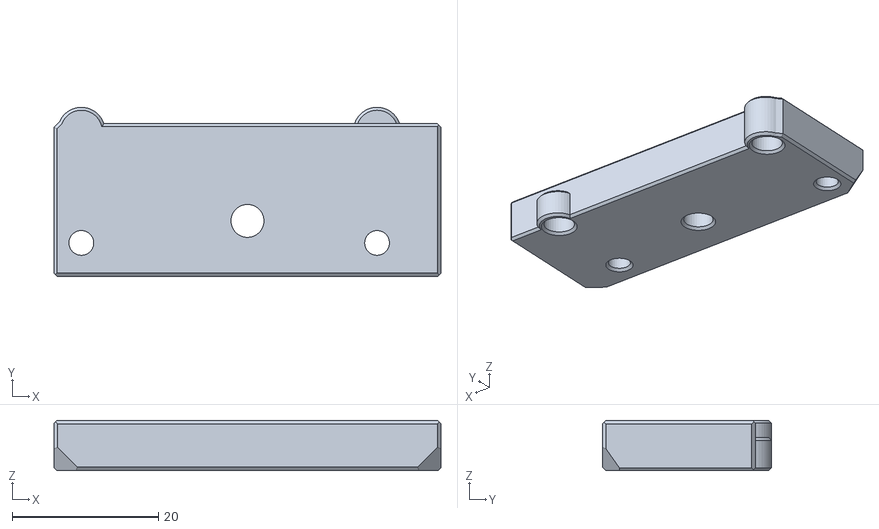
[picture p376: CAD file, 2023-05-26]
V0/Rapid_Burner/STLs/v0_2/DFA_Mount.stl
53.0 x 23.2 x 6.90
