chirpy2605/voron/V0/Rapid_Burner/STLs/v0_2/Goliath/Cowl_Klicky_Integrated_Air.stl

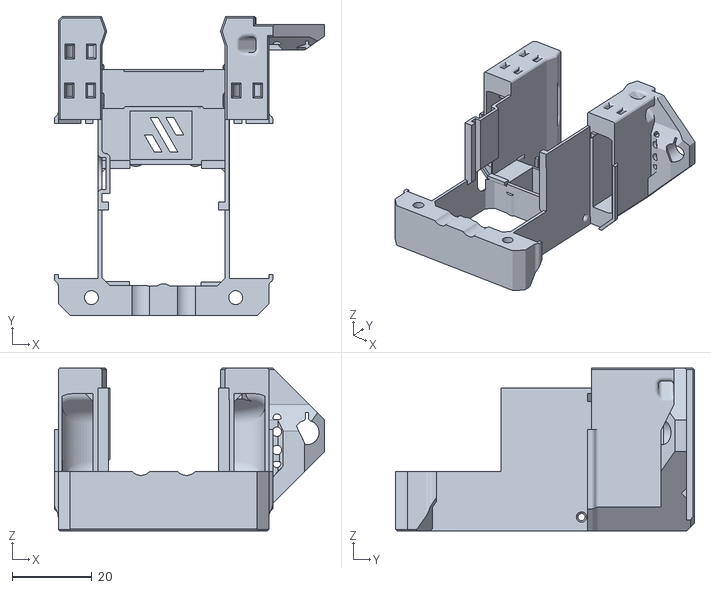
[picture p377: CAD file, 2023-06-09]
V0/Rapid_Burner/STLs/v0_2/Goliath/Cowl_Klicky_Integrated_Air.stl
68.0 x 75.2 x 41.0
