chirpy2605/voron/V0/Rapid_Burner/STLs/v0_2/UHF/Cowl_KlickyNG.stl

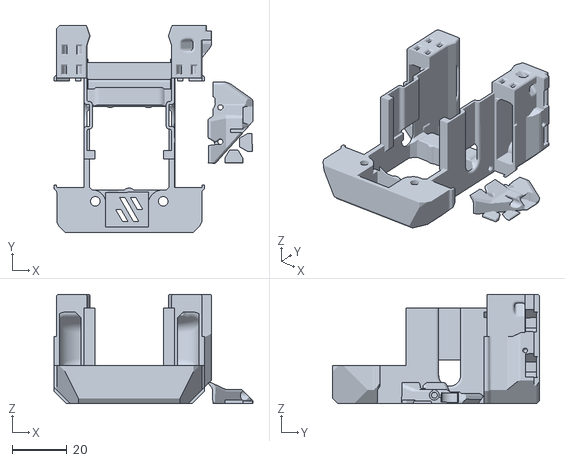
[picture p378: CAD file, 2023-06-09]
V0/Rapid_Burner/STLs/v0_2/UHF/Cowl_KlickyNG.stl
72.7 x 75.5 x 40.0
