chirpy2605/voron/V0/StovePipe/STLs/KUSBA_Mount.stl

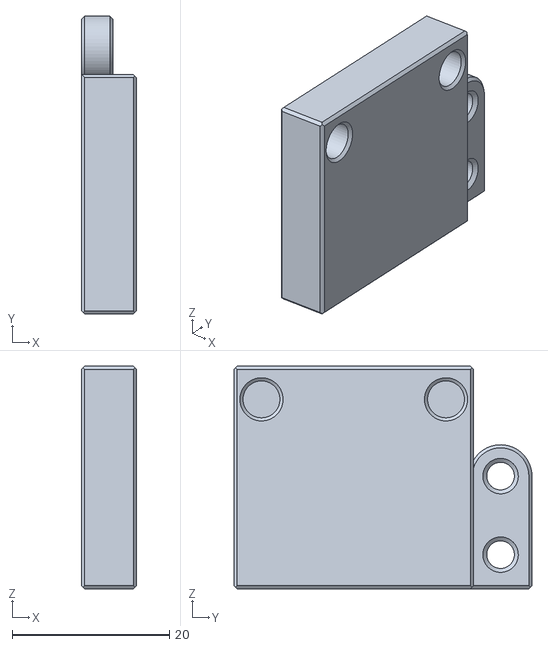
[picture p379: CAD file, 2022-12-28]
V0/StovePipe/STLs/KUSBA_Mount.stl
7.00 x 37.9 x 28.4
