chirpy2605/voron/V0/StovePipe/STLs/UHF/Cowl_UHF_ZeroClick.stl

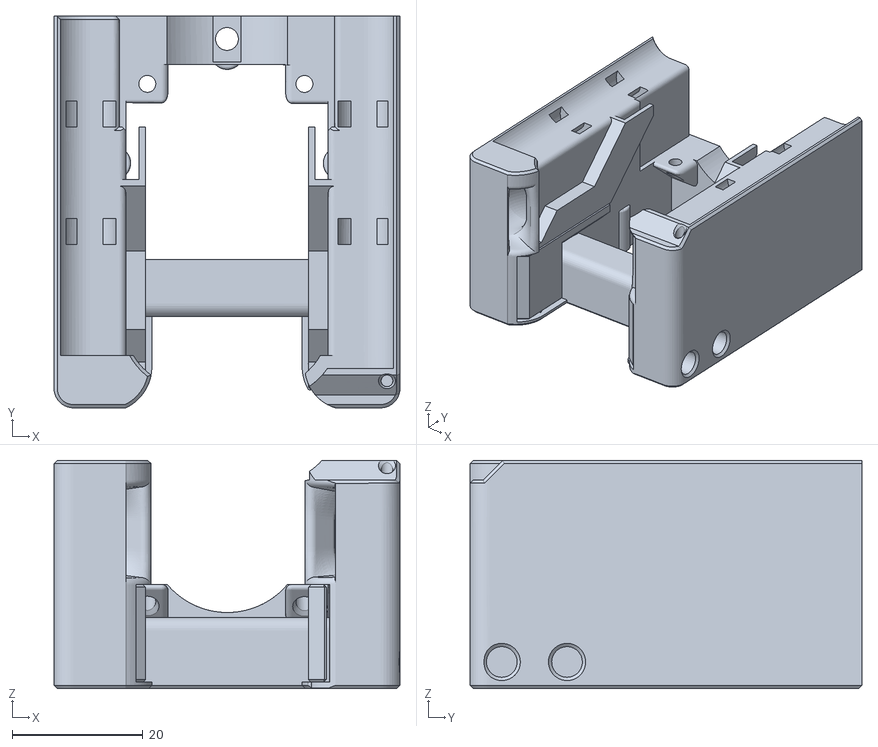
[picture p380: CAD file, 2022-12-19]
V0/StovePipe/STLs/UHF/Cowl_UHF_ZeroClick.stl
53.0 x 60.0 x 35.0
