chirpy2605/voron/V0/TipTophat/STLs/Peg_1_x2.stl

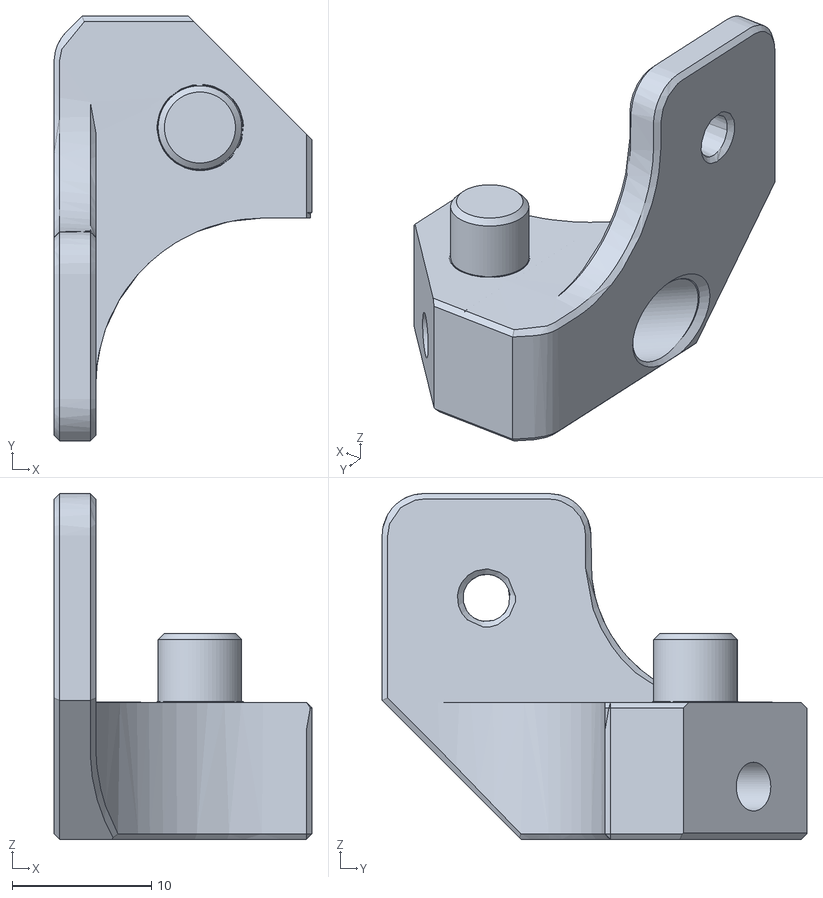
[picture p381: CAD file, 2022-11-04]
V0/TipTophat/STLs/Peg_1_x2.stl
18.5 x 30.5 x 24.8
