chirpy2605/voron/V0/Tophat_Cat_Flap/STLs/Top Panel Clip.stl

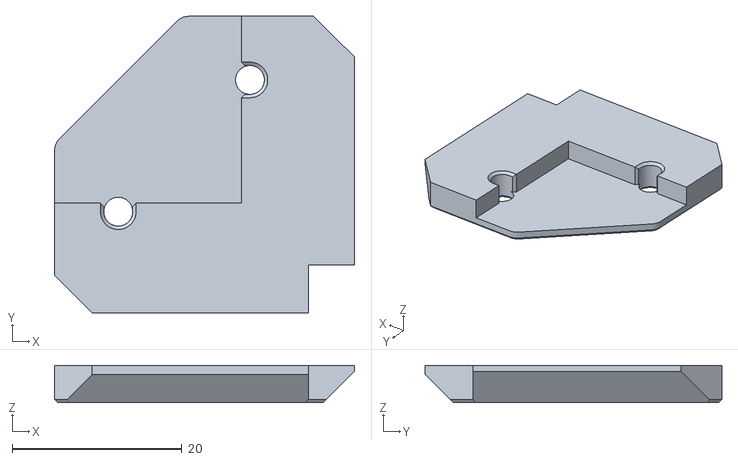
[picture p382: CAD file, 2023-03-14]
V0/Tophat_Cat_Flap/STLs/Top Panel Clip.stl
35.3 x 34.9 x 4.40
