chirpy2605/voron/V0/v0.2_Stuff/CAD/[a]_Z_Cover.step

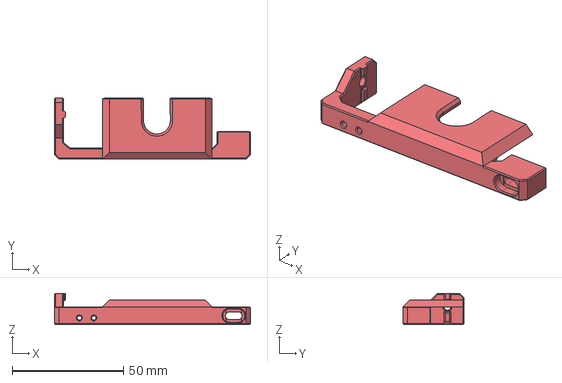
[picture p383: CAD file, 2023-05-15]
V0/v0.2_Stuff/CAD/[a]_Z_Cover.step
88.0 x 27.5 x 14.0 mm
