chirpy2605/voron/V0/v0.2_Stuff/STLs/Rear_Panel_Hex_Mesh.stl

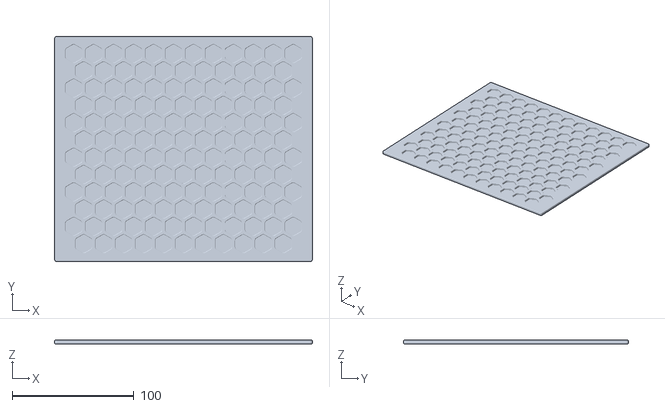
[picture p384: CAD file, 2023-04-08]
V0/v0.2_Stuff/STLs/Rear_Panel_Hex_Mesh.stl
212.0 x 185.0 x 3.00
