chirpy2605/voron/V0/XCarriage_v0_2/CAD/X_Carriage_Inserts.step

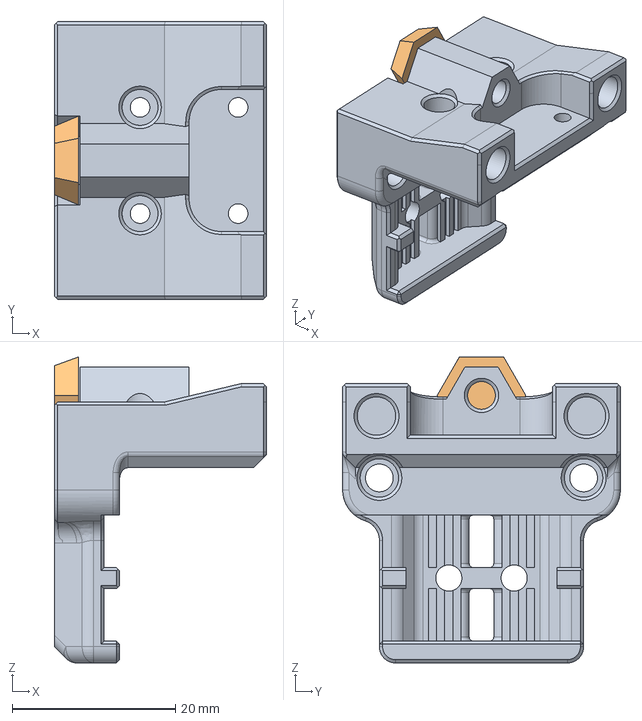
[picture p385: CAD file, 2023-01-17]
V0/XCarriage_v0_2/CAD/X_Carriage_Inserts.step
26.0 x 34.0 x 37.5 mm
