chirpy2605/voron/V0/Yavoth/STLs/Chube_Compact_Spacer.stl

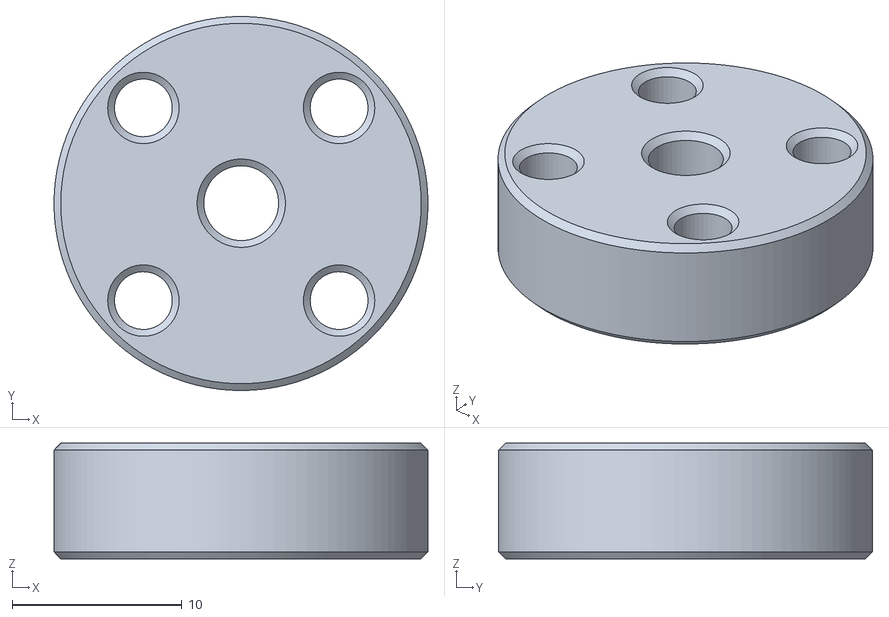
[picture p386: CAD file, 2025-10-10]
V0/Yavoth/STLs/Chube_Compact_Spacer.stl
22.0 x 22.0 x 6.80
