chirpy2605/voron/V0/Yavoth/STLs/Orbiter_v2_Spacing/Cowl_Chube_Compact_OB2_UHF_5mm.stl

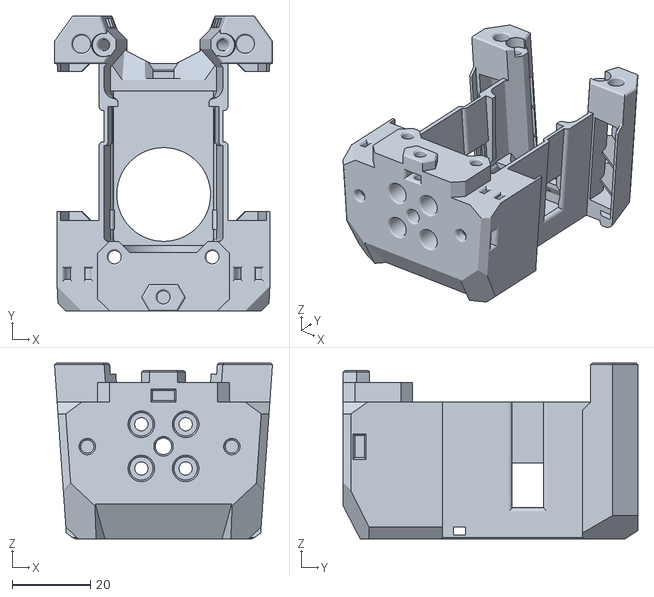
[picture p387: CAD file, 2025-10-10]
V0/Yavoth/STLs/Orbiter_v2_Spacing/Cowl_Chube_Compact_OB2_UHF_5mm.stl
55.8 x 75.5 x 45.0
