chirpy2605/voron/V0/Yavoth/STLs/Sherpa_Micro_Spacing/Cowl_Chube_Compact_Micro.stl

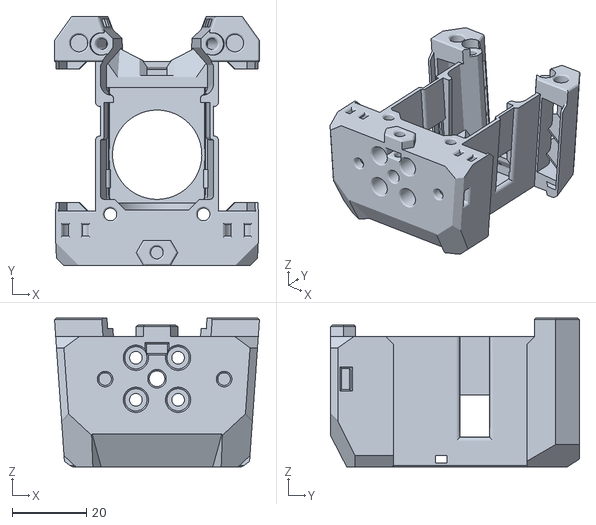
[picture p388: CAD file, 2025-10-10]
V0/Yavoth/STLs/Sherpa_Micro_Spacing/Cowl_Chube_Compact_Micro.stl
55.1 x 67.0 x 40.0
