chirpy2605/voron/V0/Yavoth/STLs/Sherpa_Mini_Spacing/Cowl_Chube_Compact_SM_5mm.stl

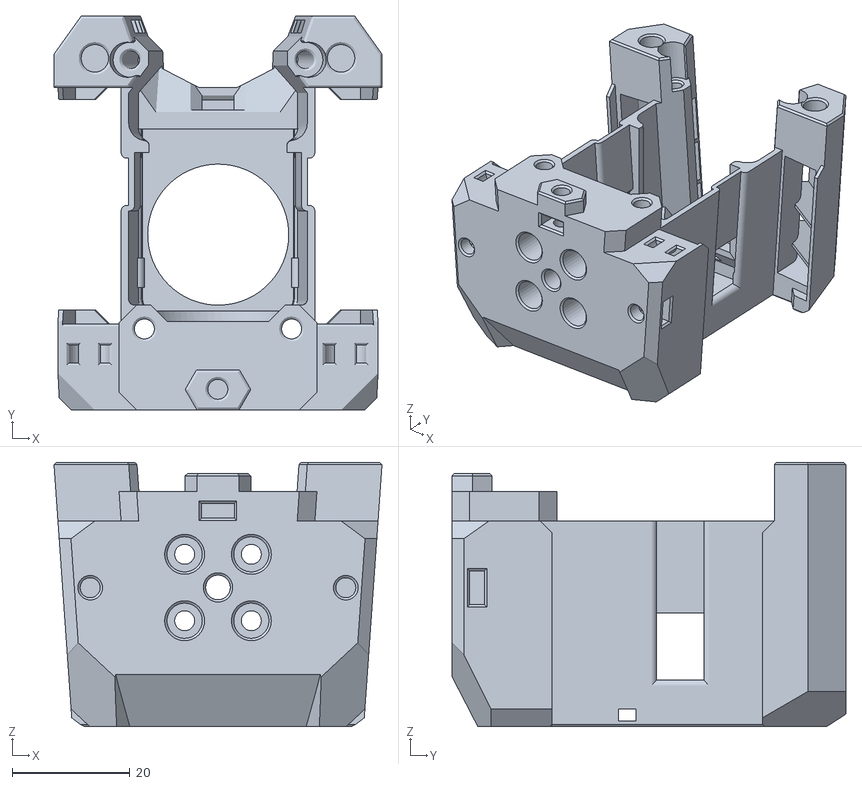
[picture p389: CAD file, 2025-10-10]
V0/Yavoth/STLs/Sherpa_Mini_Spacing/Cowl_Chube_Compact_SM_5mm.stl
55.8 x 67.0 x 45.0
