chirpy2605/voron/general/Alternative_Voron_Mounts/Extended_Extruder_Mounts/Sherpa_Mini_Extruder_Mount.stl

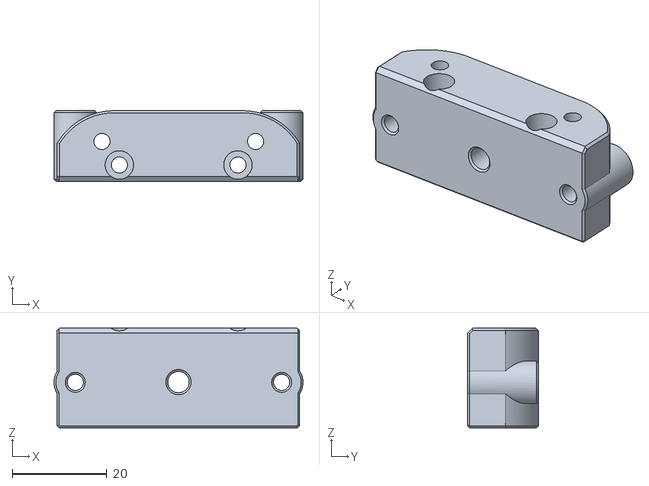
[picture p390: CAD file, 2024-02-20]
general/Alternative_Voron_Mounts/Extended_Extruder_Mounts/Sherpa_Mini_Extruder_Mount.stl
52.5 x 14.9 x 21.0
