chirpy2605/voron/general/Alternative_Voron_Mounts/Modified_Mounts/Micron_Pandora/STLs/Spacer_3mm/Bottom_Spacers.stl

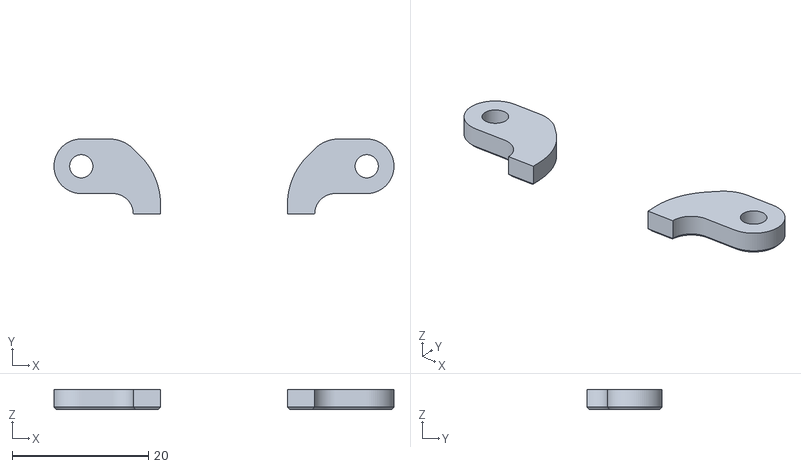
[picture p391: CAD file, 2023-12-04]
general/Alternative_Voron_Mounts/Modified_Mounts/Micron_Pandora/STLs/Spacer_3mm/Bottom_Spacers.stl
49.8 x 11.0 x 3.00
