chirpy2605/voron/general/Alternative_Voron_Mounts/Modified_Mounts/Micron_Pandora/STLs/X_Carriage_MGN9C_Micron_Long.stl

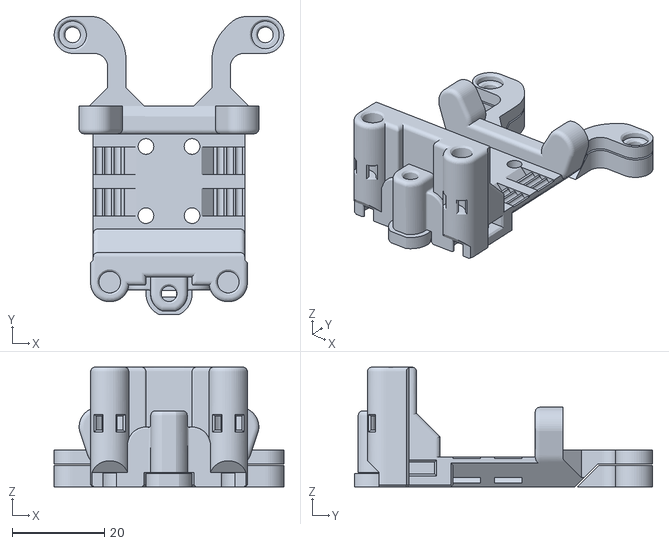
[picture p392: CAD file, 2024-05-27]
general/Alternative_Voron_Mounts/Modified_Mounts/Micron_Pandora/STLs/X_Carriage_MGN9C_Micron_Long.stl
49.8 x 64.6 x 26.0
