chirpy2605/voron/general/Alternative_Voron_Mounts/Modified_Mounts/V1_V2/STLs/Carriage_Bases/Carriage_Base_EndStop_Long.stl

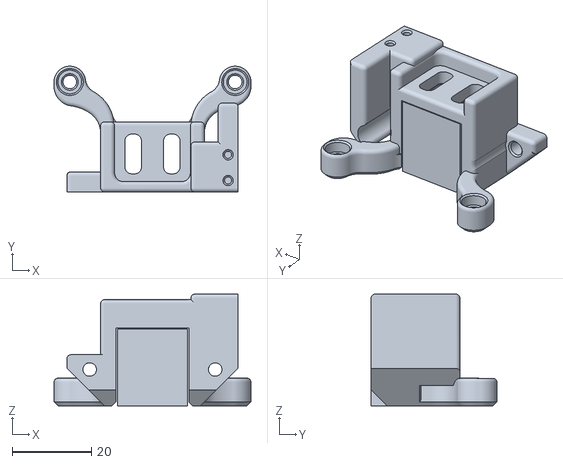
[picture p394: CAD file, 2024-05-03]
general/Alternative_Voron_Mounts/Modified_Mounts/V1_V2/STLs/Carriage_Bases/Carriage_Base_EndStop_Long.stl
49.8 x 31.8 x 28.2
