chirpy2605/voron/general/Alternative_Voron_Mounts/Modified_Mounts/V1_V2/STLs/MGN9H/Probe_Spacer.stl

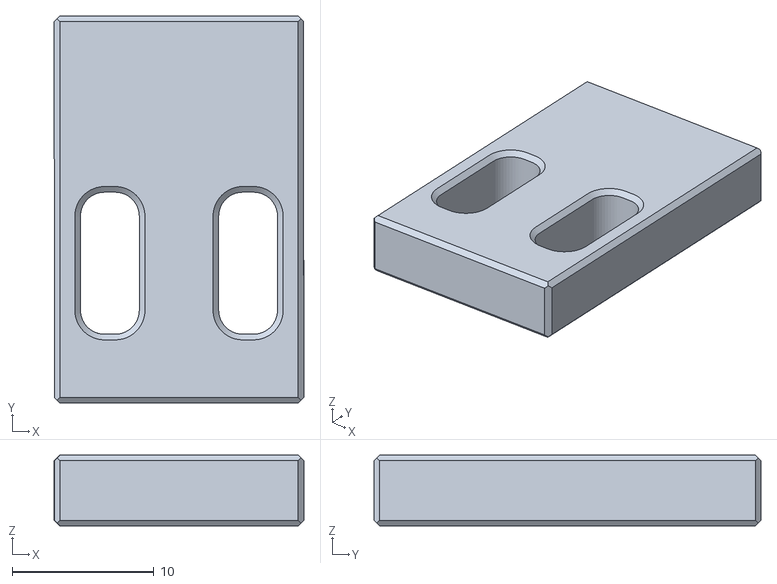
[picture p396: CAD file, 2023-11-12]
general/Alternative_Voron_Mounts/Modified_Mounts/V1_V2/STLs/MGN9H/Probe_Spacer.stl
17.6 x 27.3 x 5.00
