chirpy2605/voron/general/CraneFly/STLs/Strain_Relief_PCB_Bowden_VD.stl

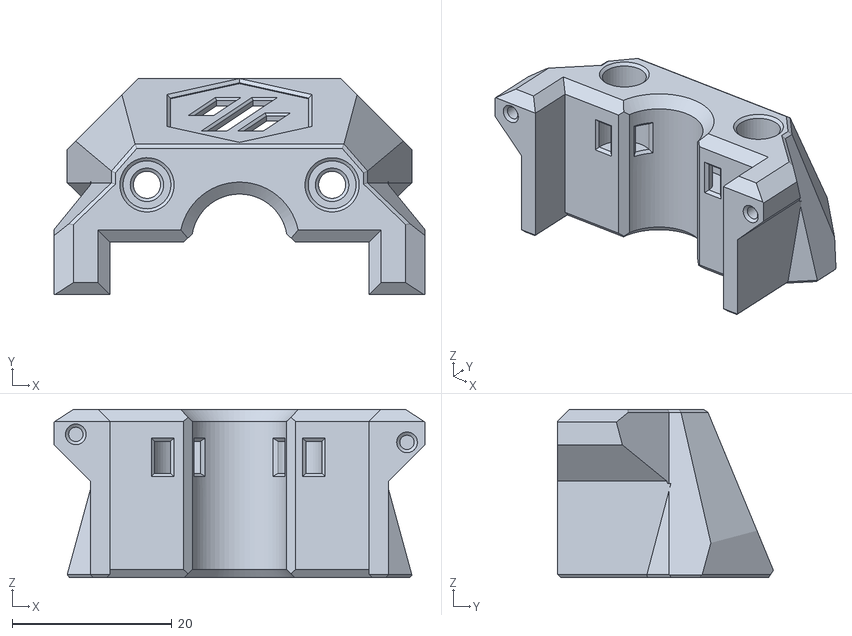
[picture p397: CAD file, 2024-07-06]
general/CraneFly/STLs/Strain_Relief_PCB_Bowden_VD.stl
46.5 x 27.1 x 21.1
