chirpy2605/voron/general/DB_Ornament/STLs/[a]_Revo Voron.stl

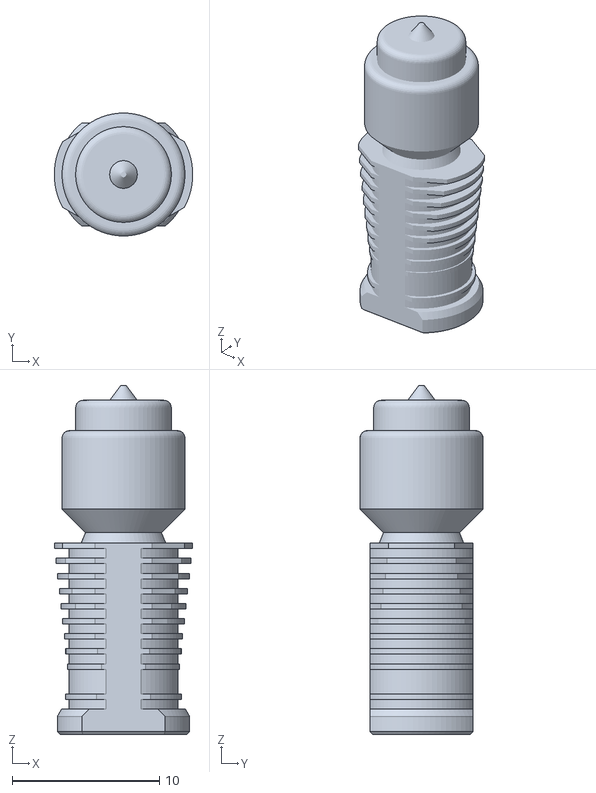
[picture p398: CAD file, 2023-12-04]
general/DB_Ornament/STLs/[a]_Revo Voron.stl
9.40 x 8.35 x 23.7
