chirpy2605/voron/general/Experimental/Peck/STLs/SherpaMini_Mount_Pattern/Revo_Voron_Mount.stl

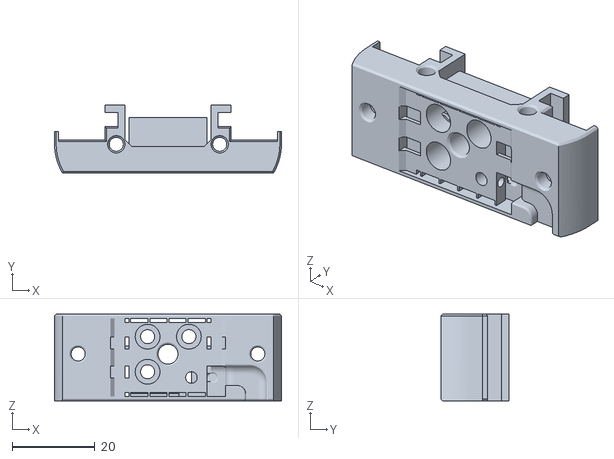
[picture p400: CAD file, 2024-05-04]
general/Experimental/Peck/STLs/SherpaMini_Mount_Pattern/Revo_Voron_Mount.stl
55.0 x 16.5 x 21.0
