chirpy2605/voron/general/Large_Voron_Mounts/Dragon_Burner/Tap_or_Chain/Standard_Mount.stl

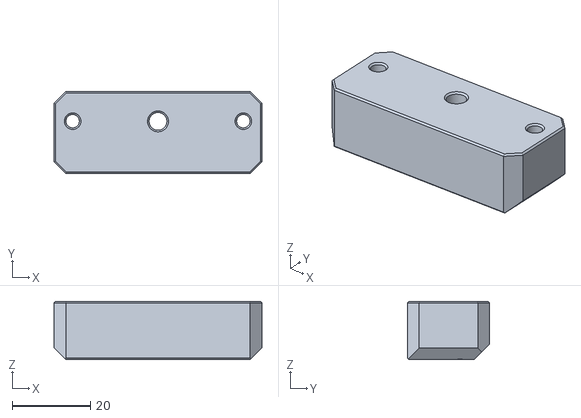
[picture p401: CAD file, 2023-05-25]
general/Large_Voron_Mounts/Dragon_Burner/Tap_or_Chain/Standard_Mount.stl
53.0 x 21.0 x 14.9
