chirpy2605/voron/general/MiniMouse/STLs/MiniMouse_Back.stl

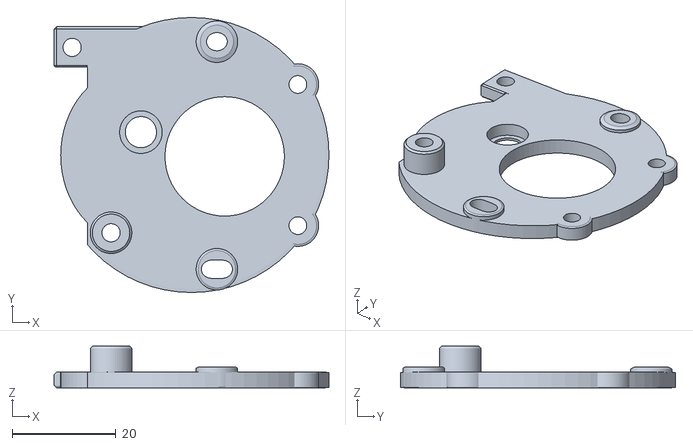
[picture p402: CAD file, 2022-11-04]
general/MiniMouse/STLs/MiniMouse_Back.stl
53.0 x 53.0 x 8.00
