chirpy2605/voron/general/PCB_Mounts/STLs/RoundTrip_OB1/RoundTrip_OB1_Short_x2.stl

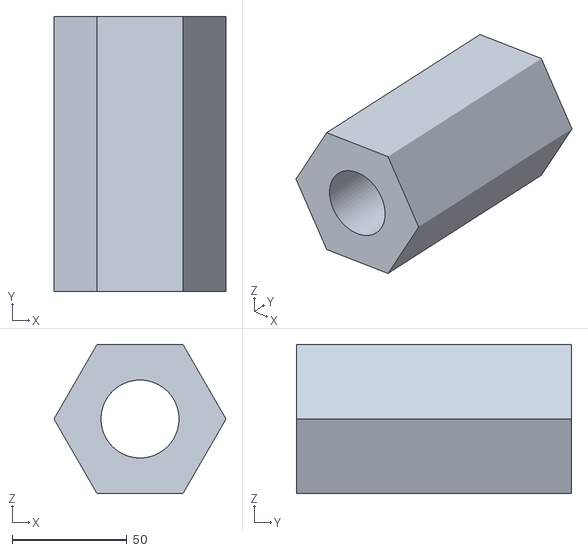
[picture p403: CAD file, 2023-08-01]
general/PCB_Mounts/STLs/RoundTrip_OB1/RoundTrip_OB1_Short_x2.stl
75.0 x 120.0 x 65.0
