chirpy2605/voron/general/PCB_Mounts/STLs/RoundTrip_OB1Reverse/RoundTrip_OB1Reverse_Long_x2.stl

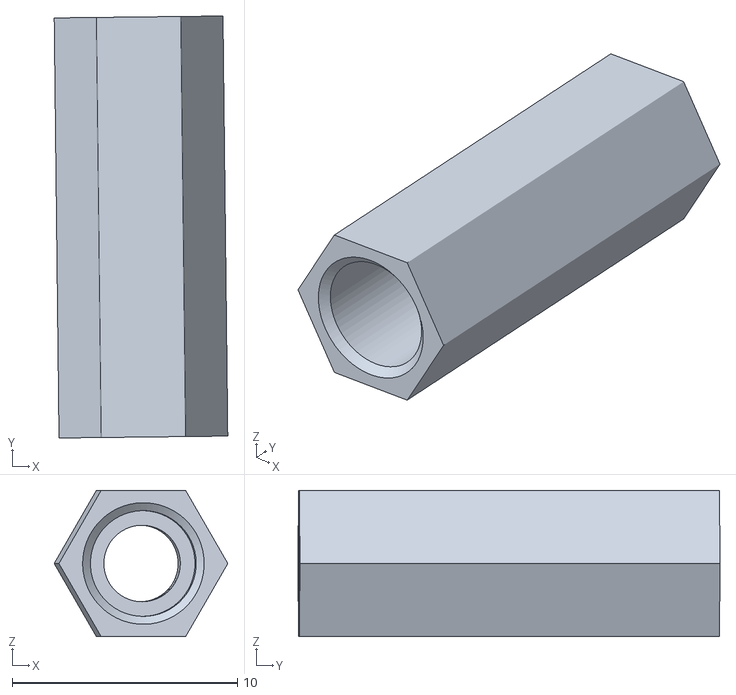
[picture p404: CAD file, 2023-08-01]
general/PCB_Mounts/STLs/RoundTrip_OB1Reverse/RoundTrip_OB1Reverse_Long_x2.stl
7.71 x 18.8 x 6.50
