chirpy2605/voron/general/PCB_Mounts/STLs/RoundTrip_OB2/RoundTrip_OB2_Short_x2.stl

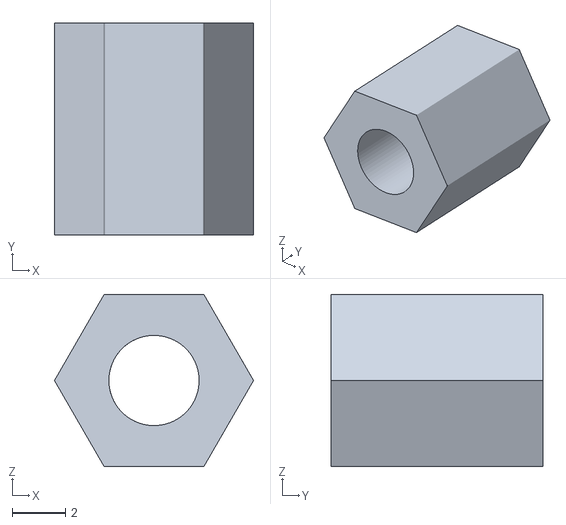
[picture p405: CAD file, 2023-08-01]
general/PCB_Mounts/STLs/RoundTrip_OB2/RoundTrip_OB2_Short_x2.stl
7.50 x 8.00 x 6.50
