chirpy2605/voron/general/PCB_Mounts/STLs/WristWatch_BMG_Carrier_RB.stl

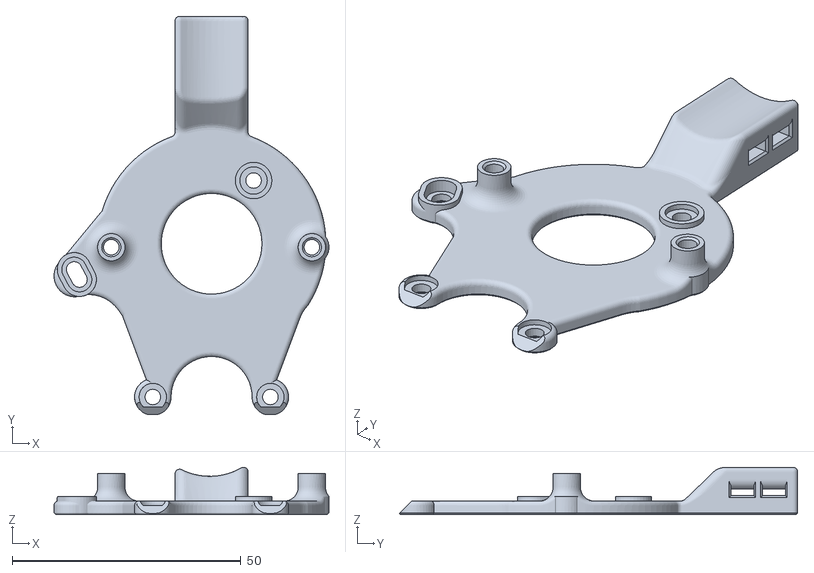
[picture p406: CAD file, 2023-11-02]
general/PCB_Mounts/STLs/WristWatch_BMG_Carrier_RB.stl
60.1 x 87.1 x 10.4
