chirpy2605/voron/general/PCB_Mounts/STLs/WristWatch_G2/WristWatch_G2_Long_x2.stl

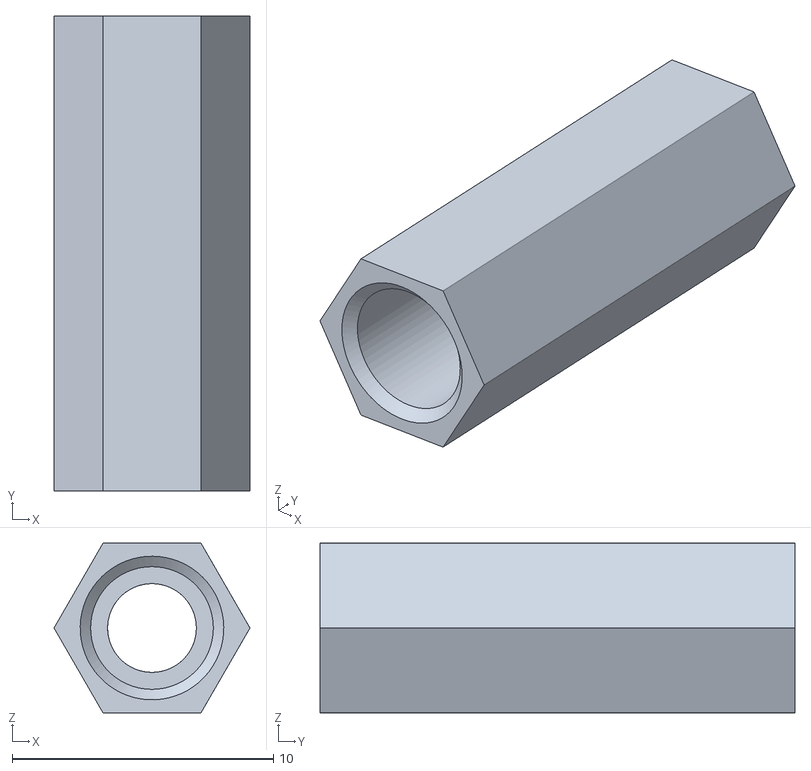
[picture p407: CAD file, 2023-11-02]
general/PCB_Mounts/STLs/WristWatch_G2/WristWatch_G2_Long_x2.stl
7.50 x 18.2 x 6.50
