chirpy2605/voron/general/RoundAbout/STLs/Support_Ring.stl

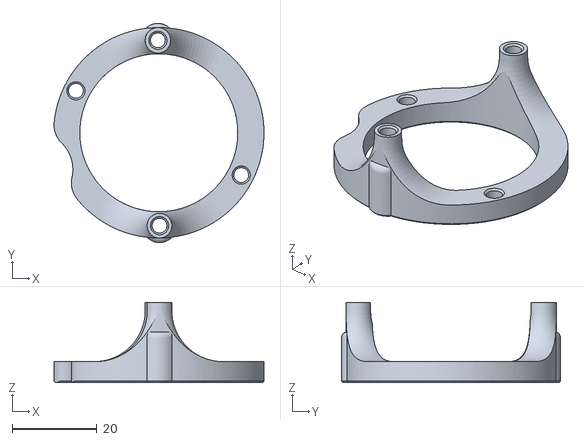
[picture p408: CAD file, 2022-11-04]
general/RoundAbout/STLs/Support_Ring.stl
49.6 x 51.8 x 19.0
