chirpy2605/voron/general/RoundTrip/LGX/STLs/Guidler.stl

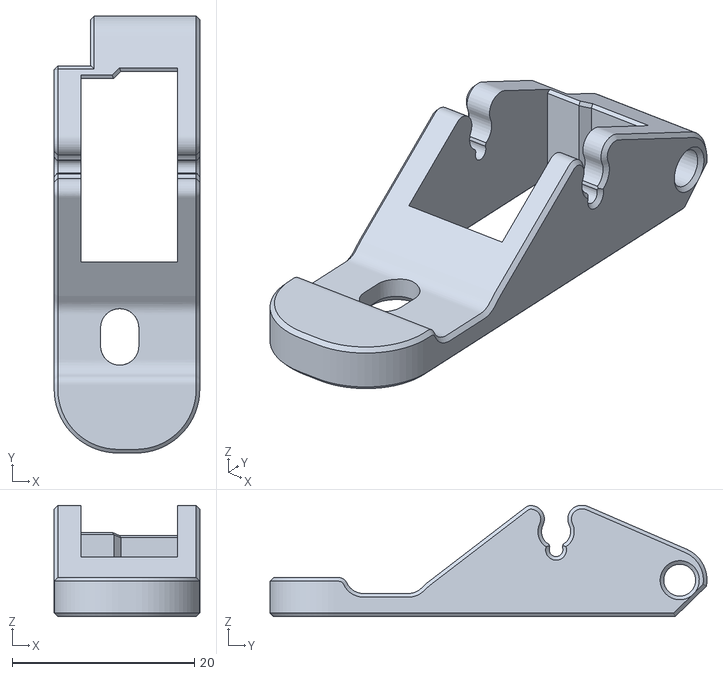
[picture p409: CAD file, 2023-07-26]
general/RoundTrip/LGX/STLs/Guidler.stl
16.0 x 48.0 x 12.2
