chirpy2605/voron/general/RoundTrip/ORB1/CAD/Roundtrip_ORB1_FF_v1.step

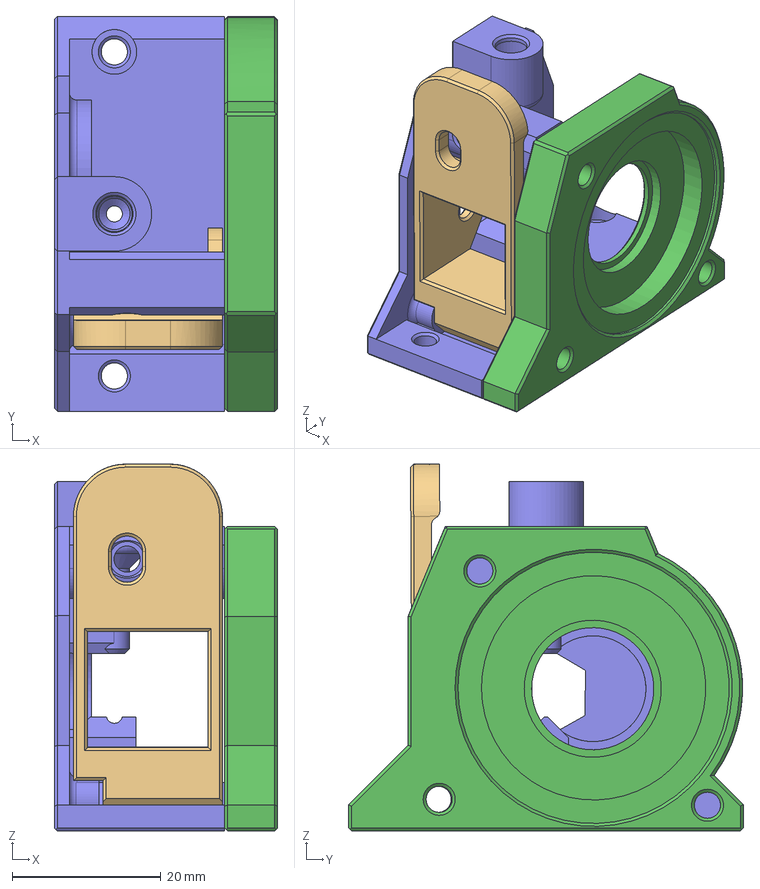
[picture p410: CAD file, 2023-03-28]
general/RoundTrip/ORB1/CAD/Roundtrip_ORB1_FF_v1.step
30.0 x 53.0 x 49.3 mm
Guidler
Front
Back
