chirpy2605/voron/general/RoundTrip/ORB1/STLs/FrontFeed/Guidler.stl

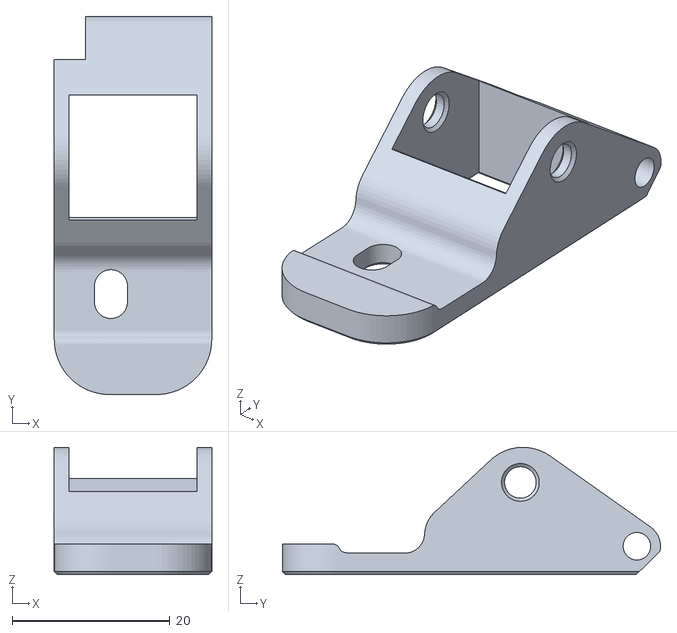
[picture p411: CAD file, 2023-03-28]
general/RoundTrip/ORB1/STLs/FrontFeed/Guidler.stl
20.0 x 48.0 x 16.2
