chirpy2605/voron/general/RoundTrip/ORB2/STLs/FrontFeed/Front.stl

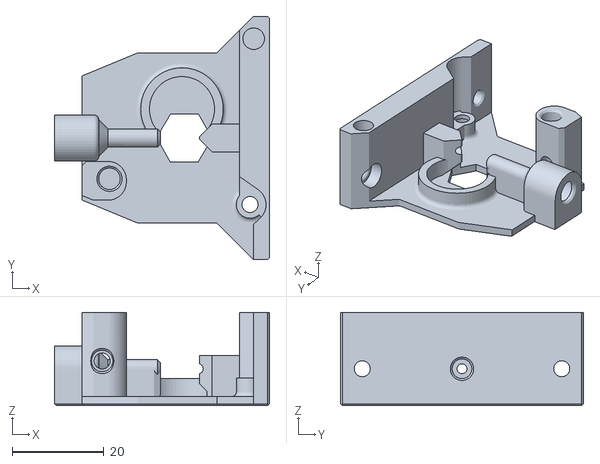
[picture p412: CAD file, 2023-03-28]
general/RoundTrip/ORB2/STLs/FrontFeed/Front.stl
46.9 x 53.0 x 20.4
