chirpy2605/voron/general/RoundTrip/ORB2/STLs/RearFeed/Guidler.stl

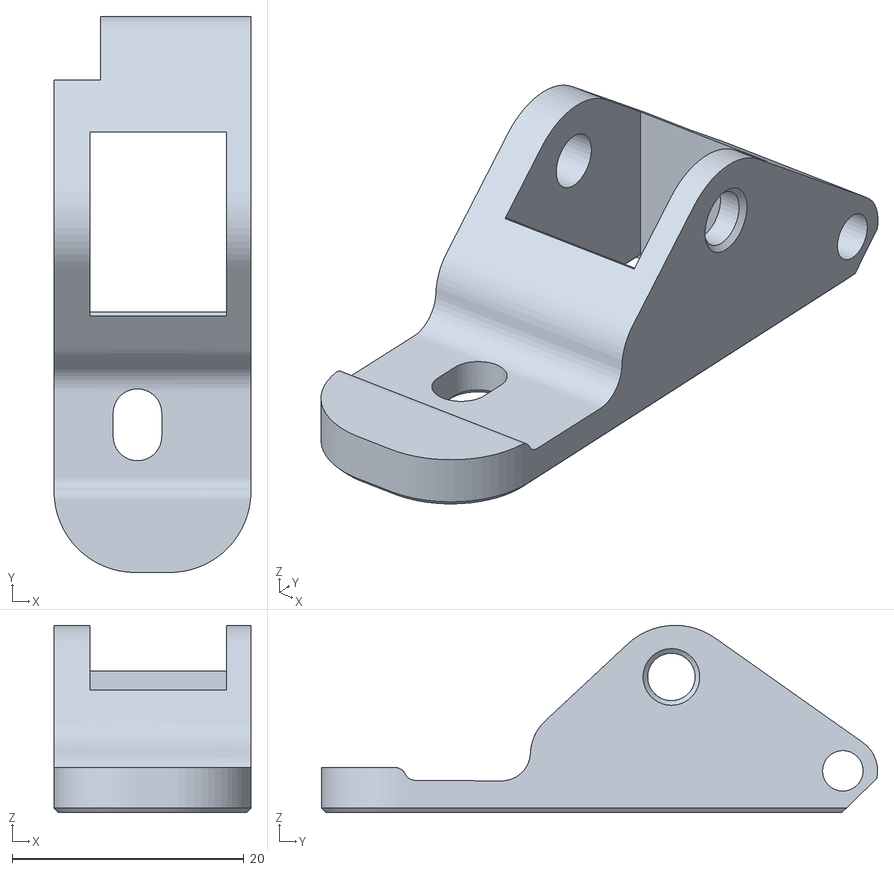
[picture p413: CAD file, 2023-03-28]
general/RoundTrip/ORB2/STLs/RearFeed/Guidler.stl
17.0 x 48.0 x 16.2
