chirpy2605/voron/general/RunoutUnklicky/STLs/Roller.stl

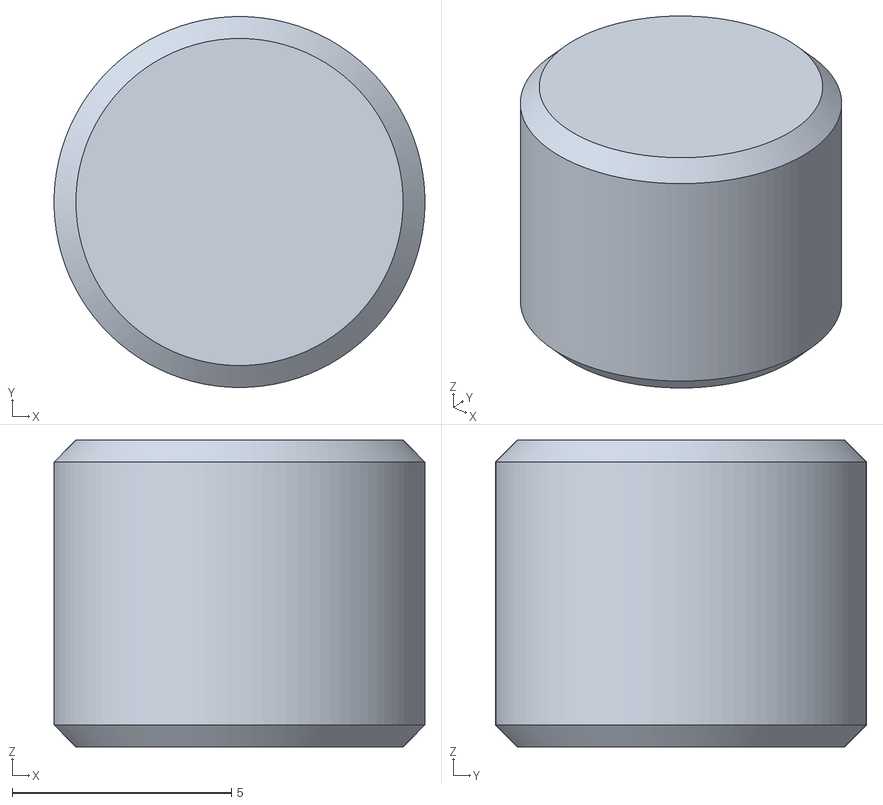
[picture p414: CAD file, 2022-11-04]
general/RunoutUnklicky/STLs/Roller.stl
8.46 x 8.46 x 7.00
