chirpy2605/voron/V0/5015_Toolhead/STLs/Dragonfly_mount.stl

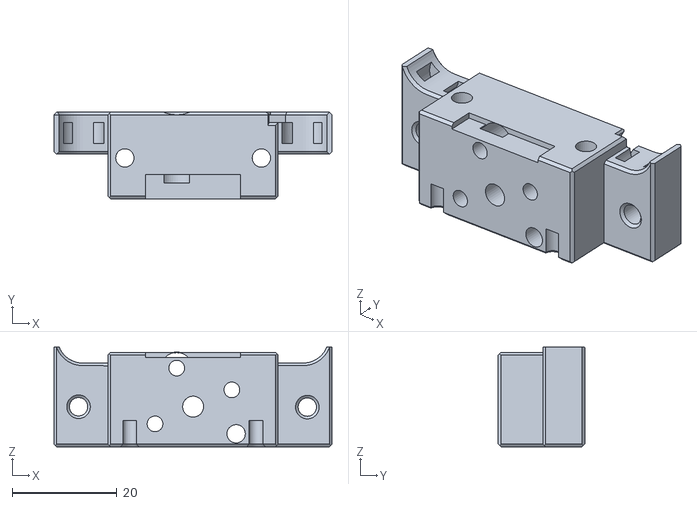
[picture p415: CAD file, 2022-11-15]
V0/5015_Toolhead/STLs/Dragonfly_mount.stl
53.0 x 16.5 x 19.0
