chirpy2605/voron/V0/Daylight_on_a_Matchstick/STLs/Cover_x2.stl

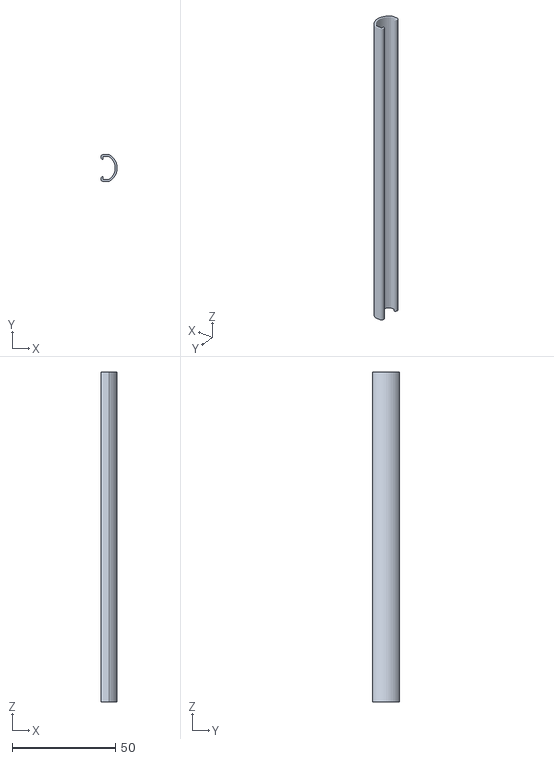
[picture p416: CAD file, 2022-11-04]
V0/Daylight_on_a_Matchstick/STLs/Cover_x2.stl
8.00 x 13.0 x 160.0
