chirpy2605/voron/(list of files, cad)

Other CAD files:
general/Experimental/Boop/CAD/Boop_Front.step
general/PCB_Mounts/STLs/Orbiter_v2/Orbiter_v2_Long_x2.stl
general/PCB_Mounts/STLs/WristWatch_BMG/WristWatch_BMG_Long_x2.stl
V0/Dragon_Burner/STLs/v0.2/Cowls/PFA/Cat_Cowls/Cowl_NoProbe.stl
V0/Dragon_Burner/STLs/v0.2/Cowls/SaladFork/Cat_Cowls/Cowl_NoProbe.stl
V0/Dragon_Burner/STLs/v0.2/Sherpa_Micro/Hotend_Mounts/Chube_Compact_Mount.stl
V0/Dragon_Burner/STLs/v0.2/Sherpa_Mini_pattern_mounts/Hotend_Mounts/Chube_Compact_Mount.stl
V0/Rapid_Burner/STLs/v0.2/PFA_Cowls/Cowl_NoProbe.stl
V0/Rapid_Burner/STLs/v0.2/SaladFork_Cowls/Cowl_Noprobe.stl
V0/Rapid_Burner/STLs/v0_2/Volcano/Cowl_KlickyNG.stl
V0/XCarriage_v0_2/STLs/X_Carriage_Inserts_v0.2.stl
general/Alternative_Voron_Mounts/Modified_Mounts/Boop/STLs/Boop_Spacer.stl
general/Alternative_Voron_Mounts/Modified_Mounts/Switchwire/STLs/DB_SW_Carriage_Left.stl
general/Duct_Testing/Overhang_Shuriken_Parametric.step
general/PCB_Mounts/STLs/G2SA/G2SA_Short_x2.stl
general/PCB_Mounts/STLs/LGX_Lite/LGX_Lite_Short_x2.stl
general/RoundTrip/ORB1/STLs/RearFeed/Guidler.stl
general/RoundTrip/ORB2/CAD/Roundtrip_ORB2_RF_v1.step
V0/Dragon_Burner/STLs/v0.2/Cowls/Micron/Cowl_NoProbe.stl
V0/Dragon_Burner/STLs/v0.2/Cowls/PFA/Cowl_NoProbe.stl
V0/Dragon_Burner/STLs/v0.2/Cowls/SaladFork/[c]_SaladFork_Diffuser.stl
V0/5015_Toolhead/STLs/Bowden_Mount.stl
V0/5015_Toolhead/STLs/Cowl_Klicky.stl
V0/5015_Toolhead/STLs/Cowl_MiniSlideSwipe.stl
V0/5015_Toolhead/STLs/Cowl_NoProbe.stl
V0/5015_Toolhead/STLs/Cowl_SlideSwipe.stl
V0/5015_Toolhead/STLs/Cowl_ZeroClick.stl
V0/5015_Toolhead/STLs/Dragon_mount.stl
V0/5015_Toolhead/STLs/Extruder_Mount.stl
V0/5015_Toolhead/STLs/Fan_Cover.stl
V0/5015_Toolhead/STLs/NF_Crazy_Mount.stl
V0/5015_Toolhead/STLs/RapidoHF_mount.stl
V0/5015_Toolhead/STLs/RevoVoron_Mount.stl
V0/Daylight_on_a_Matchstick/STLs/Mount_35_x4.stl
V0/Dragon_Burner/Old_Versions/v1/STLs/Dragon_Burner_ADXLMount.stl
V0/Dragon_Burner/Old_Versions/v1/STLs/Dragon_Burner_FanNubs.stl
V0/Dragon_Burner/Old_Versions/v1/STLs/Fan_Ducts/FanDuct_Left.stl
V0/Dragon_Burner/Old_Versions/v1/STLs/Fan_Ducts/FanDuct_Left_RapidoHF.stl
V0/Dragon_Burner/Old_Versions/v1/STLs/Fan_Ducts/FanDuct_Left_ZeroClick.stl
V0/Dragon_Burner/Old_Versions/v1/STLs/Fan_Ducts/FanDuct_Right_Klicky.stl
V0/Dragon_Burner/Old_Versions/v1/STLs/Fan_Ducts/FanDuct_Right_Klicky_RapidoHF.stl
V0/Dragon_Burner/Old_Versions/v1/STLs/Fan_Ducts/FanDuct_Right_NoProbe.stl
V0/Dragon_Burner/Old_Versions/v1/STLs/Fan_Ducts/FanDuct_Right_NoProbe_RapidoHF.stl
V0/Dragon_Burner/Old_Versions/v1/STLs/Fan_Ducts/FanDuct_Right_SlideSwipe.stl
V0/Dragon_Burner/Old_Versions/v1/STLs/Fan_Ducts/FanDuct_Right_SlideSwipe_RapidoHF.stl
V0/Dragon_Burner/Old_Versions/v1/STLs/LGX_Lite_mount.stl
V0/Dragon_Burner/Old_Versions/v1/STLs/Tests/RapidoHF_Long_Test.stl
V0/Dragon_Burner/Old_Versions/v1/STLs/Tests/RapidoHF_Short_Test.stl
V0/Dragon_Burner/Old_Versions/v1/STLs/Toolheads/Dragon.stl
V0/Dragon_Burner/Old_Versions/v1/STLs/Toolheads/Dragonfly.stl
V0/Dragon_Burner/Old_Versions/v1/STLs/Toolheads/RapidoHF.stl
V0/Dragon_Burner/Old_Versions/v1/STLs/Toolheads/RevoVoron.stl
V0/Dragon_Burner/Old_Versions/v2/STLs/Bowden_Mount.stl
V0/Dragon_Burner/Old_Versions/v2/STLs/Cowl_Klicky.stl
V0/Dragon_Burner/Old_Versions/v2/STLs/Cowl_NoProbe.stl
V0/Dragon_Burner/Old_Versions/v2/STLs/Cowl_SlideSwipe.stl
V0/Dragon_Burner/Old_Versions/v2/STLs/Cowl_ZeroClick.stl
V0/Dragon_Burner/Old_Versions/v2/STLs/Dragon_Mount.stl
V0/Dragon_Burner/Old_Versions/v2/STLs/Dragonfly_Mount.stl
V0/Dragon_Burner/Old_Versions/v2/STLs/LGX_Lite_Mount.stl
V0/Dragon_Burner/Old_Versions/v2/STLs/NF_Crazy_Mount.stl
V0/Dragon_Burner/Old_Versions/v2/STLs/NF_Crazy_Volcano/Cowl_SlideSwipe.stl
V0/Dragon_Burner/Old_Versions/v2/STLs/NF_Crazy_Volcano/NF_Crazy_Volcano_Mount.stl
V0/Dragon_Burner/Old_Versions/v2/STLs/Orbiter1.5/Dragon_Mount.stl
V0/Dragon_Burner/Old_Versions/v2/STLs/Orbiter1.5/Dragonfly_Mount.stl
V0/Dragon_Burner/Old_Versions/v2/STLs/Orbiter1.5/NF_Crazy_Mount.stl
V0/Dragon_Burner/Old_Versions/v2/STLs/Orbiter1.5/Orbiter1.5_Mount.stl
V0/Dragon_Burner/Old_Versions/v2/STLs/Orbiter1.5/RapidoHF_Mount.stl
V0/Dragon_Burner/Old_Versions/v2/STLs/Orbiter1.5/RevoVoron_Mount.stl
V0/Dragon_Burner/Old_Versions/v2/STLs/Orbiter2/Dragon_Mount.stl
V0/Dragon_Burner/Old_Versions/v2/STLs/Orbiter2/Dragonfly_Mount.stl
V0/Dragon_Burner/Old_Versions/v2/STLs/Orbiter2/NF_Crazy_Mount.stl
V0/Dragon_Burner/Old_Versions/v2/STLs/Orbiter2/Orbiter2_Mount.stl
V0/Dragon_Burner/Old_Versions/v2/STLs/Orbiter2/RapidoHF_Mount.stl
V0/Dragon_Burner/Old_Versions/v2/STLs/Orbiter2/RevoVoron_Mount.stl
V0/Dragon_Burner/Old_Versions/v2/STLs/RapidoHF_Mount.stl
V0/Dragon_Burner/Old_Versions/v2/STLs/RevoVoron_Mount.stl
V0/Dragon_Burner/Old_Versions/v2/STLs/Sherpa_Mini_Mount.stl
V0/Dragon_Burner/Old_Versions/v3/STLs/ADXL_Mount_Front.stl
V0/Dragon_Burner/Old_Versions/v3/STLs/Bowden_Mount.stl
V0/Dragon_Burner/Old_Versions/v3/STLs/Cowl_Klicky.stl
V0/Dragon_Burner/Old_Versions/v3/STLs/Cowl_NoProbe.stl
V0/Dragon_Burner/Old_Versions/v3/STLs/Cowl_SlideSwipe.stl
V0/Dragon_Burner/Old_Versions/v3/STLs/Cowl_ZeroClick.stl
V0/Dragon_Burner/Old_Versions/v3/STLs/Dragon_Mount.stl
V0/Dragon_Burner/Old_Versions/v3/STLs/Dragonfly_Mount.stl
V0/Dragon_Burner/Old_Versions/v3/STLs/LGX_Lite_Mount.stl
V0/Dragon_Burner/Old_Versions/v3/STLs/NF_Crazy_Mount.stl
V0/Dragon_Burner/Old_Versions/v3/STLs/Orbiter_v1.5/Dragon_Mount.stl
V0/Dragon_Burner/Old_Versions/v3/STLs/Orbiter_v1.5/Dragonfly_Mount.stl
V0/Dragon_Burner/Old_Versions/v3/STLs/Orbiter_v1.5/NF_Crazy_Mount.stl
V0/Dragon_Burner/Old_Versions/v3/STLs/Orbiter_v1.5/Orbiter1.5_Mount.stl
V0/Dragon_Burner/Old_Versions/v3/STLs/Orbiter_v1.5/RapidoHF_Mount.stl
V0/Dragon_Burner/Old_Versions/v3/STLs/Orbiter_v1.5/RevoVoron_Mount.stl
V0/Dragon_Burner/Old_Versions/v3/STLs/Orbiter_v2/Dragon_Mount.stl
V0/Dragon_Burner/Old_Versions/v3/STLs/Orbiter_v2/Dragonfly_Mount.stl
V0/Dragon_Burner/Old_Versions/v3/STLs/Orbiter_v2/NF_Crazy_Mount.stl
V0/Dragon_Burner/Old_Versions/v3/STLs/Orbiter_v2/Orbiter2_Mount.stl
V0/Dragon_Burner/Old_Versions/v3/STLs/Orbiter_v2/RapidoHF_Mount.stl
V0/Dragon_Burner/Old_Versions/v3/STLs/Orbiter_v2/RevoVoron_Mount.stl
V0/Dragon_Burner/Old_Versions/v3/STLs/RapidoHF_Mount.stl
V0/Dragon_Burner/Old_Versions/v3/STLs/RevoVoron_Mount.stl
V0/Dragon_Burner/Old_Versions/v3/STLs/Sherpa_Micro/Dragon_Mount.stl
V0/Dragon_Burner/Old_Versions/v3/STLs/Sherpa_Micro/Dragonfly_Mount.stl
V0/Dragon_Burner/Old_Versions/v3/STLs/Sherpa_Micro/NF_Crazy_Mount.stl
V0/Dragon_Burner/Old_Versions/v3/STLs/Sherpa_Micro/RapidoHF_Mount.stl
V0/Dragon_Burner/Old_Versions/v3/STLs/Sherpa_Micro/RevoVoron_Mount.stl
V0/Dragon_Burner/Old_Versions/v3/STLs/Sherpa_Micro/Sherpa_Micro_Mount.stl
V0/Dragon_Burner/Old_Versions/v3/STLs/ZeroClick_Mount.stl
V0/Dragon_Burner/Old_Versions/v4/STLs/v0.1/Bowden_Mount.stl
V0/Dragon_Burner/Old_Versions/v4/STLs/v0.1/Cowl_Klicky.stl
V0/Dragon_Burner/Old_Versions/v4/STLs/v0.1/Cowl_Klicky_Sequins.stl
V0/Dragon_Burner/Old_Versions/v4/STLs/v0.1/Cowl_NoProbe.stl
V0/Dragon_Burner/Old_Versions/v4/STLs/v0.1/Cowl_NoProbe_Sequins.stl
V0/Dragon_Burner/Old_Versions/v4/STLs/v0.1/Cowl_SlideSwipe.stl
V0/Dragon_Burner/Old_Versions/v4/STLs/v0.1/Cowl_SlideSwipe_Sequins.stl
V0/Dragon_Burner/Old_Versions/v4/STLs/v0.1/Cowl_ZeroClick.stl
V0/Dragon_Burner/Old_Versions/v4/STLs/v0.1/Cowl_ZeroClick_Sequins.stl
V0/Dragon_Burner/Old_Versions/v4/STLs/v0.1/Dragon_Mount.stl
V0/Dragon_Burner/Old_Versions/v4/STLs/v0.1/Dragonfly_Mount.stl
V0/Dragon_Burner/Old_Versions/v4/STLs/v0.1/LGX_Lite_Mount.stl
V0/Dragon_Burner/Old_Versions/v4/STLs/v0.1/NF_Crazy_Mount.stl
V0/Dragon_Burner/Old_Versions/v4/STLs/v0.1/Orbiter_v1.5/Dragon_Mount.stl
V0/Dragon_Burner/Old_Versions/v4/STLs/v0.1/Orbiter_v1.5/Dragonfly_Mount.stl
V0/Dragon_Burner/Old_Versions/v4/STLs/v0.1/Orbiter_v1.5/NF_Crazy_Mount.stl
V0/Dragon_Burner/Old_Versions/v4/STLs/v0.1/Orbiter_v1.5/Orbiter1.5_Mount.stl
V0/Dragon_Burner/Old_Versions/v4/STLs/v0.1/Orbiter_v1.5/RapidoHF_Mount.stl
V0/Dragon_Burner/Old_Versions/v4/STLs/v0.1/Orbiter_v1.5/RevoVoron_Mount.stl
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
