chirpy2605/voron/general/Experimental/Boop/README.md

These parts have moved to [Alternative Voron Mounts](../../Alternative_Voron_Mounts).
