chirpy2605/voron/general/Experimental/README.md

# Here Be Dragons!

Enter at your peril!
