chirpy2605/voron/V0/Dragon_Burner/Old_Versions/v1/STLs/Tests/README.md

These are test builds and not part of the main release
