chirpy2605/voron/(commit log)

2022-11-06 Updated LED Cover STLs for sizing
    [[c]_LED_Cover_Left.stl, [c]_LED_Cover_Right.stl]
2022-11-08 new chimney ducts
    [Chimney.stl, Chimney_Slim.stl, Duct_Chimney.stl, Duct_Chimney_Slim.stl, Duct_Chimney_Slim_UHF.stl, Duct_Chimney_UHF.stl]
2022-11-09 Chimney duct improvements
    [Chimney.stl]
2022-11-11 One off Rapid Burner Slim
    [Cowl.stl, Orbiter1.5_Mount.stl]
2022-11-11 Updated ZeroClick mount
    [ZeroClick_Mount.stl]
2022-11-11 Updated ZeroClick mount (again)
    [ZeroClick_Mount.stl]
2022-11-14 Added new Chimney Duct for Sherpa Mini / Orbiter v1.5
    [Chimney_Square.stl]
2022-11-15 Updated UHF mount
    [Hotend_Mounts_UHF.stl]
2022-11-15 Updated Dragonfly mount
    [Dragonfly_mount.stl]
2022-11-15 Updated square chimney duct
    [Chimney_Square.stl]
2022-11-17 Updated chimney duct and zeroclick mount
    [Chimney_Square.stl, ZeroClick_Mount.stl, [c]_LED_Cover_Left.stl]
2022-11-19 Fixed CAD STEP file
2022-11-20 Updated CAD
    [NozzleWiper.step, NozzleWiper_v2.step]
2022-11-24 New ADXL_Mount
    [ADXL_Mount.stl]
2022-11-24 Updated ZeroClick cowl
    [Cowl_ZeroClick.stl]
2022-11-26 Improved ZeroClick mount
    [ZeroClick_Mount.stl]
2022-11-26 Improved 4010 fan support
    [Cowl_Klicky.stl, Cowl_NoProbe.stl, Cowl_SlideSwipe.stl, Cowl_ZeroClick.stl]
2022-11-29 Geometry fixes for hotend mounts
    [Dragon_Mount.stl, Dragonfly_Mount.stl, NF_Crazy_Mount.stl, RapidoHF_Mount.stl, RevoVoron_Mount.stl, Sherpa_Mini_Mount.stl]
2022-11-29 Fixed hotend mount geometry
    [Standard_Mount.stl]
2022-11-29 Updated ZeroClick Cowl and Mount
    [Cowl_ZeroClick.stl, ZeroClick_Mount.stl]
2022-11-29 Fixed STL orientation
    [Cowl_ZeroClick.stl, ZeroClick_Mount.stl]
2022-12-13 Dragon Burner v3 release
    [ADXL_Mount.stl, Bowden_Mount.stl, Cowl_Klicky.stl, Cowl_NoProbe.stl, Cowl_SlideSwipe.stl, Cowl_ZeroClick.stl, Dragon.stl, Dragon_Burner_ADXLMount.stl]
2022-12-13 Rapid Burner v3 release
    [ADXL_Mount.stl, Bowden_Mount.stl, Cowl.stl, Cowl_Klicky.stl, Cowl_MiniSlideSwipe.stl, Cowl_NoProbe.stl, Cowl_SlideSwipe.stl, Cowl_ZeroClick.stl]
2022-12-19 StovePipe v1 Release
    [Cowl_Klicky.stl, Cowl_MiniSlideSwipe.stl, Cowl_NoProbe.stl, Cowl_SlideSwipe.stl, Cowl_UHF_Klicky.stl, Cowl_UHF_MiniSlideSwipe.stl, Cowl_UHF_NoProbe.stl, Cowl_UHF_SlideSwipe.stl]
2022-12-20 Added Dragon Volcano mounts and cowls
    [Cowl_Klicky.stl, Cowl_NoProbe.stl, Cowl_SlideSwipe.stl, Cowl_ZeroClick.stl, Orbiter1.5_Mount.stl, Orbiter2_Mount.stl, Sherpa_Micro_Mount.stl, Standard_Mount.stl]
2022-12-28 Improved ADXL mount and a KUSBA mount
    [ADXL_Mount.stl, KUSBA_Mount.stl]
2022-12-28 Added improved ADXL mounts
    [ADXL_Mount.stl, ADXL_Mount_Front.stl, ADXL_Mount_Side.stl]
2022-12-28 Fixed ADXL front mount STL orientation
    [ADXL_Mount_Front.stl]
2023-01-10 Dragon Burner for v0.2
    [Bowden_Mount.stl, Cowl_Klicky.stl, Cowl_NoProbe.stl, Cowl_SlideSwipe.stl, Cowl_ZeroClick.stl, Dragon_Mount.stl, Dragonfly_Mount.stl, LGX_Lite_Mount.stl]
2023-01-17 Mailbox v5 Release
    [ADXL_Mount.stl, Bowden_Mount.stl, Cowl_Klicky.stl, Cowl_MiniSlideSwipe.stl, Cowl_NoProbe.stl, Cowl_RapidoUHF_Klicky.stl, Cowl_SlideSwipe.stl, Cowl_ZeroClick.stl]
2023-01-17 v0.2 X Carriage
    [X_Carriage_Inserts.step, X_Carriage_Inserts_v0.2.stl]
2023-01-17 Updated directories and added CAD
    [ADXL_Mount.stl, Bowden_Mount.stl, Cowl_Klicky.stl, Cowl_MiniSlideSwipe.stl, Cowl_NoProbe.stl, Cowl_NoProbe_NFCrazy.stl, Cowl_RapidoUHF.stl, Cowl_RapidoUHF_Klicky.stl]
2023-01-17 Moved 5015_Toolhead to Mailbox
    [ADXL_Mount.stl, Bowden_Mount.stl, Cowl_Klicky.stl, Cowl_MiniSlideSwipe.stl, Cowl_NoProbe.stl, Cowl_NoProbe_NFCrazy.stl, Cowl_RapidoUHF.stl, Cowl_RapidoUHF_Klicky.stl]
2023-01-18 various updates
    [ADXL_Mount.stl, NF_Crazy_Mount.stl, [c]_LED_Cover_Left.stl]
2023-01-19 Dragon Burner v4
    [ADXL_Mount.stl, ADXL_Mount_Front.stl, ADXL_Mount_Side.stl, Bowden_Mount.stl, Cowl_Klicky.stl, Cowl_NoProbe.stl, Cowl_SlideSwipe.stl, Cowl_ZeroClick.stl]
2023-01-19 Dragon Burner v4 CAD
2023-01-19 Fixed Rapido/Dragon v0.2 mounts
    [RapidoHF_Mount.stl, RevoVoron_Mount.stl]
2023-01-21 Rapid Burner v5 release
    [ADXL_Mount_Front.stl, ADXL_Mount_Side.stl, Bowden_Mount.stl, Cowl_Klicky.stl, Cowl_NoProbe.stl, Cowl_SlideSwipe.stl, Cowl_ZeroClick.stl, LGX_Lite_Mount.stl]
2023-01-21 Revert "Rapid Burner v5 release"
    This reverts commit 464ab4c273727ef18d51f02da93c11356c3c506b.
    [ADXL_Mount_Front.stl, ADXL_Mount_Side.stl, Bowden_Mount.stl, Cowl_Klicky.stl, Cowl_NoProbe.stl, Cowl_SlideSwipe.stl, Cowl_ZeroClick.stl, LGX_Lite_Mount.stl]
2023-01-21 Revert "Revert "Rapid Burner v5 release""
    This reverts commit f5a7442fba5346fafa69706cab9a3203261bb79c.
    [ADXL_Mount_Front.stl, ADXL_Mount_Side.stl, Bowden_Mount.stl, Cowl_Klicky.stl, Cowl_NoProbe.stl, Cowl_SlideSwipe.stl, Cowl_ZeroClick.stl, LGX_Lite_Mount.stl]
2023-01-27 Roundtrip extruder
    [Back.stl, Front.stl, Guidler.stl, PCB_Mount.stl]
2023-01-29 Fixed mainbody/nozzle alignment
    [Cowl_Klicky.stl, Cowl_NoProbe.stl, Cowl_SlideSwipe.stl, Cowl_ZeroClick.stl]
2023-01-29 Rapid Burner cowl changes for v0.2
    [Cowl_Klicky.stl, Cowl_NoProbe.stl, Cowl_SlideSwipe.stl, Cowl_ZeroClick.stl, Orbiter1.5_Mount.stl, Orbiter2_Mount.stl, Sherpa_Micro_Mount.stl, Standard_Mount.stl]
2023-01-31 Updated cowls and hotend mounts
    [Cowl_Klicky.stl, Cowl_NoProbe.stl, Cowl_SlideSwipe.stl, Cowl_ZeroClick.stl, Dragon_Mount.stl, Dragonfly_Mount.stl, NF_Crazy_Mount.stl, RapidoHF_Mount.stl]
2023-01-31 Mailbox cowl geometry improvements
    [Cowl_Klicky.stl, Cowl_MiniSlideSwipe.stl, Cowl_NoProbe.stl, Cowl_SlideSwipe.stl, Cowl_ZeroClick.stl]
2023-02-03 Geometry and cowl stability changes
    [Cowl_Klicky.stl, Cowl_MiniSlideSwipe.stl, Cowl_NoProbe.stl, Cowl_SlideSwipe.stl, Cowl_ZeroClick.stl, Dragon_Mount.stl, Dragonfly_Mount.stl, NF_Crazy_Mount.stl]
2023-02-04 Roundtrip WIP release for LGX Lite gears
    [Back.stl, Board Mount.stl, Front.stl, Guidler.stl, PCB_Mount.stl]
2023-02-04 wrong STLs
    [Back.stl, Board Mount.stl, Front.stl, Guidler.stl]
2023-02-04 RoundTrip LGX STLs
    [Back.stl, Front.stl, Guidler.stl, Toolhead_Board_Mount.stl]
2023-02-07 RoundTrip STL update
    [ADXL_Mount_Front.stl, Back.stl, Front.stl]
2023-02-09 Experimental Neopixel support added
    Experimental Neopixel support added. Updated v0.2 extruder mounts to meet closer to the x carriage rear screw mount.
    [Bowden_Mount.stl, Cowl_Klicky.stl, Cowl_NoProbe.stl, Cowl_SlideSwipe.stl, Cowl_ZeroClick.stl, LGX_Lite_Mount.stl, Orbiter1.5_Mount.stl, Orbiter2_Mount.stl]
2023-02-14 Fixed orientation
    [[t]_LED_Holder.stl]
2023-02-23 Added missing heat insert hole
    [Orbiter2_Mount.stl]
2023-02-23 Neopixel and cable channel changes
    [Bowden_Mount.stl, Cowl_Klicky.stl, Cowl_NoProbe.stl, Cowl_SlideSwipe.stl, Cowl_ZeroClick.stl, Dragon_Mount.stl, Dragonfly_Mount.stl, LGX_Lite_Mount.stl]
2023-02-23 Added sequins to cowls
    [Cowl_Klicky_Sequins.stl, Cowl_NoProbe_Sequins.stl, Cowl_SlideSwipe_Sequins.stl, Cowl_ZeroClick_Sequins.stl]
2023-02-23 Restored cable route for sequins
    [Cowl_Klicky_Sequins.stl, Cowl_NoProbe_Sequins.stl, Cowl_SlideSwipe_Sequins.stl, Cowl_ZeroClick_Sequins.stl]
2023-02-24 v0.2 mods
    [DIN_Rail_Mount_x2.step, DIN_Rail_Mount_x2.stl, Gap_Seal.step, Gap_Seal_Left_x2.stl, Gap_Seal_Right_x2.stl, MGN9C_X_Carriage_Inserts.step, MGN9C_X_Carriage_Inserts.stl, Rear_Panel_Hex_Mesh.stl]
2023-02-24 Tophat Cat Flap
    [Door Handle Short.stl, Door Latch.stl, Lower Left Clip.stl, Lower Right Hinge.stl, Lower Right Side Hinge.stl, Top Panel Clip.stl, Upper Left Panel Clip.stl, Upper Right Hinge.stl]
2023-02-26 New Cable Channels and LED's
    [Cowl_Klicky.stl, Cowl_Klicky_Sequins.stl, Cowl_NoProbe.stl, Cowl_NoProbe_Sequins.stl, Cowl_SlideSwipe.stl, Cowl_SlideSwipe_Sequins.stl, Cowl_ZeroClick.stl, Cowl_ZeroClick_Sequins.stl]
2023-02-27 Extruder mounts now flush with x-carriage
    [Bowden_Mount.stl, Extruder_Mount.stl, Orbiter_v1_5_Mount.stl]
2023-02-27 Improved frame mount and silicone brush support
    [nozzlewiper.cfg]
2023-03-01 Door Handle with more magnets
    [Door Handle_Main.stl, Door Handle_Tophat.stl, Door_Handle_More_Magnets.step]
2023-03-01 Updated RoundTrip (TBG)
    [Back.stl, Board Mount.stl, Front.stl, Guidler.stl, PCB_Mount.stl]
2023-03-04 pi camera 3 mount
    [picamera3.step, picamera3stl.stl]
2023-03-04 moved to CAD
    [picamera3.step]
2023-03-06 Fixed picam v3 mount interfering with the toolhead
    [picamera3.step, picamera3stl.stl]
2023-03-07 Added front-mounting ADXL mount plate
    [ADXL_Mount_Front.stl]
2023-03-08 Full release of the RoundTrip (LGX+TBG)
    [Back.stl, Front.stl, Guidler.stl, PCB_Mount.stl, Roundtrip_LGX_v1.step, Roundtrip_TBG_v1.step, Toolhead_Board_Mount.stl]
2023-03-11 Updated Z Cover
    [[a]_Z_Cover.step, [a]_Z_Cover.stl]
2023-03-12 Lift-Off Tophat Hinges
    [Hinge_Bottom_Left.stl, Hinge_Bottom_Right.stl, Hinge_Top_Left.stl, Hinge_Top_Right.stl]
2023-03-13 Updated Roundtrip TBG+LGX
    [Back.stl, Front.stl, Guidler.stl, Roundtrip_LGX_v1.step, Roundtrip_TBG_v1.step]
2023-03-14 Fixed orientation and geometry
    [Top Panel Clip.stl]
2023-03-14 New hinges
    [Hinge_Bottom_Left.stl, Hinge_Bottom_Right.stl, Hinge_Top_Left.stl, Hinge_Top_Right.stl]
2023-03-20 Dragon Burner v5 Release
    [ADXL_Mount_Front.stl, Bowden_Mount.stl, Cowl_Klicky.stl, Cowl_Klicky_Sequins.stl, Cowl_NoProbe.stl, Cowl_NoProbe_Sequins.stl, Cowl_SlideSwipe.stl, Cowl_SlideSwipe_Sequins.stl]
2023-03-20 old cad
2023-03-20 Moved old versions into separate folder
    [ADXL_Mount.stl, ADXL_Mount_Front.stl, ADXL_Mount_Side.stl, Bowden_Mount.stl, Cowl_Klicky.stl, Cowl_Klicky_Sequins.stl, Cowl_NoProbe.stl, Cowl_NoProbe_Sequins.stl]
2023-03-22 Fixed part orientation
    [ADXL_Mount_Front.stl]
2023-03-23 LED STLs
    [[a]_Carrier_Dummy.stl, [c]_Diffuser.stl, [o]_Carrier_Neopixel.stl, [o]_Carrier_RainbowBarf.stl, [o]_Carrier_Sequin.stl]
2023-03-28 New Roundtrip Extruder Variants
    [Back.stl, Front.stl, Guidler.stl, PCB_Mount.stl, Roundtrip_ORB1_FF_v1.step, Roundtrip_ORB1_RF_v1.step, Roundtrip_ORB2_FF_v1.step, Roundtrip_ORB2_RF_v1.step]
2023-04-02 Modified cowl to use nozzle LED holders
    [Cowl_Klicky.stl, Cowl_Klicky_Sequins.stl, Cowl_NoProbe.stl, Cowl_NoProbe_Sequins.stl, Cowl_SlideSwipe.stl, Cowl_SlideSwipe_Sequins.stl, Cowl_ZeroClick.stl, Cowl_ZeroClick_Sequins.stl]
2023-04-04 split dummy led carrier to carrier+diffuser
    [[a]_Carrier_Dummy.stl]
2023-04-05 Alternative MG90S parts
    [Servo_Arm_MG90S_Wide.stl, Servo_Mount_MG90_M2_Screws.stl]
2023-04-29 Dragon Burner v6
    [2510_Spacer.stl, ADXL_Mount_Front.stl, Bowden_Mount.stl, Cowl_Klicky.stl, Cowl_Klicky_Sequins.stl, Cowl_NoProbe.stl, Cowl_NoProbe_Sequins.stl, Cowl_SlideSwipe.stl]
2023-04-29 Rapid Burner v6
    [2510_Spacer.stl, ADXL_Mount_Front.stl, ADXL_Mount_Front_Goliath.stl, Bowden_Extruder_Mount.stl, Cowl_Klicky.stl, Cowl_Klicky_Air.stl, Cowl_Klicky_Water.stl, Cowl_NoProbe.stl]
2023-05-01 Fixed object sizing
    [[o]_Carrier_Sequin_RGB.stl]
2023-05-09 Goliath Air / Water updates
    [ADXL_Mount_Front_Goliath.stl, Cowl_Klicky_Air.stl, Cowl_Klicky_Water.stl, Cowl_NoProbe_Air.stl, Cowl_NoProbe_Water.stl, Cowl_SlideSwipe_Air.stl, Cowl_SlideSwipe_Water.stl, Cowl_ZeroKlick_Air.stl]
2023-05-09 New CAD released
2023-05-15 Fixed geometry
    [[a]_Z_Cover.step, [a]_Z_Cover.stl]
2023-05-15 Geometry fixes
    [[a]_Z_Cover.step, [a]_Z_Cover.stl]
2023-05-20 Cowl updates and improvements
    This update is for new prints, existing installations won't gain anything much from this
    [Cowl_Klicky.stl, Cowl_Klicky_Sequins.stl, Cowl_NoProbe.stl, Cowl_NoProbe_Sequins.stl, Cowl_SlideSwipe.stl, Cowl_SlideSwipe_Sequins.stl, Cowl_ZeroClick.stl, Cowl_ZeroClick_Sequins.stl]
2023-05-25 Experimental stuff
    [Boop_Spacer.stl, LGX_Lite_Mount.stl, LGX_Mount.stl, MGN12_X_Carriage.stl, Main_Spacer.stl, Orbiter1.5_Mount.stl, Orbiter2_Mount.stl, Probe_Bracket.stl]
2023-05-26 Double Folded Ascender mounts added
    [DFA_Mount.stl, Dragon_Mount.stl, Dragonfly_Mount.stl, NF_Crazy_Mount.stl, RapidoHF_Mount.stl, RevoVoron_Mount.stl, SpiderPro_Mount.stl]
2023-05-26 Added Double Folded Ascender Mounts
    [DFA_Mount.stl, Rapid_Burner_v0.2_v6 v41.step]
2023-06-01 Added Tap front plate option
    [MGN12_X_Carriage.stl, Tap_Front.stl]
2023-06-03 Updated Tap Front
    [Tap_Front.stl]
2023-06-04 Release of Large Voron Mounts
    [LGX_Lite_Mount.stl, LGX_Mount.stl, MGN12_X_Carriage.stl, Main_Spacer.stl, Orbiter1.5_Mount.stl, Orbiter2_Mount.stl, Probe_Bracket.stl, Probe_Support.stl]
2023-06-04 boop bits
    [boop_front.stl]
2023-06-06 Euclid Mount
    [MGN12_X_Carriage_Euclid.stl]
2023-06-06 Boop release for Dragon and Rapid Burner
    [Boop_Spacer.stl, boop_front.stl]
2023-06-09 Klicky Integrated and KlckyNG support
    [Cowl_KlickyNG.stl, Cowl_KlickyNG_Sequins.stl, Cowl_Klicky_Integrated.stl, Cowl_Klicky_Integrated_Sequins.stl]
2023-06-09 Integrated Klicky and KlickyNG cowls
    [Cowl_KlickyNG.stl, Cowl_KlickyNG_Air.stl, Cowl_KlickyNG_Water.stl, Cowl_Klicky_Integrated.stl, Cowl_Klicky_Integrated_Air.stl, Cowl_Klicky_Integrated_Water.stl]
2023-06-30 Dragon Burner v7 BETA
    [ADXL_Mount_Front.stl, Bambu_Mount.stl, Bowden_Mount.stl, Cowl_Klicky.stl, Cowl_KlickyNG.stl, Cowl_NoProbe.stl, Cowl_SlideSwipe.stl, Cowl_ZeroClick.stl]
2023-06-30 Switchwire Mount
    [DB_SW_Carriage_Left.stl, DB_SW_Carriage_Right.stl]
2023-06-30 Added Legacy Mount
    [DB_VL_Carriage_Left.stl, DB_VL_Carriage_Right.stl]
2023-07-01 Rapid Burner v7 BETA
    [ADXL_Mount_Front.stl, Bowden_Extruder_Mount.stl, Cowl_Klick_Integrated.stl, Cowl_KlickyNG.stl, Cowl_NoProbe.stl, Cowl_SlideSwipe.stl, Cowl_ZeroClick.stl, DFA_Extruder_Mount.stl]
2023-07-02 Added integrated ZeroClick cowl
    [Cowl_ZeroClick_Integrated.stl]
2023-07-02 CW2 Adapter Plate
    [CW2_Adapter_Plate.stl]
2023-07-03 Updated Cowls
    [Cowl_Klicky.stl, Cowl_KlickyNG.stl, Cowl_NoProbe.stl, Cowl_SlideSwipe.stl, Cowl_ZeroClick.stl, Cowl_ZeroClick_Integrated.stl, ZeroClick_Mount.stl]
2023-07-04 Updated cowl
    [Cowl_Klick_Integrated.stl, Cowl_KlickyNG.stl, Cowl_NoProbe.stl, Cowl_SlideSwipe.stl, Cowl_ZeroClick_Integrated.stl]
2023-07-07 Dragon Burner v7 BETA updates
    [Bambu_Mount.stl, Cowl_Klicky.stl, Cowl_KlickyNG.stl, Cowl_NoProbe.stl, Cowl_SlideSwipe.stl, Cowl_ZeroClick_Integrated.stl, HE_Fan Mount_Neopixel.stl, HE_Fan Mount_Sequin.stl]
2023-07-08 Rapid Bruner v7 BETA updates
    [Cowl_Klick_Integrated.stl, Cowl_KlickyNG.stl, Cowl_NoProbe.stl, Cowl_SlideSwipe.stl, Cowl_ZeroClick_Integrated.stl, HE_Fan Mount_Neopixel.stl, HE_Fan Mount_Sequin.stl]
2023-07-08 Dragon and Rapid Burner v7 release
    [2510_Spacer.stl, ADXL_Mount_Front.stl, ADXL_Mount_Front_Goliath.stl, Bambu_Mount.stl, Bowden_Extruder_Mount.stl, Bowden_Mount.stl, Cowl_Klick_Integrated.stl, Cowl_Klicky.stl]
2023-07-11 Fixed mount geometry
    [Bambu_Mount.stl, Dragon_Mount.stl, Dragonfly_Mount.stl, NF_Crazy_Mount.stl, RapidoHF_Mount.stl, RevoVoron_Mount.stl, SpiderPro_Mount.stl, TaiChi_Mount_Front.stl]
2023-07-11 Fixed part name
    [Cowl_Klicky_Integrated.stl, DFA_Hotend_Mount.stl]
2023-07-12 Updated CAD and README
2023-07-13 Added DBv7 Extended Mounts
    [Bowden_Extruder_Mount.stl, DFA_Extruder_Mount.stl, DFA_Mount.stl, LGX_Lite_Mount.stl, LGX_Mount.stl, Orbiter1.5_Extruder_Mount.stl, Orbiter1.5_Mount.stl, Orbiter2_Extruder_Mount.stl]
2023-07-23 Large Voron Mounts CAD
2023-07-23 Boop Front CAD
    [Boop_Front.step]
2023-07-26 RoundTrip v2 release
    [Back.stl, Front.stl, Guidler.stl]
2023-07-31 Rapid Burner Goliath v7 Beta
    [ADXL_Mount_Front_Goliath.stl, Cowl_Goliath_Air_Klicky.stl, Cowl_Goliath_Air_KlickyNG.stl, Cowl_Goliath_Air_NoProbe.stl, Cowl_Goliath_Air_SlideSwipe.stl, Cowl_Goliath_Air_ZeroClick.stl, Cowl_Goliath_Water_KlickNG.stl, Cowl_Goliath_Water_Klicky.stl]
2023-08-01 Fixed slicer size
    [[c]_Diffuser.stl, [o]_Carrier_RainbowBarf.stl, [o]_Carrier_Sequin.stl, [o]_Carrier_Sequin_RGB.stl]
2023-08-01 PCB Mounts BETA release
    [LGX_Lite_Long_x2.stl, LGX_Lite_Short_x2.stl, Orbiter_v1.5_Long_x2.stl, Orbiter_v1.5_Short_x2.stl, Orbiter_v2_Long_x2.stl, PCB_Carrier.stl, RoundTrip_OB1Reverse_Long_x2.stl, RoundTrip_OB1Reverse_Short_x2.stl]
2023-08-01 PCB Mounts BETA
2023-08-01 PCB Mounts removed
    [LGX_Lite_Long_x2.stl, LGX_Lite_Short_x2.stl, Orbiter_v1.5_Long_x2.stl, Orbiter_v1.5_Short_x2.stl, Orbiter_v2_Long_x2.stl, PCB_Carrier.stl, RoundTrip_OB1Reverse_Long_x2.stl, RoundTrip_OB1Reverse_Short_x2.stl]
2023-08-02 PCB Mounts (BETA)
    [Hextrudort_Carrier.stl, Hextrudort_Long_x2.stl, LGX_Lite_Carrier.stl, LGX_Lite_Long_x2.stl, LGX_Lite_Short_x2.stl, Orbiter_1.5_Carrier.stl, Orbiter_v1.5_Long_x2.stl, Orbiter_v1.5_Short_x2.stl]
2023-08-04 Rapid Burner PCB Mounts
    [Hextrudort_Carrier_DB_36.stl, Hextrudort_Carrier_RB_36.stl, LGX_Lite_Carrier_DB_36.stl, LGX_Lite_Carrier_RB_36.stl, Orbiter_1.5_Carrier_DB_36.stl, Orbiter_1.5_Carrier_RB_36.stl, Orbiter_v2_Carrier.stl, Orbiter_v2_Carrier_DB_36.stl]
2023-08-06 Goliath Toolhead updates and out of BETA
    [ADXL_Mount_Front_Goliath.stl, Cowl_Goliath_Air_Klicky.stl, Cowl_Goliath_Air_KlickyNG.stl, Cowl_Goliath_Air_NoProbe.stl, Cowl_Goliath_Air_SlideSwipe.stl, Cowl_Goliath_Air_ZeroClick.stl, Cowl_Goliath_Water_KlickNG.stl, Cowl_Goliath_Water_Klicky.stl]
2023-08-08 Added chamfer and counter sink to lower screw holes
    [Hextrudort_Carrier_DB_36.stl, Hextrudort_Carrier_RB_36.stl, LGX_Lite_Carrier_DB_36.stl, LGX_Lite_Carrier_RB_36.stl, Orbiter_1.5_Carrier_DB_36.stl, Orbiter_1.5_Carrier_RB_36.stl, Orbiter_v2_Carrier_DB_36.stl, Orbiter_v2_Carrier_RB_36.stl]
2023-08-09 Updated extruder and tap front mounts
    [Bowden_Extruder_Mount.stl, LGX_Lite_Mount.stl, LGX_Mount.stl, Orbiter1.5_Extruder_Mount.stl, Orbiter2_Extruder_Mount.stl, Sherpa_Micro_Extruder_Mount.stl, Sherpa_Mini_Extruder_Mount.stl, Tap_Front.stl]
2023-08-10 Cat Cowl
    [Cowl_Cat.step, Cowl_Cat.stl]
2023-08-19 Rainbow Dragon release
    [Back_Mount.stl, Front_Mount_Plate.stl, Latch.stl, PCB_Mount.stl, TaiChi_Mount_Rear.stl]
2023-08-22 PCB_Mount CAD
2023-08-22 PCB Mounts link added
2023-08-28 Added Sharkfin Mount
    [Sharkfin_DB_36.stl, Sharkfin_Long_x2.stl, Sharkfin_RB_36.stl]
2023-08-29 Fixed various extruder hotend mounts
    [Orbiter1.5_Mount.stl, Orbiter2_Mount.stl, Sherpa_Micro_Mount.stl]
2023-08-30 Additional Cat Cowl variants
    [Cowl_Cat.step, Cowl_Klicky.stl, Cowl_KlickyNG.stl, Cowl_NoProbe.stl, Cowl_SlideSwipe.stl, Cowl_ZeroClick.stl]
2023-09-08 Updated Sherpa Mini mounts
    [Sherpa_Mini_Carrier_DB_36.stl, Sherpa_Mini_Carrier_RB_36.stl]
2023-09-13 Updated Goliath hotend mounts
    [Orbiter1.5_Mount.stl, Orbiter2_Mount.stl, Sherpa_Micro_Mount.stl, Sherpa_Mini_Mount.stl]
2023-09-22 G2SA PCB Mounts
    [G2SA_Carrier_DB_36.stl, G2SA_Carrier_RB_36.stl, G2SA_Long_x2.stl, G2SA_Short_x2.stl]
2023-09-25 Curse removed
    [[a]_Z_Cover.stl]
2023-09-26 Latest Roundtrip LGX CAD
    [Roundtrip_LGX_v1.step, Roundtrip_LGX_v2.step]
2023-10-05 Fixed Sharkfin RB mount
    [Sharkfin_RB_36.stl]
2023-10-18 Added rear duct heat inserts to NoProbe cowls
    [Cowl_Goliath_Air_NoProbe.stl, Cowl_Goliath_Water_NoProbe.stl, Cowl_NoProbe.stl]
2023-10-18 Updated ADXL mount
    [ADXL_Mount_Front.stl, KUSBA_Mount.stl]
2023-10-29 Added heat inserts to the rear of most ducts (Not ZeroClick)
    [Cowl_Goliath_Air_Klicky.stl, Cowl_Goliath_Air_KlickyNG.stl, Cowl_Goliath_Air_NoProbe.stl, Cowl_Goliath_Air_SlideSwipe.stl, Cowl_Goliath_Water_KlickNG.stl, Cowl_Goliath_Water_Klicky.stl, Cowl_Goliath_Water_NoProbe.stl, Cowl_Goliath_Water_SlideSwipe.stl]
2023-10-31 Extended Hextrudort mount holes
    [Hextrudort_Carrier_DB_36.stl, Hextrudort_Carrier_RB_36.stl]
2023-10-31 Added Wristwatch mount
    [WristWatch_Mount.stl]
2023-10-31 WristWatch BMG and G2 mounts
    [WristWatch_BMG_Mount.stl, WristWatch_G2_Mount.stl]
2023-11-01 Fixed the cats lugholes
    [Cowl_Klicky.stl, Cowl_KlickyNG.stl, Cowl_NoProbe.stl, Cowl_SlideSwipe.stl, Cowl_ZeroClick.stl]
2023-11-02 Fixed print orientation
    [Dragonfly_Mount.stl, G2SA_Long_x2.stl, G2SA_Short_x2.stl, NF_Crazy_Mount.stl, RapidoHF_Mount.stl, RevoVoron_Mount.stl, SpiderPro_Mount.stl, V6_Mount_Back.stl]
2023-11-04 Updated WWG2 mount
    [WristWatch_G2_Mount.stl]
2023-11-08 Improved printability of the hotend mounts
    [Bambu_Mount.stl, Dragon_Ace_HF_Mount.stl, Dragon_Mount.stl, Dragonfly_BMS_7fin.stl, Dragonfly_Mount.stl, G2SA_Orbiter_Mount.stl, NF_Crazy_Mount.stl, RapidoHF_Mount.stl]
2023-11-08 Added support and mounts for the Dragon Ace HF
2023-11-10 Micron Cowl
    [Cowl_NoProbe_Micron.stl, [c]_Micron_Diffuser.stl]
2023-11-12 Updated v0 Z Cover to use 10mm screws
    [Beacon_Probe_Mount.stl, Boop_Front.step, Boop_Front.stl, Boop_Front_Extended.stl, Boop_Spacer.stl, Bowden_Extruder_Mount.stl, CW2_Adapter_Plate.stl, Carriage_Base.stl]
2023-11-12 Revert "Updated v0 Z Cover to use 10mm screws"
    This reverts commit cae79f1391e0156da1ee36908bfbf37ee5628ec9.
    [Beacon_Probe_Mount.stl, Boop_Front.step, Boop_Front.stl, Boop_Front_Extended.stl, Boop_Spacer.stl, Bowden_Extruder_Mount.stl, CW2_Adapter_Plate.stl, Carriage_Base.stl]
2023-11-13 Updated Bambu hotend mounts
    [Bambu_Mount.stl]
2023-11-17 Another Bambu Labs mount update
    [Bambu_Mount.stl]
2023-11-18 BETA Release of Alternative Voron Mounts
    [Beacon_Probe_Mount.stl, Boop_Front.stl, Boop_Front_Extended.stl, Boop_Spacer.stl, Bowden_Extruder_Mount.stl, CW2_Adapter_Plate.stl, Carriage_Base.stl, Carriage_Base_EndStop_Long.stl]
2023-11-18 Moved to Alternative_Voron_Mounts
    [Bowden_Extruder_Mount.stl, CW2_Adapter_Plate.stl, DB_SW_Carriage_Left.stl, DB_SW_Carriage_Right.stl, DB_VL_Carriage_Left.stl, DB_VL_Carriage_Right.stl, DFA_Extruder_Mount.stl, DFA_Mount.stl]
2023-11-18 Alternative_Voron_Mounts beta release
    [Boop_Front.step, Boop_Spacer.stl, boop_front.stl]
2023-11-18 KUSBA mount added
    [KUSBA_Mount.stl]
2023-11-21 Publish CAD
    [Lift-Off_Tophat_Hinges.step]
2023-11-23 Added Euclid Probe Mount
    [Euclid_Mount.stl]
2023-11-25 Fixed cowl orientation
    [Cowl_Klicky.stl, Cowl_KlickyNG.stl, Cowl_NoProbe.stl, Cowl_SlideSwipe.stl]
2023-12-04 Final release of the Voron mounts
    [Bottom_Spacers.stl, Main_Spacer.stl, Top_Spacer.stl, X_Carriage_MGN9H_Micron_Long.stl, X_Carriage_MGN9H_Micron_Short.stl]
2023-12-04 Fixed RB Orbiter v2 pcb mount
    [Orbiter_v2_Carrier_RB_36.stl]
2023-12-04 DB Ornament for 2023
    [3010_Fan.stl, 4010_Blower_x2.stl, DB_Ornament.step, [a]_Cowl.stl, [a]_Hanger.stl, [a]_Revo Voron.stl]
2023-12-07 Duct Testing
    [Overhang_Shuriken_Parametric.step, Shuriken_55.stl, Shuriken_85.stl]
2023-12-10 KlickyNG Mount
    [KlickyNG_Front_Mount.stl, KlickyNG_Main_Mount.stl]
2023-12-12 Updated Tap_Extruder_Spacer.stl
    [Tap_Extruder_Spacer.stl]
2023-12-15 Added missing Neopixel soldering jig
    [NeoPixel_Soldering_Jig.stl]
2023-12-18 Updated Sherpa Micro mount
    [Sherpa_Micro_Mount.stl]
2024-01-03 Added Micron/Pandora mounts for 9mm belts and for MGN9C rails
    [MGN12H_X_Carriage_Lite_9mm.stl, MGN12H_X_Carriage_Lite_Lugs_9mm.stl, X_Carriage_MGN9C_Micron_Long.stl, X_Carriage_MGN9C_Micron_Short.stl]
2024-01-04 Bambu Labs hotend mount update
    [Bambu_Mount.stl]
2024-01-07 Fixed missing mountpoints
    [Orbiter1.5_Mount_Front.stl, Orbiter2_Mount_Front.stl, Sherpa_Micro_Mount_Front.stl, Sherpa_Mini_Mount_Front.stl]
2024-01-07 Added Salad Fork Cowl and Diffuser
    [SaladForkBody.stl, [c]_SaladFork_Diffuser.stl]
2024-01-08 Added PFA cowl and diffuser CAD
    [PFA_Cowl.step]
2024-01-09 PFA/Micron/SF Cat Cowls
    [CatCowl._NoProbestl.stl, CatCowl_NoProbe.stl, Cowl._NoProbestl.stl, Cowl_NoProbe.stl, PFA_Cowl.step, SaladForkBody.stl, [c]_PFA_Diffuser.stl]
2024-01-09 Moved specific logo diffusers to the respective cowl dirs
    [[c]_Micron_Diffuser.stl, [c]_PFA_Diffuser.stl, [c]_SaladFork_Diffuser.stl]
2024-01-19 Added SaladFork and PFA cowls
    [CatCowl_NoProbe.stl, CatCowl_Noprobe.stl, Cowl_NoProbe.stl, Cowl_Noprobe.stl, [c]_Micron_Diffuser.stl, [c]_PFA_Diffuser.stl, [c]_SaladFork_Diffuser.stl]
2024-01-30 Alternative v0.2 Mounts
    [Belt _Hex_Nut.stl, Belt _MakerBeam_Nut.stl, Belt _Square_Nut.stl, X_Carriage_MGN7H_Base.stl, X_Carriage_MGN7H_Pins.stl, X_Carriage_MGN7H_Switch.stl, X_Carriage_MGN9C_Base.stl, X_Carriage_MGN9C_Pins.stl]
2024-02-16 Fixed heat insert hole widths for the Sherpa Micro v6 volcano mount
    [Sherpa_Micro_Mount_Back.stl, Sherpa_Micro_Mount_Front.stl]
2024-02-20 Extended Extruder Mount Reorientation
    [DFA_Extruder_Mount.stl, G2SA_Orbiter_Mount.stl, G2SA_Sherpa_Mount.stl, LGX_Lite_Mount.stl, LGX_Mount.stl, Orbiter1.5_Extruder_Mount.stl, Orbiter2_Extruder_Mount.stl, Sherpa_Micro_Extruder_Mount.stl]
2024-05-03 STL Re-organisation
    [Bambu_Mount.stl, DFA_Mount.stl, Dragon_Ace_HF_Mount.stl, Dragon_Mount.stl, Dragonfly_BMS_7fin.stl, Dragonfly_Mount.stl, G2SA_Orbiter_Mount.stl, G2SA_Sherpa_Mount.stl]
2024-05-04 Move the furniture around
    [CatCowl_NoProbe.stl, Cowl._NoProbestl.stl, Cowl_Klicky.stl, Cowl_KlickyNG.stl, Cowl_NoProbe.stl, Cowl_SlideSwipe.stl, Cowl_ZeroClick.stl, RoundTrip_Mount.stl]
2024-05-05 Fix filename
    [Cowl_NoProbestl.stl]
2024-05-05 Fixed filename
    [Cowl_NoProbe.stl]
2024-05-27 Updated Mounts
    [Tap_Main_Spacer_New_Bottom.stl, Tap_Main_Spacer_New_Top.stl, Tap_Main_Spacer_Old.stl, X_Carriage_MGN9C_Micron_Long.stl, X_Carriage_MGN9C_Micron_Short.stl]
2024-05-29 CraneFly Effector
    [DragonAce_Mount.stl, Dragon_Mount.stl, Effector Plate.stl, Effector_Cage.stl, KlickyPCB_Mount.stl, Lens.stl, Lens_Carrier.stl, RapidoHF_Mount.stl]
2024-05-29 Identify part colours
    [[a]_Effector_Cage.stl, [c]_Lens.stl, [o]_Lens_Carrier.stl]
2024-05-29 Mount updates
    [Bambu_Mount.stl, Effector Plate.stl, KlickyPCB_Mount.stl, Klicky_Mount.stl, Lens.stl, Lens_Carrier.stl, [a]_Effector_Cage.stl]
2024-06-01 Yavoth Toolhead
    [ADXL_Mount_Front.stl, Cowl_Dragon_Micro.stl, Cowl_Dragon_OB2.stl, Cowl_Dragon_SM.stl, Cowl_Revo_Micro.stl, Cowl_Revo_OB2.stl, Cowl_Revo_SM.stl, Cowl_Revo_WWBMG.stl]
2024-06-02 Fixed missing HE mounts points
    [Cowl_Dragon_Micro.stl, Cowl_Revo_Micro.stl]
2024-06-08 Geometry and mount point improvements
    [Effector Plate.stl, [a]_Effector_Cage.stl]
2024-06-08 Renamed file
    [Effector_Plate.stl]
2024-06-11 Fixed mounting holes on the plate and cage
    [Effector Plate.stl, [a]_Effector_Cage.stl]
2024-06-11 Updated probe mounts
    [Effector Plate.stl, KlickyPCB_Mount.stl, Klicky_Mount.stl, [a]_Effector_Cage.stl]
2024-06-11 Added PCB board mounts
    [PCB_Mount.stl, Strain_Relief_PCB.stl]
2024-06-14 Raised the height of the LED mounts
    [LED_Holder.stl, LED_Holder_Dummy.stl]
2024-06-20 CraneFly BETA2
    [Bambu_Mount.stl, DragonAce_Peck_Mount.stl, Dragon_Peck_Mount.stl, Effector Plate.stl, Effector_Plate.stl, Effector_Plate_Nuts.stl, KlickyPCB_Mount.stl, LGX_Lite_Mount.stl]
2024-06-22 PCB_Bowden support added
    [Strain_Relief_PCB_Bowden.stl]
2024-06-28 5mm offset cowl
    [Cowl_Dragon_Micro_5mm.stl, Cowl_Dragon_OB2_5mm.stl, Cowl_Dragon_SM_5mm.stl, Cowl_Revo_Micro_5mm.stl, Cowl_Revo_OB2_5mm.stl, Cowl_Revo_SM_5mm.stl]
2024-06-29 Minor modifications to the effector cage
    [[a]_Effector_Cage.stl]
2024-06-30 Bowden mount added
    [Bowden_Mount.stl]
2024-07-03 Dragon Burner Cutter
    [Bottom.stl, Carrier_Lever.stl, Carrier_Top.stl, Cutter_Mount.stl, Cutter_Mount_Extended.stl, Lever_Link.stl, Push_Lever.stl, Top_LGXLite_Hextrudort.stl]
2024-07-03 Yavoth Beta v2
    [Cowl_Dragon_Micro.stl, Cowl_Dragon_Micro_5mm.stl, Cowl_Dragon_OB2.stl, Cowl_Dragon_OB2_5mm.stl, Cowl_Dragon_SM.stl, Cowl_Dragon_SM_5mm.stl, Cowl_Revo_Micro.stl, Cowl_Revo_Micro_5mm.stl]
2024-07-05 Resized Dragon Mount Holes
    [DragonAce_Mount.stl, Dragon_Mount.stl, RapidoHF_Mount.stl]
2024-07-05 Added left fan wire space
    [[a]_Effector_Cage.stl]
2024-07-05 Added more left-hand 4010 wire space
    [[a]_Effector_Cage.stl]
2024-07-05 Updated Peck Mounts
    [DragonAce_Peck_Mount.stl, Dragon_Peck_Mount.stl, RapidoHF_Peck_Mount.stl]
2024-07-06 Added both DV and VD logo parts
    [Strain_Relief.stl, Strain_Relief_DV.stl, Strain_Relief_PCB.stl, Strain_Relief_PCB_Bowden.stl, Strain_Relief_PCB_Bowden_DV.stl, Strain_Relief_PCB_Bowden_VD.stl, Strain_Relief_PCB_DV.stl, Strain_Relief_PCB_VD.stl]
2024-07-06 UHF Cowls Added
    [Cowl_Revo_Micro_UHF.stl, Cowl_Revo_Micro_UHF_5mm.stl, Cowl_Revo_OB2_UHF.stl, Cowl_Revo_OB2_UHF_5mm.stl, Cowl_Revo_SM_UHF.stl, Cowl_Revo_SM_UHF_5mm.stl]
2024-07-06 Fixed incorrect part name
    [Cowl_Dragon_Micro_UHF.stl, Cowl_Dragon_Micro_UHF_5mm.stl, Cowl_Dragon_OB2_UHF.stl, Cowl_Dragon_OB2_UHF_5mm.stl, Cowl_Dragon_SM_UHF.stl, Cowl_Dragon_SM_UHF_5mm.stl]
2024-07-16 Missing UHF LED Holder
    [LED_Holder_Dummy _UHF.stl, LED_Holder_UHF.stl]
2024-07-16 Fixed 4010 fan mounts
    [Cowl_Dragon_Micro_UHF.stl, Cowl_Dragon_Micro_UHF_5mm.stl, Cowl_Dragon_OB2_UHF.stl, Cowl_Dragon_OB2_UHF_5mm.stl, Cowl_Dragon_SM_UHF.stl, Cowl_Dragon_SM_UHF_5mm.stl]
2024-08-21 Yavoth v1 Release + CAD
2024-10-27 Added E3D Roto Vitamins extruder to list
2025-10-09 Chube Compact mounts added
    [Chube_Compact_Mount.stl]
2025-10-10 Yavoth Chube Compact Support
    [Chube_Compact_Spacer.stl, Cowl_Chube_Compact_Micro.stl, Cowl_Chube_Compact_Micro_5mm.stl, Cowl_Chube_Compact_Micro_UHF.stl, Cowl_Chube_Compact_Micro_UHF_5mm.stl, Cowl_Chube_Compact_OB2.stl, Cowl_Chube_Compact_OB2_5mm.stl, Cowl_Chube_Compact_OB2_UHF.stl]
2025-11-30 Unicorn No Probe Cowl
    [Cowl_NoProbe.stl]
